karnza007/esp32_iot_gateway/docs/reports/2026-11-08-design.md

# Design report: the HDMI spectrum and spectrogram demo (week ending 2026-11-08)

> **What this is.** A complete explanation of the design as it runs on the Tang Nano 20K after
> this week's work (first written for commit `0211e95`, 2026-11-04; brought up to date for commit
> `eda5531`, 2026-11-07): how the microphone is sampled, how the FFT is fed and read, how every
> memory in the chip is used, how the three screens (bars, spectrogram, waveform) are drawn pixel
> by pixel, and how music from the laptop reaches the board's speaker. Each part has its own
> section, readable on its own.
> What changed this week and how it was tested step by step is in the weekly report,
> `docs/reports/2026-11-08.md`.

**The design in numbers**

| | |
|---|---|
| Board | Tang Nano 20K (Gowin GW2AR-18C) |
| Input | INMP441 MEMS microphone, I2S, pins 25 (SCK), 26 (WS), 29 (SD) |
| Output | HDMI, 1280 × 720 at 60 frames per second |
| Sample rate | **22,310.7 Hz** (0 – 11.2 kHz on screen) |
| FFT | Gowin FFT IP, 1,024 points, one every **512 samples** (50 % overlap): **43.6 per second** |
| Screens | **spectrogram** (the last 5.9 s, at power-up) → **bars** (the latest spectrum) → **waveform** (the last 45.9 ms): S1 steps, and they rotate by themselves every **6 s** (the pin-27 button freezes / resumes) |
| Music out | songs from the laptop (`host/play_song.py`) over the board's own USB cable (BL616 serial port, pins 70/69) → 24,170 Hz mono → the board's MAX98357A amplifier and speaker (§12A) |
| Resources | 3,153 logic (16 %), 1,415 registers (9 %), **43 / 46 block RAMs (93 %)**, 7.75 / 24 DSP |
| Timing | needs 74.25 MHz, achieves **77.2 MHz** (4 % spare) |

---

## Contents

0. [The whole design on one page](#0-the-whole-design-on-one-page)
1. [Clocks and reset](#1-clocks-and-reset)
2. [Sampling the microphone](#2-sampling-the-microphone)
3. [Gain and clamp](#3-gain-and-clamp)
4. [Storing samples: the ring buffer](#4-storing-samples-the-ring-buffer)
5. [Window and FFT](#5-window-and-fft)
6. [From FFT result to bar height](#6-from-fft-result-to-bar-height)
7. [Bars display](#7-bars-display)
8. [Spectrogram display](#8-spectrogram-display)
- 8A. [Waveform display](#8a-waveform-display-wave_displayv-2026-11-06)
9. [Peak readout](#9-peak-readout)
10. [Text, font and tick marks](#10-text-font-and-tick-marks)
11. [Putting the picture together and sending it over HDMI](#11-putting-the-picture-together-and-sending-it-over-hdmi)
12. [Buttons and LEDs](#12-buttons-and-leds)
- 12A. [Music from the laptop to the speaker](#12a-music-from-the-laptop-to-the-speaker-2026-11-06)
13. [RAM map: every memory in the chip](#13-ram-map-every-memory-in-the-chip)
14. [Resources and timing](#14-resources-and-timing)
15. [How it was verified](#15-how-it-was-verified)
- [Appendix A: glossary](#appendix-a-glossary)

---

## 0. The whole design on one page

```
                          ┌───────────────────────────── 74.25 MHz (pclk): everything below ─────────────────────────────┐
 INMP441                  │                                                                                               │
 mic ──SD──▶ i2s_master_rx ─▶ gain24 ─▶ clamp ─▶ ring buffer ─▶ × Hann ─▶ Gowin FFT ─▶ power → log → height ─┬─▶ bar_display ─────────┐
     ◀─SCK,WS─┘  (24 bits)    (S2)     ±32700   2048 samples    window    1024 points   (8-stage pipeline)   ├─▶ spectrogram_display ─┤ mode
                                                [block RAM]    [ROM]     [block RAM]                        ├─▶ peak_readout ──┐     │ picks
                                                                                                             │                  ▼     ▼
                                                                    video_timing ─ x, y ─▶ (all displays)    │          text_overlay ─▶ hdmi_out ─▶ HDMI
             (the gained samples) ─────────────────────────────────────────────────────────▶ wave_display ──────────────▶ (3rd picture)   (TMDS, 10:1
                                                                                                             │                           serializers)
 27 MHz crystal ─▶ PLL ×55÷4 = 371.25 MHz ─▶ ÷5 = 74.25 MHz        buttons S1 (mode), S2 (gain),            └──────────────────────────────────────┘
                                                                   pin 27 (rotate / freeze) ─▶ LEDs

 Music, separate from all of the above (§12A):
 laptop play_song.py ─USB─▶ BL616 ─pin 70─▶ uart_rx ─▶ audio_rx [2,048-sample buffer] ─▶ i2s_tx ─pins 54-56─▶ MAX98357A ─▶ speaker
                                  ◀─pin 69── uart_tx ◀── credits "C", status "S"              PA_EN (pin 51) ─┘
```

**Files** (all in `fpga_fft/src/`; `i2s_master_rx.v` is shared with the audio project in `fpga/src/`):

| Part | File | Section |
|---|---|---|
| Top level, buttons → mode/gain/rotation, LEDs | `top_hdmi.v`, `hdmi/buttons.v` | 1, 12 |
| The chain, wiring all parts | `hdmi/video_h3.v` | 0 |
| Microphone | `hdmi/mic_source.v`, `fpga/src/i2s_master_rx.v`, `hdmi/gain24.v` | 2, 3 |
| Ring buffer, window, FFT, heights | `hdmi/spectrum.v`, `hdmi/rom_hann.v`, `fft/fft_1024.vo` (Gowin IP) | 4, 5, 6 |
| Bars | `hdmi/bar_display.v` | 7 |
| Spectrogram | `hdmi/spectrogram_display.v`, `hdmi/rom_spec.v` | 8 |
| Waveform | `hdmi/wave_display.v`, `hdmi/rom_wave.v` | 8A |
| Music to the speaker | `hdmi/audio_rx.v`, `hdmi/i2s_tx.v`, `uart_rx.v`, `fpga/src/uart_tx.v`; laptop: `host/play_song.py`, `host/make_test_song.py` | 12A |
| Peak readout | `hdmi/peak_readout.v` | 9 |
| Text | `hdmi/text_overlay.v`, `hdmi/rom_text.v`, `hdmi/rom_font.v`, `hdmi/rom_ticks.v` | 10 |
| Video timing and HDMI | `hdmi/video_timing.v`, `hdmi/hdmi_out.v`, `hdmi/tmds_encoder.v` | 11 |
| Generated tables | `fpga_fft/gen_h4_text.py` (text, font, ticks, colours, waveform grid), `gen_tables.py` (Hann, sine) | 10, 5 |
| Not built any more | `fpga_fft/archive/sweep_player.v` (the demo sweep; git tag `demo-sweep`) | – |

**One clock for everything.** Except the HDMI serializers, the whole design runs on one clock,
74.25 MHz. The audio path is slow (a sample every 3,328 clocks), but running it on the picture
clock means no data ever crosses between clocks, which removes a whole class of bugs. Only a few
signals come from outside without a clock: the microphone's SD wire, the buttons and the serial
line from the laptop (pin 70); each goes through a two-flip-flop synchroniser first.

---

## 1. Clocks and reset

```
27 MHz crystal (pin 4) ──▶ rPLL ×55 ÷4 ──▶ 371.25 MHz (fclk) ──▶ HDMI serializers only
                                              └──▶ CLKDIV ÷5 ──▶ 74.25 MHz (pclk) ──▶ everything else
```

| Clock | Value | Why this value |
|---|---|---|
| pclk | **74.25 MHz** | the pixel rate the HDMI standard fixes for 1280 × 720 at 60 Hz: 1,650 × 750 slots × 60 |
| fclk | 371.25 MHz = 5 × pclk | each pixel is sent as 10 bits per colour; the serializer sends 2 bits per fclk cycle (both edges), 5 × 2 = 10 |

**Reset.** The PLL takes a moment to lock onto the crystal. Until it reports `locked`, and for 16
pixel clocks after that, the whole picture chain is held in reset (`top_hdmi.v`, `vrst`).

---

## 2. Sampling the microphone

### 2.1 How I2S works

The INMP441 is a digital microphone: it has its own converter inside and sends finished numbers
over three wires. The FPGA is the **master**: it makes both clocks; the microphone only answers
on SD.

```
 SCK  ─┐_┌─┐_┌─┐_┌─┐_┌─┐_┌─ ... (1.428 MHz: one bit per period)
 WS   ──┐______________________________ ... ________┌────────── ... (left half | right half)
 SD   ────< 23 >< 22 >< 21 >  ...  < 0 >── (24 bits, MSB first, then nothing)
        bit:  1     2     3          24         ... 32 (WS low: left)       33 ... 64 (right, unused)
```

| Wire | Driven by | What it does |
|---|---|---|
| **SCK** (bit clock) | FPGA | one data bit per period |
| **WS** (word select) | FPGA | low = left word, high = right word; one full low+high period = **one sample** |
| **SD** (serial data) | mic | the sample, 24 bits, most significant bit first. The mic's L/R pin is tied to ground, so it talks in the **left** half only |

### 2.2 The numbers: why 22,311 Hz

```
SCK = 74.25 MHz ÷ 52 = 1.4279 MHz           (MIC_BCLK_DIV = 52 in video_h3.v)
one sample = 64 SCK periods (32 left + 32 right)
fs  = 74.25 MHz ÷ (52 × 64) = 74,250,000 ÷ 3,328 = 22,310.7 samples per second
```

- A new sample arrives every **3,328 pixel clocks** (44.8 µs).
- The highest frequency that can be seen is half the sample rate: **11,155 Hz**.
- The INMP441 accepts SCK between 0.5 and 3.2 MHz; 1.43 MHz is comfortably inside.
- The rate is an exact integer division of the crystal, so it is as steady as the crystal.

### 2.3 How `i2s_master_rx.v` makes the clocks and reads the bits

| Step | How |
|---|---|
| SCK | a counter `div_cnt` counts 0 … 51 and repeats. SCK is high while the count is below 26, low after. SCK comes **out of a flip-flop**, never straight from the comparison: a comparison can flicker for a nanosecond while its inputs settle, and on a pin the mic would count that flicker as an extra bit (this was a real bug, found 2026-10-14). |
| Bit number | `bit_cnt` (6 bits) counts SCK periods 0 … 63 and wraps: one wrap = one sample |
| WS | high for bits 32 … 63. It changes on the **falling** edge of SCK, half a bit early, as the I2S standard requires, so it is steady when the mic reads it on the rising edge (also a real bug fix, 2026-10-14). |
| SD in | passes two flip-flops first (`sd_meta`, `sd_sync`): the mic's edges are not related to our clock, and the synchroniser stops an undecided level from spreading |
| Reading a bit | at count 13, the **middle of SCK's high half**, when the mic's output has long settled |
| Which bits | bits 1 … 24 of the frame (the mic starts its MSB one bit after WS falls). Each is shifted into `word24` |
| Output | after the 24th bit: `sample24` = the whole 24-bit word, and `sample_valid` is high for one clock. Bits 25 … 64 are clocked out normally (the mic needs complete frames) but ignored |

**Memory used:** none. A 24-bit shift register and a few counters.

---

## 3. Gain and clamp

### 3.1 Gain: choosing 16 of the 24 bits (`gain24.v`, button S2)

The mic gives 24 bits, the FFT takes 16. Instead of always keeping the top 16 bits and
multiplying, the gain **slides a 16-bit window down** the 24-bit word:

```
24-bit word:  [23 22 21 20 19 18 17 16 15 14 13 12 11 10  9  8  7  6  5  4  3  2  1  0]
gain 0 (×1)    └────────────────── bits 23 … 8 ──────────────────┘
gain 4 (×16)               └────────────────── bits 19 … 4 ──────────────────┘
gain 7 (×128)                       └────────────────── bits 16 … 1 ──────────────────┘
```

- Done as an arithmetic shift right by `8 − gain`. Each step is ×2 = **+6 dB**; 0 … +42 dB.
- Taking lower bits uses the microphone's real fine detail, not a multiplied coarse value.
- If the shifted value does not fit in 16 bits (a loud sound at high gain), it is **held at the
  limit** (+32,767 or −32,768) instead of wrapping around, and `clipped` pulses.

### 3.2 Clamp (`spectrum.v`)

Before the FFT, every sample is limited to **±32,700**. The Gowin FFT core gives wrong results
for inputs near −32,768 (found in the FFT benchmark, `docs/11-fft-benchmark.md`); 32,700 keeps
clear of that.

**Memory used:** none.

---

## 4. Storing samples: the ring buffer

### 4.1 What it is

The FFT needs **1,024 samples at once**, but they arrive one at a time, 44.8 µs apart. They are
kept in a **ring buffer**: a memory of 2,048 places, written in order, starting again at 0 after
2,047, so the newest samples always overwrite the oldest.

```
 buf_mem (2,048 × 16 bits, block RAM)                         wptr = where the next sample goes
 ┌──────────────────────────────────────────────────────────────────────┐
 │ ... older ... │◀────────── the latest 1,024 samples ──────────▶│ next │ ... free (will be overwritten) ...
 └──────────────────────────────────────────────────────────────────────┘
                 ready_base = wptr − 1023                        wptr
```

| Property | Value |
|---|---|
| Memory | `buf_mem`, **2,048 × 16 bits = 32,768 bits = 2 block RAMs**, semi-dual-port (one write port, one read port) |
| Stored | **raw** samples (after gain and clamp, before the window) |
| Written by | the sample path: one write per sample, every 3,328 clocks, at `wptr`, which then counts up (11 bits, so it wraps at 2,048 by itself) |
| Read by | the FFT feeder (§5): 1,024 reads in a row, starting at `rbase` |

### 4.2 When an FFT starts (50 % overlap)

A counter `hop_cnt` counts samples. Every **512** samples (`OVERLAP = 1`), once the first 1,024
have arrived, `block_ready` pulses and `ready_base = wptr − 1023` marks where the latest 1,024
samples begin.

```
samples:   0 ──────── 512 ──────── 1024 ──────── 1536 ──────── 2048 ──────── 2560 ...
FFT 0:     [═══════════════════════]                                   (samples 0 – 1023)
FFT 1:                [═══════════════════════]                        (512 – 1535)
FFT 2:                             [═══════════════════════]           (1024 – 2047)
FFT 3:                                          [═══════════════════════]   (1536 – 2559)
           each FFT shares half its samples with the one before
```

| | Without overlap (`OVERLAP = 0`) | **With overlap (the demo)** |
|---|---|---|
| New FFT every | 1,024 samples = 45.9 ms | **512 samples = 22.9 ms** |
| FFTs per second | 21.8 | **43.6** |

### 4.3 Why the ring holds raw samples

With overlap, every sample is used by **two** FFTs, and it sits at a different place in each
(first half in one, second half in the other), so it gets a **different window value** each time.
The window can therefore not be applied once when storing; it is applied when the FFT reads
(§5.1). (Until 2026-11-04 the window was applied when storing, which is only right without
overlap.)

### 4.4 Why nothing is ever overwritten too early

The FFT reads the latest 1,024 samples in 1,024 clocks, and is finished with them after
7,190 clocks. In that time only 2 – 3 new samples arrive, and they go into the *other* 1,024
places of the ring. The next FFT starts 1.7 million clocks later. If an FFT were ever still
busy when the next block was ready, the `overrun` flag would be set and LED 4 would light; it
never does.

---

## 5. Window and FFT

### 5.1 The Hann window

Each block is multiplied by the **Hann window**, a smooth bump that is 0 at both ends and 1 in
the middle:

```
window(i) = 0.5 − 0.5 cos(2π i / 1024),   i = 0 … 1023      stored as 0 … 32,767 (Q15)
```

**Why:** the FFT assumes the block repeats forever. If a block starts and ends at different
levels, the jump between the copies spreads energy over all frequencies ("leakage"), and a
pure tone shows as a wide smear. Fading the ends to zero removes the jump.

| Property | Value |
|---|---|
| Memory | `rom_hann`, **1,024 × 16 bits, 1 block RAM used as ROM** (the contents are part of the bitstream; generated by `gen_tables.py`) |
| Read | with the same address `i` as the sample, at the same clock |
| Arithmetic | `sample × window ÷ 32,768`, one DSP multiplier: the product's bits 30 … 15 |

### 5.2 Feeding the Gowin FFT core

The FFT core is Gowin's IP (`fft_1024`, configured in `fft/fft_1024.ipc`: 1,024 points, 16-bit
input, 16-bit twiddle factors, low-resource mode, results in natural order). It is a radix-2
FFT: 10 stages of 512 "butterflies" each (see the benchmark, `docs/11-fft-benchmark.md` §9.2a).

The core **asks** for its input: after a `start` pulse it raises `ipd` (input phase) and shows
which sample it wants on `idx`. Our block RAMs answer one clock after they are given an
address, so the feeder addresses one sample **ahead**:

```
clock:            t          t+1          t+2
core wants idx:   i          i+1          i+2
we address:       i+1        i+2          i+3        ← ridx = idx + 1 (0 while not ipd)
RAM answers:      sample i   sample i+1   ...        ← rd_q and hann arrive together
into the core:    rd_q × hann ÷ 32768  (sample i)   ← the multiply is between the RAM and the core
```

- Ring address = `rbase + ridx` (11 bits, wraps around the ring by itself).
- Window address = `ridx` (the position inside the block).
- `xn_im` (the imaginary input) is 0: the microphone signal is real.

### 5.3 What the core does and how long it takes

| | |
|---|---|
| Input | 1,024 real samples |
| Output | 1,024 complex numbers `xk_re + j·xk_im`, in order: bin k = frequency k × fs / 1024 = **k × 21.79 Hz** |
| Scaling | divided by 2 at each stage, so results stay within 16 bits |
| Time | **7,190 clocks = 96.8 µs** from `start` to the last result: **0.4 %** of the 22.9 ms between FFTs |
| Output handshake | `opd` (output phase) high while results come out, one per clock, `idx` = bin number; `eoud` = last one |

**The core's own memory** (its source is encrypted; the build report shows its totals):

| Memory | Count | Most likely use |
|---|---|---|
| **True dual-port block RAM** (DPB) | 4 | the working values: a butterfly reads two values and writes two back in place, so it needs two ports that can each read **or** write. (This is why the Tang Nano 4K cannot build this core: it has no true dual-port RAM.) |
| Block RAM as ROM (pROM) | 2 | the twiddle factors (cos and sin values for the butterflies) |
| Small logic RAMs (RAM16SDP4) | 3 | small internal buffers, 16 × 4 bits each |

### 5.4 Only half the bins are kept

For a real input, bins 513 … 1023 are mirror images of bins 1 … 511. Only bins **0 … 511**
(0 – 11.1 kHz) are kept. That is where the 512 bars and the 256 spectrogram rows come from.

---

## 6. From FFT result to bar height

### 6.1 The pipeline

As the core outputs one bin per clock, an **8-stage pipeline** turns each bin into a height in
pixels. Every stage is one clock; a new bin enters every clock, so 512 bins take 512 + 8 clocks.

| Stage | Register | Computes |
|---|---|---|
| 1 | `re1`, `im1`, `a1` | keep bins 0 … 511 |
| 2 | `sq_re`, `sq_im` | re², im² (two DSP multipliers) |
| 3 | `pw` | **power** P = re² + im² (32 bits) |
| 4a | `e4`, `m4` | position `e` of P's highest 1 bit, and the 5 bits just below it |
| 4b | `L` | **L = 32 · log₂ P** ≈ 32·e + table(5 bits) (a 32-entry table) |
| 5 | `hm` | 361 · L (one DSP multiplier) |
| 6 | `bar_h` | height = (361 L − 39,587) / 512, limited to 0 … 600 px |
| out | `bar_we`, `bar_addr`, `bar_h`, then `bar_done` | one height per clock; `bar_done` pulses after the 512th |

### 6.2 The decibel scale

```
dB      = 10 · log10(P) − 90.31          (0 dB = a bin of 32,767, the largest possible)
height  = 7.5 px per dB, 0 dB at 600 px, −80 dB at 0 px  →  height = 75 · log10(P) − 77.32
log10 P = L / 32 · 0.30103               →  height = (361 · L − 39,587) / 512
```

- The log uses only a top-bit search and a 32-entry table: no division, no big multiplier.
- Anything quieter than −80 dB gets height 0 ("the floor").
- Stage 4 used to be one stage; in one clock it took 13.24 of the 13.47 ns available, so it was
  split into 4a and 4b (weekly report §8).

**Memory used:** none (the 32-entry log table is logic).

**Where the heights go.** The same stream (`bar_we`, `bar_addr`, `bar_h`, `bar_done`) goes to
three places at once: the bars display (§7), the spectrogram (§8) and the peak readout (§9).

---

## 7. Bars display

### 7.1 Layout

```
 y =  60 ─ 0 dB   ┌──────────────────────────────────────────────┐   gridlines every 20 dB:
 y = 210 ─ -20 dB │                                              │   y = 60, 210, 360, 510, 660
 y = 360 ─ -40 dB │      ▌                                       │
 y = 510 ─ -60 dB │      ▌ ▌        ▌                            │   512 bars, 2 px wide each:
 y = 660 ─ -80 dB └▌▌▌▌▌▌▌▌▌▌▌▌▌▌▌▌▌▌▌▌▌▌▌▌▌▌▌▌▌▌▌▌▌▌▌▌▌▌▌▌▌▌▌▌┘   x = 128 … 1151
                  0 kHz                                      11 kHz    bar k: x = 128 + 2k, 129 + 2k
```

### 7.2 The memory: a double buffer

| Property | Value |
|---|---|
| Memory | `mem`, **1,024 × 10 bits = 1 block RAM**, semi-dual-port |
| Layout | two halves of 512 heights: address = {half, bin} |
| Written by | the height pipeline, into the **back** half: `mem[{~front, bar_addr}] = bar_h` |
| Read by | the screen, from the **front** half |

**Why two halves.** The screen draws a frame top to bottom over 16.7 ms; a new set of 512
heights arrives in 512 clocks (7 µs) at any moment. If the screen read the half being written,
part of a frame would show the old spectrum and part the new one. So new heights go into the
back half, and when a set is complete (`bar_done` → `pending`), the halves **swap** at the start
of the vertical blanking (`x = 0, y = 720`), when nothing visible is being drawn.

### 7.3 How a pixel is drawn (2 clocks)

| Clock | Does |
|---|---|
| 1 | bar number = (x − 128) / 2; read `h = mem[{front, bar}]` |
| 2 | **green** (00DC5A) if x is in 128 … 1151 and 660 − h ≤ y < 660; else **grey** (464646) on a gridline row; else black |

---

## 8. Spectrogram display

> Updated 2026-11-06: 32 levels of 1 dB with viridis colours (was 16 levels of 5 dB, inferno),
> and two frequency zones (was 2 bins per row everywhere). Weekly report §13–14.

### 8.1 What it shows

Every FFT becomes one **column** of a picture: time runs left to right (newest at the right
edge), frequency bottom to top, colour = level. The last 256 FFTs are shown: 256 × 22.9 ms =
**5.9 s**.

```
 kHz                                                   dB
 10 ┤ ░░░░░░░░░░░░░░░░░░░░░░░░░░░░░░░░░░░░░░░░░░░░░ ┃□┃ >-50    plot: x 128 … 1151, y 148 … 659
  6 ┤ ░░░░░░░░░░░░░░░░░░░░░░░░░░░░░░░░░░░░▄▀░░░░░░░ ┃▓┃ -50     4 … 11 kHz: rows 184 … 255 (28 %)
  4 ┤ ─ ─ ─ ─ ─ ─ ─ ─ ─ ─ ─ ─ ─ ─ ─ ─ ─ ─ ─ ─ ─ ─ ─ ┃▓┃         dashed line at the zone edge
  2 ┤ ░░░░░░░░░░░░░░░░░░░░░░░░░░░░░░▄▀▀░░░░░░░░░░░░ ┃▒┃ -70     0 … 4 kHz: rows 0 … 183 (72 %)
  0 ┤ ░░░░░░░░░░░░░░░░░░░░░░░░░░░░░░░░░░░░░░░░░░░░░ ┃░┃ -80     one point = 4 px wide × 2 px tall
    -5s        -4s       -3s       -2s       -1s    now          colour scale: x 1168 … 1183
```

### 8.2 Rows: two frequency zones

| Zone | Bins | Rows | One row | Height |
|---|---|---|---|---|
| 0 … 4.0 kHz | 0 … 183 | 0 … 183, row = bin | **one bin, 21.8 Hz** (the finest the 1024-point FFT gives) | 368 px (72 %) |
| 4.0 … 11.1 kHz | 184 … 511 | 184 … 255, row = 184 + (bin − 184) × 225 / 1024 (rounded down) | 4 or 5 bins, about 99 Hz | 144 px (28 %) |

Where a row holds several bins it keeps the **loudest**, so a thin tone is never lost. The cost:
the noise above 4 kHz looks a little louder than it is (on the board, 34 % of points black
there against 45 % just below 4 kHz).

### 8.3 Levels: one per dB

The height scale is 7.5 px per dB with −80 dB at height 0, so dB = height / 7.5 − 80.

| Level | dB | Colour |
|---|---|---|
| 0 | below −80 (height 0) | black: also hides the FFT's own rounding noise |
| 1 … 30 | −80 … −51, one per dB: level = height / 7.5 + 1 | matplotlib's "viridis": dark purple → blue → teal → green → yellow |
| 31 | −50 and louder (height ≥ 225) | white |

### 8.4 The memory: a 256 × 256 picture

| Property | Value |
|---|---|
| Memory | 65,536 × **5 bits** = 327,680 bits, kept as two memories: `mem_lo` 65,536 × 4 (**16 block RAMs**) + `mem_hi` 65,536 × 1 (**4 block RAMs**) = **20**, semi-dual-port |
| Why two | a single 5-bit memory could be built 8 bits wide (32 blocks), which would not fit |
| Layout | address = {column (8 bits), row (8 bits)}: 256 columns of 256 rows |
| Each entry | a **level** 0 … 31, not a colour: 5 bits instead of 24, which is what makes it fit |
| Written by | the height stream, one column per FFT |
| Read by | the screen, one point per pixel |

### 8.5 Writing a column (4 clocks)

The 512 heights arrive in bin order (`bar_we`, `bar_addr`, `bar_h`), then `bar_done`.

| Clock | How |
|---|---|
| A: row | bins 0 … 183: row = bin, and each is the last bin of its row. Bins 184 … 511: d = bin − 184, row = 184 + (d × 225) >> 10 (one DSP multiplier). The next bin starts a new row exactly when the low 10 bits of d × 225 are 799 or more (adding 225 then carries), so the same product also says "last bin of this row"; bin 511 is always last |
| B: loudest | keep the largest height of the current row (`acc`); at the row's last bin, pass it on |
| C: level | 0 if height is 0; 31 if height ≥ 225; else (height × 547) >> 12, + 1 (exactly height / 7.5, rounded down, for heights below 225; one DSP multiplier) |
| D: write | `mem_lo/mem_hi[{wcol, row}] = level`; after `bar_done`, `wcol` counts up by 1 (8 bits: after 255 comes 0) |

So after 256 FFTs the memory is full, and every new column **overwrites the oldest**.

### 8.6 Scrolling without moving anything

Moving 65,536 values every 22.9 ms would be slow and pointless. Instead, only **where the screen
starts reading** moves:

```
memory columns:   ... │ 41 │ 42 │ 43 │ 44 │ 45 │ ... (wcol = 44 is written next: it is the oldest)
screen columns:          ...  254   255 │  0    1  ...
                                 newest ┘  └ oldest       start = 44
screen column c shows memory column (start + c) mod 256
```

- `start` is copied from `wcol` once per frame, at the start of vertical blanking, so a frame
  never shows two scroll positions.
- The column being overwritten during a frame is always the oldest, at the left edge (screen
  column 0). It is drawn black, so its half-written state never shows.

### 8.7 How a pixel is drawn (2 clocks)

| Clock | Does |
|---|---|
| 1 | column = start + (x − 128) / 4, row = (659 − y) / 2; read `q = {mem_hi, mem_lo}[{column, row}]` |
| 2 | on y 291 inside the plot where x bit 2 is 0: **grey dash** (808080, the 4 kHz edge); inside the plot: **colour table[q]**; inside the scale (x 1168 … 1183): white for the top 32 px, then colour table[32 − (y − 148) / 16] (levels 30 … 1, 16 px each); on a tick mark: grey (808080); else black |

### 8.8 The colour table (`rom_spec.v`, logic)

32 entries: black, 30 viridis colours sampled evenly, white.

| Level | dB | Colour | Level | dB | Colour |
|---|---|---|---|---|---|
| 0 | below −80 | 000000 black | 16 | −65 | 1F948C |
| 1 | −80 | 440154 dark purple | 18 | −63 | 21A585 |
| 3 | −78 | 481A6C | 20 | −61 | 31B57B |
| 5 | −76 | 46307E | 22 | −59 | 50C46A green |
| 7 | −74 | 404588 | 24 | −57 | 77D153 |
| 9 | −72 | 38598C blue | 26 | −55 | A2DA37 |
| 11 | −70 | 2F6B8E | 28 | −53 | D2E21B |
| 13 | −68 | 297B8E | 30 | −51 | FDE725 yellow |
| 15 | −66 | 228C8D teal | 31 | −50 and louder | FFFFFF white |

(Every second level shown; the full list is `SPEC_RGB` in `gen_h4_text.py`.)

## 8A. Waveform display (`wave_display.v`, 2026-11-06)

The third screen: the raw samples, like an oscilloscope.

| Part | How |
|---|---|
| Samples | the same 16-bit samples the FFT gets (after the S2 gain, so S2 also zooms the wave) |
| Width | 1,024 samples = 45.9 ms (one FFT block), 1 px per sample, x 128 … 1151; ticks every 5 ms |
| Height | y 148 … 659, centre y 403. The edges are the peak of a tone reading **−40 dB** on the bars / spectrogram scale: 4 × 32,767 × 10^(−40/20) = **±1,311**. Offset = sample × 800 / 4096 (rounded down), limited to −256 … 255; y = 403 − offset. At an edge the trace is red |
| Grid | centre, the peaks of −50 dB (±414) and −60 dB (±131) tones, the edges (`rom_wave.v`) |
| Trigger | a capture starts where the wave crosses 0 going up (previous < 0, this ≥ 0), or after 1,024 samples without one, so a steady tone stands still |
| Memory | 2 × 1,024 offsets × 9 bits = **1 block RAM** (SDPX9B), double-buffered: a capture fills the back half, the halves swap in vertical blanking, then the next capture is armed (about 20 pictures per second) |
| Drawing (2 clocks) | read the column's offset; light the pixels from the previous column's height to this one's, so steep parts stay joined; else grid grey, tick grey, black |

---

## 9. Peak readout

Top right of every screen: the loudest frequency and its level, e.g. "1002 Hz / −23 dB", and
the gain.

| Step | How |
|---|---|
| ① Loudest bin of each FFT | while heights stream in, keep the tallest (skipping bins 0 – 1: the DC offset, which the window spreads into bin 1). At `bar_done`, store it as that FFT's peak |
| ② Show 4 times a second | every 2²⁴ clocks (0.23 s) the **latest** FFT's peak is taken, slow enough to read |
| ③ Frequency | Hz = bin × fs / 1024 = (bin × 1,427,884 + 32,768) >> 16, rounded to the nearest Hz |
| ④ Digits | 5 decimal digits, one per clock: n / 10 is done as (n × 52,429) >> 19 (a multiply instead of a divide); leading zeros become spaces |
| ⑤ Level | dB = height / 7.5 − 80: lvl = ((2h + 7) × 4,369) >> 16, two digits |
| ⑥ Output | 11 characters (77 bits, `dyn`): 5 for Hz, 4 for dB, 2 for the gain; "---" when nothing is above −80 dB |

**Memory used:** none (registers only). The 11 characters go to the text overlay (§10.4).

---

## 10. Text, font and tick marks

### 10.1 The text grid

The 1280 × 720 picture is divided into **80 × 45 cells of 16 × 16 pixels**. Each cell can hold
one character. A character is a 5 × 7 dot pattern inside an 8 × 8 box, drawn **2× larger**
(each dot is 2 × 2 pixels).

```
 cell (row, col) covers x = 16·col … 16·col+15, y = 16·row … 16·row+15
 inside a cell:  dot column = (x mod 16) / 2  (0 … 7),  dot row = (y mod 16) / 2  (0 … 7)
```

### 10.2 The three tables

| Table | File | Memory | Contents |
|---|---|---|---|
| **Text** | `rom_text.v` | **block RAM as ROM: 5 blocks** (7,200 × 9 bits used) | for every cell of both pages: which character, which colour. Address = page × 3,600 + row × 80 + column. Word = [8:7] colour, [6:0] ASCII code; codes 0 – 15 mean "live character k" (from the peak readout) |
| **Font** | `rom_font.v` | **block RAM as ROM: 1 block** (1,024 × 8 bits) | the dot pattern of every character: address = {ASCII code, dot row}, 8 bits = one row of 8 dots, leftmost dot = bit 7 |
| Tick lines (bars page) | `rom_ticks.v` | logic | is x one of the 12 kHz tick positions? |

All three are generated by `fpga_fft/gen_h4_text.py`, which also draws previews
(`docs/figures/h4_layout.png`, `h4_layout_spectrogram.png`). The kHz and time positions are
computed there from the sample rate, so they move by themselves if the rate changes.

**Two pages.** The text table holds a complete page per screen: page 0 = bars, page 1 =
spectrogram. S1 selects the page together with the picture.

### 10.3 How the display pulls out each character, clock by clock

This is the heart of the text drawing (`text_overlay.v`). For every pixel (x, y), four clocks:

```
 clock 1          clock 2               clock 3                    clock 4
 x, y ─▶ address ─▶ text ROM ─▶ code ──▶ (live? take from peak) ──▶ font ROM ─▶ 8 dots ─▶ pick dot ─▶ colour
         page·3600            colour       ASCII code + dot row        of this row   (x mod 16)/2
         + row·80 + col                                                                 
```

| Clock | What happens | Example: pixel (x 1174, y 90) on the bars page, PEAK showing " 1002 Hz" |
|---|---|---|
| 1 | cell row = y / 16, cell column = x / 16; address = page × 3,600 + row × 80 + column | row 5, column 73 → address 0 + 400 + 73 = 473 |
| 2 | the **text ROM** answers: colour and code | yellow, code 1 → "live character 1" |
| 3 | live? → take the character from the peak readout's `dyn` instead. Then the **font ROM** is addressed with {code, dot row = (y mod 16)/2} | live char 1 = the thousands digit = "1"; dot row = (90 mod 16) / 2 = 5 |
| 4 | the font answers 8 dots; pick dot (x mod 16)/2; if it is lit, the pixel gets the cell's colour | row 5 of "1" is `...#....`; dot (1174 mod 16) / 2 = 3 is lit → **yellow** FFD23C |

Because each step is a registered memory read, a new pixel enters every clock and the answer
comes out 4 clocks later. The sync signals (DE, HSYNC, VSYNC) are delayed by the same 4 clocks
(`video_h3.v`), so colour and position stay together.

**Colours:** 0 white (title), 1 light grey (axis labels), 2 yellow (peak readout), 3 cyan
(source, gain).

### 10.4 Live characters

Eleven cells show changing values (peak Hz, peak dB, gain). Their table entry is not a letter
but a number k = 0 … 10, meaning "show character k of `dyn`". The peak readout (§9) keeps `dyn`
up to date; the text ROM itself never changes.

### 10.5 Why the text table is in block RAM

Until 2026-11-04 the text table was built from logic (a big `case` statement): 400 logic cells,
11 cells deep, and the slowest path in the design (13.25 of 13.47 ns). A block RAM answers any
address in one clock with a short fixed delay, so the table now costs 5 block RAMs and no
logic, and the path is gone (weekly report §12).

---

## 11. Putting the picture together and sending it over HDMI

### 11.1 Video timing (`video_timing.v`)

Two counters run through **every slot of a frame**, visible or not:

```
 per line:   1280 visible + 110 front porch + 40 sync + 220 back porch = 1,650 slots
 per frame:   720 visible +   5 front porch +  5 sync +  20 back porch =   750 lines
 74.25 MHz / (1,650 × 750) = 60.00 frames per second
```

| Output | Meaning |
|---|---|
| x, y | current slot and line |
| DE | "data enable": inside the visible 1280 × 720 |
| HSYNC, VSYNC | the pulses that tell the monitor "new line" / "new frame" |

The blanking time (everything that is not visible) is where the bars swap halves and the
spectrogram takes its new scroll position.

### 11.2 Layers: who wins a pixel

Every clock, all displays work on the same (x, y). The final colour is chosen in this order:

| Priority | Layer | Source |
|---|---|---|
| 1 | outside the visible area → black | DE |
| 2 | **text** (a lit dot of a character) | text overlay §10 |
| 3 | kHz tick line (bars page, only where the picture is black) → dark grey 2A2A2A | `rom_ticks` |
| 4 | **picture**: bars (page 0), spectrogram (page 1) or waveform (page 2) | §7 / §8 / §8A, chosen by the mode |

All three pictures are computed all the time; the mode only chooses which one is passed on (and
which text page). That is why switching to the spectrogram shows its full history at once.

### 11.3 Sending the picture (`hdmi_out.v`, `tmds_encoder.v`)

```
 blue  + HSYNC, VSYNC ─▶ TMDS encoder ─ 10 bits ─▶ OSER10 ─▶ differential pair ─▶ HDMI data 0 (pins 35/36)
 green                ─▶ TMDS encoder ─ 10 bits ─▶ OSER10 ─▶ differential pair ─▶ HDMI data 1 (pins 37/38)
 red                  ─▶ TMDS encoder ─ 10 bits ─▶ OSER10 ─▶ differential pair ─▶ HDMI data 2 (pins 39/40)
 clock pattern 1111100000 ───────────────────────▶ OSER10 ─▶ differential pair ─▶ HDMI clock  (pins 33/34)
```

| Part | Does |
|---|---|
| **TMDS encoder** | turns each 8-bit colour into a 10-bit word chosen to have few transitions and an even balance of 1s and 0s (good for the cable). During blanking it sends one of four special words instead, which carry HSYNC and VSYNC (on the blue lane) |
| **OSER10** | Gowin's serializer inside the pin's I/O block: takes 10 bits per pixel clock and sends them one by one on both edges of fclk (371.25 MHz × 2 = 742.5 Mbit/s per lane) |
| **TLVDS_OBUF** | drives each bit as a differential pair (P and N) |

**Memory used:** none.

---

## 12. Buttons and LEDs

| Button | Pin | Does |
|---|---|---|
| **S1** | 88 | screen, in turn: spectrogram → bars → waveform → spectrogram (starts on the spectrogram; three screens since 2026-11-06) |
| **S2** | 87 | gain +6 dB, 0 → +42 dB, then back to 0 |
| external | 27 (to 3.3 V, pull-down) | auto-rotate on ↔ frozen: on (at power-up), the screen moves on every 6 s (10 s until 2026-11-07); S1 also restarts the count. (Earlier on 2026-11-06 it played the demo sweep, now archived; weekly report §15–17, §19) |

**Mode and rotation (`top_hdmi.v`).** `mode` is 2 bits: 0 = bars, 1 = spectrogram (power-up),
2 = waveform. "Next" steps 1 → 0 → 2 → 1 and happens when S1 is pressed, or, while rotation is on,
when a counter reaches 445,500,000 clocks (6.0 s; it was 742,500,000 = 10 s until 2026-11-07).
Every "next" and every press of the pin-27 button restarts the counter; the pin-27 button
toggles `rot_on` (1 at power-up).

**Debouncing (`buttons.v`).** A button's contact bounces for a few milliseconds. The input goes
through a synchroniser and is looked at only every 2¹⁸ clocks (3.5 ms); a press counts when it
reads "down" twice in a row after "up", and produces exactly one one-clock pulse.

| LED (lit = low) | Shows |
|---|---|
| 0 | on = spectrogram screen |
| 3 | on = waveform screen (LEDs 0 and 3 both off = bars) |
| 2 | the mic's SD wire is active (seen high and low in the last 56 ms) |
| 4 | trouble: an FFT overran, or the music had a bad packet, a gap or an underrun (last 56 ms) |
| 5 | the video PLL is locked |
| 1 | auto-rotate on |

---

## 12A. Music from the laptop to the speaker (2026-11-06)

Separate from the measuring chain: the music reaches the spectrogram only through the air
(speaker → microphone). Replaces the demo sweep (archived, weekly report §15–17).

```
 laptop                                   board
 play_song.py ──USB──▶ BL616 debugger ──pin 70──▶ uart_rx ─▶ packet check ─▶ buffer 2,048 ─▶ ×2 fill-in ─▶ i2s_tx ─▶ MAX98357A
   ffmpeg: any file → 24,170 Hz mono  (2nd serial channel)   2.97 Mbaud     (sum16)        (2 block RAMs)  48,340 Hz     pins 56/55/54
              ◀──────────── "C" per 256 samples played, "S" + 4 counters ◀── uart_tx ◀──pin 69                          PA_EN pin 51
```

### 12A.1 The link

| Part | How |
|---|---|
| Cable | the board's own USB-C cable: the BL616 debugger chip is both the programmer (1st channel, `/dev/cu.usbserial-…0`) and a USB serial port (2nd channel, `…1`) wired to FPGA pins 70 (in) and 69 (out) (pins from Sipeed's `TangNano-20K-example/uart`) |
| Speed | the laptop opens 3 Mbaud; the FPGA reads 74.25 MHz / 25 = 2.97 Mbaud (1 % apart) |
| Measured limits (weekly report §19) | laptop → FPGA: nothing lost in any test, up to **170 KB/s** in writes of 512 bytes or more; FPGA → laptop: clean only up to about 30 KB/s, so used for a few bytes only |
| Load | 24,170 Hz × 2 bytes + packet overhead = 52 KB/s (31 % of 170 KB/s) |

### 12A.2 Packets

```
 B5 6A | seq | s0 lo, s0 hi, s1 lo, … s31 hi | sum16 lo, sum16 hi        69 bytes = 32 samples
```

| Field | Meaning |
|---|---|
| `B5 6A` | sync: where a packet starts. After a broken byte the receiver looks for it again |
| seq | 0 … 254, then 0 again; a jump counts as a gap. **seq 255 = RESET**: empty the buffer and stop; answered "R" |
| samples | 32 × 16-bit signed, low byte first, 24,170 Hz mono |
| sum16 | the 64 sample bytes added up, mod 65,536. A packet with a wrong sum is dropped whole |

The samples are written into the buffer as they arrive, but the write pointer only moves past
them ("commit") when the sum is right, so a bad packet leaves no trace.

### 12A.3 Flow control by credits

The FPGA's clock decides the pace; the laptop only sends what fits.

| Step | |
|---|---|
| After RESET | the laptop may send 1,536 samples (the buffer holds 2,048; 512 stay spare) |
| Every 256 samples played | the FPGA sends "C" on pin 69: the laptop may send 256 more |
| Every 16th "C" | followed by "S" and four counters: bad sums, seq gaps, packets dropped for lack of room, underruns (each stops at 255) |

So the buffer cannot overflow, and the two crystals (laptop, board) never need to agree.

### 12A.4 Playing (`audio_rx.v`, `i2s_tx.v`)

| Part | How |
|---|---|
| Start | when the buffer holds 1,024 samples (42 ms at 24,170 Hz) |
| Fill-in | `i2s_tx` asks for a sample every output frame (48,339.8 Hz = 74.25 MHz / 1536); each received sample x serves two: x[n], then (x[n] + x[n+1]) / 2. The music keeps its 24,170 Hz content (up to about 11 kHz) without steps |
| Underrun | if the buffer is empty when a sample is needed, the last one is held and counted; after 4,096 empty frames (85 ms) playing stops (the song ended) and the output goes to 0 |
| I2S out | `i2s_tx.v` (from the archived sweep player, unchanged): BCLK 1.547 MHz, 32 bit clocks per frame, same sample on left and right, Philips format, WS and DIN changing when BCLK falls |
| PA_EN | on while there is data or music, and 100 ms after: the amplifier is off (silent) between songs |
| Trouble | a bad packet, a gap or an underrun lights LED 4 for one 56 ms window |

### 12A.5 The laptop side

| Script | Does |
|---|---|
| `host/play_song.py song [--volume dB]` | ffmpeg decodes any file to 24,170 Hz mono 16-bit (+0.2 s of silence), sends RESET and waits for "R", then sends packets 8 or more at a time as credits arrive; prints progress and the FPGA's counters; Ctrl-C sends RESET |
| `host/make_test_song.py` | a 14 s piano-like "Happy Birthday" (harmonics with fading envelopes) for testing |

Played on the board: "Happy Birthday" (14.2 s in 14.8 s) and Mozart's Rondo alla Turca
(193.6 s in 194.2 s), each with 0 bad sums, 0 gaps, 0 dropped, 0 underruns.

**Memory used:** the 2,048 × 16 buffer, 2 block RAMs (§13).

---

## 13. RAM map: every memory in the chip

### 13.1 The types of memory on the GW2AR-18C

| Type | On this chip | What it is | We use it for |
|---|---|---|---|
| **Block RAM (BSRAM)** | 46 blocks × 18 Kbit ≈ 100 KB | on-chip SRAM: no refresh, one access per clock per port, any address. Each block can be set up as one of the modes below | all buffers, pictures and tables (32 blocks) |
| ↳ **SDPB** (semi-dual-port) | | one port only writes, the other only reads, each with its own address, at the same time | **writer and reader are different parts of the design**: the sample path writes / the FFT reads; the FFT writes / the screen reads |
| ↳ **DPB** (true dual-port) | | two ports, each can read **or** write | the FFT core's working memory (a butterfly reads two values and writes two back) |
| ↳ **pROM** | | read-only; the contents are part of the bitstream | fixed tables: window, twiddles, font, text |
| **Shadow SRAM** (SSRAM, RAM16) | made from logic cells, 16 × 4 bits each | tiny RAMs | 3, inside the FFT core |
| Registers (flip-flops) | 15,750 | single values | pipelines, counters, the peak readout's 11 characters |
| **SDRAM** | 64 Mbit = 8 MB, inside the GW2AR package | dynamic RAM: needs refresh and a controller, several clocks per access, but very large | **not used**: everything fits on-chip, which is faster and simpler. It would only be needed for a much bigger picture |
| PSRAM | not on the Tang Nano 20K | (on the Tang Nano 4K and 9K) | – |
| SPI flash | 64 Mbit, on the board | keeps data with the power off; slow | holds the bitstream only |

### 13.2 Every memory, one table

| # | Memory | Module | Type | Shape | Bits | Blocks | Holds | Written | Read |
|---|---|---|---|---|---|---|---|---|---|
| 1 | Ring buffer `buf_mem` | spectrum | **SDPB** | 2,048 × 16 | 32,768 | **2** | raw samples (§4) | 1 sample per 3,328 clocks | 1,024 reads in a row per FFT, every 512 samples |
| 2 | Hann window | rom_hann | **pROM** | 1,024 × 16 | 16,384 | **1** | window values (§5.1) | never (bitstream) | with each ring read |
| 3 | FFT working memory | fft_1024 (Gowin) | **DPB** | (encrypted) | | **4** | values between butterfly stages | by the core | by the core |
| 4 | FFT twiddle factors | fft_1024 (Gowin) | **pROM** | (encrypted) | | **2** | cos/sin values | never | by the core |
| 5 | FFT small buffers | fft_1024 (Gowin) | SSRAM | 3 × (16 × 4) | 192 | 0 | internal | by the core | by the core |
| 6 | Bar heights `mem` | bar_display | **SDPB** | 1,024 × 10 (2 halves) | 10,240 | **1** | 512 heights × 2 (§7) | 512 per FFT, into the back half | 1 per 2 pixels, from the front half |
| 7 | Spectrogram picture `mem_lo` + `mem_hi` | spectrogram_display | **SDPB** | 65,536 × (4 + 1) | 327,680 | **20** (16 + 4) | 256 × 256 levels (§8) | 256 per FFT (one column) | 1 per 4 pixels |
| 8 | Text | rom_text | **pROM** | 10,800 × 9 (of 16,384) | 97,200 | **9** | 3 pages of 80 × 45 cells (§10; 2 pages and 5 blocks until 2026-11-06) | never (bitstream) | 1 per pixel |
| 9 | Font | rom_font | **pROM** | 1,024 × 8 | 8,192 | **1** | 128 characters × 8 rows of dots | never (bitstream) | 1 per pixel |
| 10 | Music buffer `mem` | audio_rx | **SDPB** | 2,048 × 16 | 32,768 | **2** | 85 ms of music from the Mac (weekly report §19) | 32 samples per good packet | 1 per 2 output frames (24,170 Hz) |
| 11 | Waveform `mem` | wave_display | **SDPX9B** | 2,048 × 9 (2 halves) | 18,432 | **1** | 1,024 offsets × 2 (§8A) | 1 per sample during a capture | 1 per pixel |
| | **Total** | | 25 SDPB + 1 SDPX9B + 4 DPB + 13 pROM | | | **43 / 46** | | | |

(The demo sweep's sine table, 1 pROM, was here until the sweep was archived on 2026-11-06.)

Small tables kept in **logic** (too small to be worth a block): the 32-entry log table (§6),
the 32-colour table and the tick positions (§8, §10), the kHz tick lines (§10).

**Why the text table takes 9 blocks, not 6.** 10,800 × 9 bits would fit 6 blocks in their
2,048 × 9 shape; the tool used 9 (with 2 pages: 5 for 4). The likely reason is that it splits
the 9 bits into 8 + 1 over the whole 16 K address range: 8 blocks of 2,048 × 8 and one of
16,384 × 1; this was not investigated. Packing it tighter could free about 3 blocks.

### 13.3 Where the memory goes

```
 spectrogram picture  ████████████████████  20
 text                 █████████          9
 FFT core             ██████             6   (4 working + 2 twiddle)
 ring buffer          ██                 2
 window, font, bars   ███                3
 music, waveform      ███                3
 free                 ███                3
                      └────── 46 block RAMs ──────┘
```

The spectrogram picture is half of all the memory used. A bigger picture (more history or
more colours) would need more blocks than are left, or the SDRAM.

---

## 14. Resources and timing

### 14.1 Per module (synthesis report, build of 2026-11-07)

| Module | Registers | Adders (ALU) | LUTs | DSP | Block RAM |
|---|---|---|---|---|---|
| spectrum (ring, window, **FFT core**, heights) | 318 | 215 | 948 | 5 | 8 (+1 Hann) |
| spectrogram_display | 109 | 36 | 255 | 2 | 20 |
| wave_display (+ grid, ticks) | 60 | 9 | 197 | 1 | 1 |
| peak_readout | 161 | 57 | 98 | 5 | – |
| text_overlay (+ text, font, ticks) | 86 | 25 | 125 | – | 10 |
| bar_display | 29 | 12 | 38 | – | 1 |
| audio_rx (+ UART in and out) | 320 | 88 | 357 | – | 2 |
| i2s_tx | 42 | 20 | 27 | – | – |
| i2s_master_rx + gain24 | 79 | 5 | 121 | – | – |
| TMDS encoders (3) | 45 | 39 | 213 | – | – |
| video_timing | 51 | 11 | 44 | – | – |
| buttons, rotation, top, wiring | 115 | 71 | 72 | – | – |

| Total (after place and route) | |
|---|---|
| Logic | 3,153 / 20,736 (16 %) |
| Registers | 1,415 / 15,750 (9 %) |
| Block RAM | 43 / 46 (93 %) |
| DSP | 7.75 / 24 (32 %) |

The FFT core is the largest single part of the logic; the spectrogram is the largest user of
memory. (The synthesis report counts multipliers, 11 in all; place and route packs them into
7 DSP blocks.)

### 14.2 Timing

| | |
|---|---|
| Needed | 74.25 MHz (13.47 ns per clock) |
| Achieved | **77.2 MHz** (12.95 ns): 4 % spare (2026-11-07; 76.0 MHz in the first music build, 77.5 MHz with the sweep, 83.9 MHz after the spectrogram changes, 81.9 MHz before) |
| Slowest path | in the waveform display: its memory's output → the height comparisons (is this pixel between the previous and this column's heights?) → the colour registers (slack +0.52 ns). Until the waveform screen was added, inside the Gowin FFT core |

What timing is and how it is calculated: `docs/reports/2026-11-01.md`, Appendix A.

---

## 15. How it was verified

Every part was simulated before it was put on the board (Icarus Verilog; the Gowin FFT as
Gowin's gate-level model with `prim_sim.v`). The board result was then checked on the monitor.

| Test | Checks | Result |
|---|---|---|
| `tb_h3_mic` + `check_h3.py` | I2S timing, bit clock, sample rate, all 8 gains, saturation | PASS (2026-10-29) |
| `tb_h4_peak` (fixed 3 kHz, and a sweep), real FFT model | the peak readout through the whole chain | PASS |
| `tb_h4_frame` + `check_h4.py` | a whole bars-page frame: bars, gridlines, every label, the peak text | PASS |
| `tb_h5_spec` + `check_h5.py` | a whole spectrogram-page frame after 300 FFTs (memory wrapped): all 65,280 points (each row's expected level worked out from its own bins; all 32 levels appear), the 4 kHz dashes, colour scale, ticks, every label | PASS (2026-11-06) |
| `tb_h5_chain` + `check_h5_chain.py`, real FFT model | a sweeping tone draws a straight line (3.00 rows per column, one bin per row below 4 kHz), the quiet 1 kHz tone shows at about −58 dB | PASS (2026-11-06) |
| `tb_h6_wave` + `check_h6.py` | a whole waveform-page frame from a known wave: the shown capture starts at a rising zero crossing, every plot pixel (trace, red at the edges, grid), ticks, labels | PASS (2026-11-06) |
| `tb_audio` + `check_audio.py`: `audio_rx` + `i2s_tx` with a model of the laptop (RESET, credits, random delays, its bit time 1 % short) | the I2S wires decoded: every sample played exactly as sent with no gap; a corrupted packet dropped and counted; nothing dropped for lack of room | PASS (2026-11-06) |
| USB-serial speed tests on the board (`top_uart_echo.v`, `top_uart_count.v`, `host/uart_speed_test.py`) | how fast and how reliably the BL616 carries data each way | laptop → FPGA lossless up to 170 KB/s |
| `archive/tb_sweep` + `check_sweep.py` (the archived demo sweep) | I2S wires decoded, every sample against a model | PASS (until archived) |
| Old vs new comparisons (scratch tests, weekly report §8, §11, §12) | each change gave bit-identical results where it should | all identical |

*Figures:* `docs/figures/h4_layout.png`, `h4_layout_spectrogram.png` (text layouts),
`h5_spectrogram_sim.png` (simulated spectrogram page), `h5_chain_sweep_overlap_sim.png`
(a sweep through the real FFT model), `h6_wave_sim.png` (simulated waveform page),
`h6_colours_board.png`, `h6_zones_board.png` (spectrogram on the board).

---

## Appendix A: glossary

| Term | Meaning |
|---|---|
| **Bin** | one output of the FFT: the strength of one narrow band of frequencies, 21.79 Hz wide here |
| **BL616** | the chip on the Tang Nano 20K that programs the FPGA over USB; it is also a USB serial port to FPGA pins 69/70 |
| **Blanking** | the invisible part of each line and frame, used for sync pulses; a safe moment to change what is shown |
| **Block RAM (BSRAM)** | a block of on-chip memory, 18 Kbit, fast and fixed in place; 46 on this chip |
| **Checksum (sum16)** | the packet's bytes added up and sent along; the receiver adds them again and drops the packet if the result differs |
| **Clamp / saturate** | hold a value at the limit instead of letting it wrap around to the opposite sign |
| **Credit** | permission to send: here one "C" from the FPGA lets the laptop send 256 more samples (flow control) |
| **Double buffer** | two copies of the data: one is shown while the other is filled, then they swap |
| **DSP** | a hardware multiplier block |
| **FFT** | Fast Fourier Transform: turns 1,024 samples in time into 1,024 frequency bins |
| **Hann window** | a smooth fade-in/fade-out applied to each block before the FFT, to stop leakage |
| **I2S** | the three-wire serial format for audio (bit clock, word select, data): the microphone sends it to the FPGA, the FPGA sends it to the amplifier |
| **Overlap** | starting a new FFT before the previous block's samples are all new; here every 512 samples |
| **Pipeline** | splitting a calculation into steps, one per clock, so a new input can start every clock |
| **pROM** | a block RAM used as read-only memory, filled from the bitstream |
| **Ring buffer** | a memory written in a circle, the newest data overwriting the oldest |
| **SDPB / DPB** | semi-dual-port (one write port + one read port) / true dual-port (two read-or-write ports) block RAM |
| **Spectrogram** | many spectra over time, drawn side by side, with colour for level |
| **Synchroniser** | two flip-flops in a row that make a signal from outside safe to use inside the clocked design |
| **TMDS** | the coding HDMI uses: 8 bits of colour → 10 bits on the wire |
| **Twiddle factor** | a cos/sin value the FFT multiplies by inside each butterfly |
