karnza007/esp32_iot_gateway/docs/reports/2026-11-08.md

# Weekly report — week ending 2026-11-08

> **Status: spectrogram done, with a speaker demo.** The advisor asked for a spectrogram of the
> microphone signal. All 4 planned steps are done and checked on the board (§9–11), followed by
> finer colours (1 dB, §13), a larger 0–4 kHz range (§14), and a demo sweep played through the
> board's speaker amplifier so the spectrogram can be shown with a known sound (§15–17), and a
> third screen showing the raw waveform (§18). The sweep then made way for music played from the
> Mac through the board's own USB cable, and the screens rotate by themselves (§19). The design is
> in the board's flash and starts on the spectrogram. Open items: §7.

**Summary**

| Topic | Result |
|---|---|
| Plan for the spectrogram | 4 steps: (1) remove the test tone, (2) S1 becomes the mode switch, (3) spectrogram 256 × 256, no overlap, (4) 50 % overlap (§1). **All done** |
| Step 1: test tone removed | 2,207 logic (11 %), 771 registers, 11 / 46 block RAMs, 6.5 / 24 DSP (§4) |
| Steps 2–4 | S1 switches bars ↔ spectrogram (§9); spectrogram 256 × 256, one column per FFT, scrolling by a moving start column (§10); 50 % overlap: an FFT every 512 samples, 256 columns = 5.9 s (§11) |
| Spectrogram colours | 1 dB per step, −80 … −51 dB in matplotlib's "viridis", white from −50 dB, black below −80 dB; 5-bit picture memory (§13) |
| Spectrogram rows | 0 … 4 kHz at one FFT bin (21.8 Hz) per row, 72 % of the height; 4 … 11 kHz squeezed, the loudest of 4–5 bins kept; dashed line at 4 kHz (§14) |
| Demo sweep | `sweep_player.v` (separate from the measuring chain) → the board's MAX98357A → speaker → mic. An external button on pin 27 toggles it: 200 Hz ↔ 4 kHz, 4 s each way, plus tones at 1.5 × and 2 × at −12 dB (§15–17) |
| Waveform screen | S1 now cycles spectrogram → bars → waveform: the last 45.9 ms of samples, edges at the peak of a −40 dB tone (±1,311), grid at −50 / −60 dB, oscilloscope-style trigger (§18) |
| Music from the Mac | `host/play_song.py` → the Tang's own USB cable (BL616 serial port, measured lossless one way at 170 KB/s) → `audio_rx.v` → speaker; 24,170 Hz mono, credit flow control; "Happy Birthday" played with 0 errors (§19) |
| Auto-rotate | the pin-27 button now freezes / resumes a 6 s rotation of the 3 screens (§19; 10 s at first); the sweep is archived (tag `demo-sweep`) |
| Timing at 74.25 MHz | met throughout: two fixes (dB conversion over two clocks, §8; text table in block RAM, §12); now **76.0 MHz** (2 % spare) |
| Resources now | **3,141 logic (16 %), 1,415 registers, 43 / 46 block RAMs, 7.75 / 24 DSP** |
| Verification | every change simulated first: whole-frame pixel checks, the real FFT model, and the sweep's I2S wires decoded and compared sample by sample (§10–17); then checked on the monitor |
| On the board | in flash: starts on the spectrogram, rotating every 6 s; S1 = next screen, S2 = gain, pin-27 button = rotate / freeze; music from `play_song.py` |

**Topic:** HDMI demo (advisor request): microphone → Tang Nano 20K → Gowin FFT → monitor.
**Details:** `docs/12-hdmi-demo.md` §6.5  ·  **Full design explanation (every module and memory):** `docs/reports/2026-11-08-design.md`

---

## 1. Idea

The advisor wants to see a **spectrogram**: many FFTs stacked over time, with colour showing
the level, so the screen shows how the sound changes rather than only how it is now.

Before building it, three questions were answered (discussion 2026-11-04):

| Question | Answer |
|---|---|
| What RAM does the design use? | Only on-chip: 12 of 46 block RAMs (18 Kbit each) and 3 small logic-built RAMs. No external memory. |
| What RAM does the 20K have? | Block SRAM (46 × 18 Kbit ≈ 100 KB), logic-built SRAM (≈ 40 Kbit), and 64 Mbit (8 MB) of SDRAM inside the GW2AR package, unused. **No PSRAM** (that is on the Tang Nano 4K and 9K). |
| Would SDRAM make the design faster or smaller? | No. On-chip RAM already gives one access per clock; SDRAM needs several clocks per access, refresh pauses and a controller (more logic). It only helps with **capacity**: a picture bigger than the free block RAM. |

**Does a spectrogram fit on-chip?** The picture must be stored, because the screen is redrawn
60 times a second:

| Picture (time × frequency × colours) | Bits | Block RAMs | Fits? |
|---|---|---|---|
| **256 × 256 × 16** (first version) | 262,144 | 16 | ✅ (34–35 free) |
| 512 × 256 × 16 | 524,288 | 32 | just |
| 1,024 × 512 × 256 | 4.2 M | — | no: needs the SDRAM |

The plan, agreed with the advisor's overlap suggestion in mind:

1. Remove the test tone from the HDMI build (this report).
2. S1 switches the display between bars and spectrogram.
3. Spectrogram 256 × 256 × 16 colours, **no overlap**: one strip per FFT, 21.8 strips/s, 45.9 ms each.
4. **50 % overlap**: each FFT uses 512 old + 512 new samples, 43.6 strips/s, 22.9 ms each. With
   no overlap, the Hann window fades each block's ends to nearly zero, so a short sound at a block
   edge is almost lost; with 50 % overlap every moment falls near the middle of some block.

## 2. Hypothesis

> **H1.** *If the test tone and the source selector are removed, logic falls by about 190,
> block RAMs by 1 and DSP by 1, because the synthesis report lists `u_tone` at 155 registers,
> 93 adders, 98 LUTs and 1 multiplier, plus 1 block RAM for its sine table.*

It would be wrong if the drop were much smaller, or if anything else on the screen changed.

## 3. Test structure

```
  mic ─▶ mic_source ─▶ spectrum (FFT) ─▶ bars + text ─▶ HDMI ─▶ capture card ─▶ frame on the Mac
          ▲
          └── removed: tone_gen and the mic ↔ tone selector (S1)
```

| Setting | Before (2026-10-29) | After |
|---|---|---|
| Sources | mic, test tone (S1) | mic only |
| S1 | mic ↔ tone | unused until step 2 |
| LED 0 | on = mic selected | off |
| Header text | "MIC DIRECT" or "TEST TONE", 22311 Hz | always "MIC DIRECT 22311 Hz" |
| Everything else | — | unchanged |

`tone_gen.v` stays in the repo: H2, the mic-UART build and the simulations (`tb_h4_peak` uses it
as a known input) still need it. It will also be the natural test for the spectrogram in
simulation: a sweep should draw a clean diagonal line.

## 4. Results

| Resource | 2026-10-29 | **2026-11-04** | Change |
|---|---|---|---|
| Logic | 2,529 (13 %) | **2,207 (11 %)** | −322 |
| Registers | 933 | **771** | −162 |
| Block RAM | 12 / 46 | **11 / 46** | −1 (sine table) |
| DSP | 7 / 24 | **6.5 / 24** | −0.5 |
| Timing (needs 74.25 MHz) | 85.0 MHz | **74.27 MHz** | see §5 |

**Predicted vs observed:**

| Quantity | Predicted | Observed | Note |
|---|---|---|---|
| Logic saved | ≈ 190 | 322 | the selector, the second header and tick-line set, and the source register also went |
| Block RAM saved | 1 | 1 | |
| DSP saved | 1 multiplier | 0.5 DSP block | Gowin counts DSP in half blocks; the tone's one multiplier used half a block |

**Checks:**

| Check | Result |
|---|---|
| `tb_h4_frame` + `check_h4.py` (whole simulated frame) | PASS: readout, gain, title, gridlines, dB labels; header reads "MIC DIRECT 22311 Hz" |
| Board, frame from the capture card | header "MIC DIRECT 22311 Hz", GAIN +0 dB, PEAK and bars as before |
| `tb_h4_peak`, `tb_h3_mic` | not re-run: their modules (`tone_gen`, `spectrum`, `peak_readout`, `mic_source`) are unchanged |

## 5. Interpretation

The saving is larger than predicted because removing a source also removes everything that
chose between sources. The design now has 35 free block RAMs, enough for the 16 the first
spectrogram needs.

**Timing.** The build passes, but with 0.02 % spare instead of 14 %. The slowest path is the
dB conversion in `spectrum.v` (find the leading one, normalise, look up the log, all in one
clock), which did not change: the placer simply put it differently this time. A pass this thin
is luck, so the next build may fail. The fix is the same as on 2026-10-29: split that step over
two clocks. It should be done together with the spectrogram, which adds logic and will move the
placement again.

## 6. Problems and what they taught us

- **Timing margin can vanish without a logic change.** Removing logic changed the placement, and
  an untouched path went from comfortable to just passing. The margin belongs to a build, not to
  the design. `build.sh`'s check (achieved vs needed per clock, added 2026-10-29) reported it
  correctly.

## 7. Next week

- [x] Step 2: S1 switches the display between bars and spectrogram (§9)
- [x] Split the dB conversion in `spectrum.v` over two clocks (timing margin, §8)
- [x] Step 3: spectrogram 256 × 256 × 16 colours, no overlap, layout A (§10)
- [x] Step 4: 50 % overlap (§11)
- [x] Timing margin: text ROM moved into block RAM, 75.5 → 81.9 MHz (§12)
- [x] Spectrogram colours in 1 dB steps, viridis, white above −50 dB (§13)
- [x] 0 … 4 kHz enlarged: one FFT bin per row (§14)
- [x] Start on the spectrogram; demo sweep through the board's speaker, external button on pin 27 (§15)
- [x] Demo sweep toggles on / off and runs up and down (§16), with tones at 1.5 × and 2 × (§17)
- [x] Design report for the whole demo, every module and memory (`2026-11-08-design.md`)
- [x] Third screen: the raw audio waveform; S1 cycles spectrogram → bars → waveform (§18)
- [x] Music from the Mac through the board's own USB cable; screens auto-rotate, the pin-27 button freezes them (§19)
- [ ] Optional: pack the text table tighter (9 block RAMs → about 6) if memory is needed
- [ ] Timing margin is down to 2 % (76.0 MHz): find the slowest path and add a register stage
- [ ] Optional: a register stage before the spectrogram's row calculation, for more timing margin

## 8. Timing fix: the dB conversion over two clocks (2026-11-04)

**The problem (§5).** For each bin, `spectrum.v` turns the power P (32 bits) into
L = 32·log2(P) in one clock: ① find the top 1 bit (e), ② shift P so that bit lands at bit 31,
③ look up the next 5 bits in a 32-entry log table, ④ add 32·e. In the build after the tone
removal that was **19 cells in a row: 8.23 ns of logic + 5.01 ns of wires = 13.24 ns**, with
**+0.003 ns** slack. The logic was unchanged; removing the tone changed the netlist, the placer
laid the design out again, and these cells ended up further apart (in the 85.0 MHz build of
2026-10-29 the same path was at most about 11.5 ns, so the change was about 1.7 ns of wire).

**The fix.** A register between ② and ③: stage 4a keeps e and the 5 bits below the top bit
(10 bits), stage 4b does the table and the add. The valid, address and zero flags, and
`bar_done`, get one more stage, so the bars arrive one clock (13.5 ns) later.

| Check | Result |
|---|---|
| Bar heights, old vs new `spectrum.v` (sweeping tone + 1 kHz, 4 FFT blocks, Gowin FFT model) | **all 2,048 writes identical**, every one exactly 1 clock later |
| `tb_h4_peak`, fixed 3 kHz / sweep | PASS 6/6 / PASS 6/6 |
| Build | **2,278 logic (11 %), 775 registers, 11 / 46 block RAMs, 6.5 / 24 DSP; 89.0 MHz** (20 % spare) |
| Slowest path now | inside the Gowin FFT core (butterfly multiplier → its RAM), slack +2.23 ns |

Logic went up by 71 cells for about 15 new registers; the rest is the tool packing logic
differently, as usual between builds. The best timing of the demo so far.

## 9. Step 2: S1 switches bars ↔ spectrogram (2026-11-04)

S1 now toggles a `mode` register (start-up: bars; LED 0 on = spectrogram). The spectrogram
screen exists before the spectrogram does, so the switch can be tested on its own:

| | Mode 0: bars | Mode 1: spectrogram (step 2) |
|---|---|---|
| Title | LIVE FFT SPECTRUM - … | **LIVE SPECTROGRAM** - … |
| Source, rate, gain, PEAK | shown | shown, same places |
| Plot area | bars, gridlines, tick lines, dB and kHz labels | black (step 3 draws here) |

**Text pages.** Until now only rows 1 and 42 had variants (one per sound source, stored below
the visible rows). The spectrogram needs different labels all around the plot, so the text ROM
now holds **a whole page per mode**: address = {page, row, column}. `gen_h4_text.py` writes both
pages and a preview of each (`docs/figures/h4_layout.png`, `h4_layout_spectrogram.png`). In
`text_overlay.v`, page 1 draws text only: the bar picture and tick lines are not shown.

| Check | Result |
|---|---|
| Frame simulation, page 0 | PASS, and **pixel-identical** to the frame before step 2 |
| Frame simulation, page 1 | PASS: title "LIVE SPECTROGRAM", gain and PEAK shown; plot area, dB-label column and kHz row all black |
| Build | 2,289 logic (12 %), 779 registers, 11 / 46 block RAMs, 6.5 / 24 DSP; **81.6 MHz** |
| Board | uploaded; checked on the monitor by hand (no capture card) |

**Layout for step 3 (decided):** A, scrolling left: time left → right (newest at the right
edge), frequency bottom → top (0–11.2 kHz), each spectrogram point 4 × 2 px, 1,024 × 512 px,
11.7 s of history; 16 colours, one per 5 dB from −80 to 0 dB, black → blue → purple → red →
orange → yellow → white.

## 10. Step 3: the spectrogram (2026-11-04)

**Idea.** Every FFT already produces 512 bar heights for the bars screen. The spectrogram keeps
them: each FFT becomes one column of a picture, colour = level, and the screen shows the latest
256 columns.

```
spectrum.v ── 512 heights per FFT ──┬─▶ bar_display         (bars, unchanged)
                                    ├─▶ peak_readout        (unchanged)
                                    └─▶ spectrogram_display (new)
                                          ① bin pair 2r, 2r+1 → row r: the louder of the two
                                          ② height → colour number: height / 37.5 (5 dB, 0..15)
                                          ③ one column of the 256 × 256 × 4-bit memory
                                          ④ screen: start column + (x − 128) / 4, row (659 − y) / 2
```

| Design choice | Value | Why |
|---|---|---|
| Picture | 256 columns × 256 rows × 4 bits = 262,144 bits | fits in **16 block RAMs** on-chip (no SDRAM) |
| On screen | x 128–1151, y 148–659; each point 4 × 2 px | 1,024 × 512 px; same bottom edge as the bars screen |
| History | 256 FFTs × 45.9 ms = **11.7 s**, newest at the right | layout A, chosen 2026-11-04 |
| Joining bins | the louder of each pair (43.6 Hz per row) | a narrow tone keeps its full brightness |
| Colours | 16, 5 dB each; 0 = black (−80 to −75 dB), then matplotlib's "inferno" | black hides the FFT rounding grass at about −80 dB |
| Scrolling | only the start column moves, in vertical blanking | the picture never tears; screen column 0 (being overwritten) is drawn black |
| Labels | kHz every 1 kHz (left), −10 s … now every 2 s (bottom), colour scale 0/−40/−80 dB (right) | text page 1 + `rom_spec.v`, both from `gen_h4_text.py`; 4 lowercase glyphs (n, o, s, w) added to the font |

**Hypothesis.** *If the spectrogram is added as above, block RAMs go from 11 to 27 and timing
still passes, because the picture needs exactly 16 blocks and its logic is a few adders and two
16-entry tables. A sweeping tone through the real FFT must draw a straight line rising 3 rows
per column (it moves 6 bins = 3 rows per FFT).*

**Results.**

| Check | Result |
|---|---|
| `tb_h5_spec` + `check_h5.py`: 300 fake FFTs (a diagonal line, a fixed −23 dB tone), so the memory has wrapped | **PASS**: all 65,280 points the right colour in the right place, each filling its 4 × 2 px; column 0 black; colour scale; all tick marks; every label read back from the pixels |
| `tb_h5_chain` + `check_h5_chain.py`: sweeping tone → Gowin FFT gate-level model → spectrogram, 40 FFTs | **PASS**: brightest row in the expected range in 40 / 40 columns, straight-line fit **3.00 rows per column**; the quiet 1 kHz tone shows at colour 4 (−60 to −55 dB; it is −58.7 dB); away from both tones 100 % dark; no overrun |
| `tb_h4_frame` (bars page) | PASS, pixel-identical to before |
| Build | **2,614 logic (13 %), 876 registers, 27 / 46 block RAMs, 7 / 24 DSP; 82.7 MHz** (11 % spare) |
| Board | uploaded; checked on the monitor by hand (no capture card) |

| Quantity | Predicted | Observed |
|---|---|---|
| Block RAMs | 11 + 16 = 27 | 27 |
| Line slope | 3 rows per column | 3.00 |
| 1 kHz tone level | −58.7 dB → colour 4 | colour 4 |

*The simulated spectrogram page (fake data) and the swept tone through the real FFT model:
`docs/figures/h5_spectrogram_sim.png`, `docs/figures/h5_chain_sweep_sim.png`.*

**Problem found on the way.** The first label preview showed "-10" and "now" garbled: the font
had no lowercase s, n, o, w. Caught from the generated preview before any build; the glyphs were
added (the bars page is unchanged, pixel for pixel).

## 11. Step 4: 50 % overlap (2026-11-04)

**Idea.** Each FFT multiplies its 1,024 samples by the Hann window, which fades the block's
start and end to nearly zero. Without overlap, a short sound (a clap, a click) that lands near
a block edge is almost lost. With 50 % overlap a new FFT starts every 512 samples on the latest
1,024, so every moment is near the middle of some block, and there are twice as many columns.

**The design change (`spectrum.v`).** Until now the window was applied as samples were stored,
into two halves of 1,024. With overlap each sample is used twice, at two different window
positions, so that no longer works:

| | Before | Now |
|---|---|---|
| Buffer | 2 halves of 1,024 **windowed** samples | ring of 2,048 **raw** samples (same memory) |
| Window | multiplied when storing | multiplied as the FFT reads (same multiplier, moved) |
| FFT start | every 1,024 samples | every 512 (`OVERLAP = 1`), or every 1,024 (`OVERLAP = 0`) |
| Columns | 21.8 / s, 45.9 ms each | **43.6 / s, 22.9 ms each** |
| Screen history | 256 columns = 11.7 s | 256 columns = **5.9 s** (option A, chosen 2026-11-04); time labels −5 s … now, every 1 s |

`OVERLAP = 0` keeps the old behaviour for the H2 design and for comparisons; the HDMI demo uses 1.

**Hypothesis.** *If the window moves to the read side, `OVERLAP = 0` gives bar heights identical
to the old design, and `OVERLAP = 1` gives an FFT every 512 samples whose every second block is
identical to the old one, because those blocks hold exactly the same 1,024 samples and the same
arithmetic (sample × window / 32768) is done, only at a different time.*

**Results.**

| Check | Result |
|---|---|
| `OVERLAP = 0` vs the committed design (sweeping tone + 1 kHz, Gowin FFT model, 4 FFTs) | all bar heights **identical, on the same clock** |
| `OVERLAP = 1` vs the committed design (7 FFTs) | FFTs 0, 2, 4, 6 **identical** to the old 0, 1, 2, 3; FFTs 1, 3, 5 new (each differs from both neighbours); FFTs **8,192 clocks apart** instead of 16,384 |
| `tb_h4_peak`, fixed 3 kHz / sweep (now with overlap; the sweep's block range starts two `block_ready`s back) | PASS 6/6 / PASS 6/6, no overrun |
| `tb_h5_chain` (sweep through the real chain) | PASS: line at **1.50 rows per column** (half of before: twice the columns); 1 kHz tone colour 4; 100 % dark elsewhere |
| `tb_h5_spec` (spectrogram page) | PASS; time axis reads "-5s -4s -3s -2s -1s now" |
| `tb_h4_frame` (bars page) | PASS, pixel-identical |
| Build | **2,645 logic (13 %), 922 registers, 27 / 46 block RAMs, 7 / 24 DSP; 75.5 MHz** |
| Board | uploaded; checked on the monitor by hand (no capture card) |

**Timing note.** 75.5 MHz passes with only 1.6 % spare. The slowest path is not the new read
path but the old text-ROM lookup (`rom_text`, built from logic, one clock), which grew when it
got a second page in step 2: x → 11 cells → the ROM output register. The same path was the
slowest on 2026-10-22. Fix when needed: give the lookup a second clock, or move the table into
a block RAM (19 are free).

*The swept tone through the real chain with overlap: `docs/figures/h5_chain_sweep_overlap_sim.png`.*

## 12. Timing fix: the text table in block RAM (2026-11-04)

**The problem (§11).** The screen-text table (`rom_text`: which character, in which colour, in
each 16 × 16 cell) was built from logic: 278 entries, a 14-bit address, **400 logic cells, 11
deep**, 13.25 ns of a 13.47 ns clock. The first plan, "give it a second clock", would not have
helped: the table already had a clock to itself, and a lookup has no natural middle to put a
register in (unlike the dB maths in §8, which was a chain of separate steps). Splitting it
would have meant rebuilding it as a two-level table.

**The fix.** Store it in block RAM, like the font already was. A block RAM answers any address
in one clock with a short, fixed delay, so the delay through the screen pipeline is unchanged.
To keep it small the table was made compact:

| | Before | After |
|---|---|---|
| Address | {page, row, column}: 2 × 64 × 128 slots | page × 3,600 + row × 80 + column: 7,200 slots (row × 80 computed in the address clock) |
| Word | 10 bits: colour, live flag, ASCII | 9 bits: colour, ASCII; codes 0–15 = live character (unused control codes) |
| Built from | 400 logic cells | block RAM (`syn_romstyle = "block_rom"`) |

| Check | Result |
|---|---|
| Bars page frame | **pixel-identical** to before the change |
| Spectrogram page frame | **pixel-identical** to before the change |
| Build | **2,297 logic (12 %, −348), 921 registers, 32 / 46 block RAMs (+5), 7 / 24 DSP; 81.9 MHz** (10 % spare) |
| Slowest paths | all inside the Gowin FFT core (slack +1.25 ns); the text path is gone |
| Board | uploaded; checked on the monitor by hand |

The tool used 5 block RAMs, one more than the 4 estimated (7,200 × 9 bits fits 4 blocks of
2,048 × 9; how the tool split it was not investigated).

## 13. Spectrogram colours: 1 dB steps, viridis (2026-11-06)

**Why.** With 16 colours of 5 dB over −80 … 0 dB, the room's real sounds (−80 … −50 dB) used
only the 6 darkest colours, so speech and quiet tones looked dim and blocky. Sounds louder
than −50 dB are rare in the demo.

**What changed.** Each point is now a level 0 … 31, one per dB, and the colours are
matplotlib's "viridis" map (dark purple → blue → teal → green → yellow), chosen over a pure
rainbow because its brightness rises evenly, so equal dB steps look equal.

| Level | dB | Colour |
|---|---|---|
| 0 | below −80 | black (also hides the FFT's rounding noise) |
| 1 … 30 | −80 … −51, one per dB | viridis, `440154` … `FDE725` |
| 31 | −50 and louder | white |

| | Before | After |
|---|---|---|
| Level | height / 37.5 → 0 … 15 | height 0 → 0; height ≥ 225 → 31; else height × 547 >> 12, + 1 (= height / 7.5 + 1, exact) |
| Memory | 65,536 × 4 bits, 16 blocks | 65,536 × 5 bits, kept as 4 bits (16 blocks) + 1 bit (4 blocks), so the tool cannot round the width up to 8 bits (32 blocks, which would not fit) |
| Colour scale | 16 × 32 px, labels 0 / −40 / −80 | white 32 px, then 30 × 16 px; labels >−50 / −50 / −60 / −70 / −80 |

A preview from a made-up sound, processed like the FPGA, was made first
(`figures/h6_colours_preview.png`, before vs. after).

| Check | Result |
|---|---|
| `tb_h5_spec` + `check_h5.py` (new pattern: every height 0 … 240 as the louder of a pair, sometimes the odd bin, so all 32 levels and every edge between them appear) | **PASS**: 65,280 / 65,280 points right, 32 / 32 levels used; scale, labels, ticks right (`figures/h6_colours_sim.png`) |
| `tb_h5_chain` + `check_h5_chain.py` (same −65 dB limits as before, now in levels: ≥ 16 / ≤ 15) | **PASS**: line 1.50 rows per column; 1 kHz tone at levels 22 … 24 (about −58 dB); 100 % dark away from the tones. The line's start row reads 4.2 (was about 6.5): the loud sweep is now white over several rows and the check takes the lowest |
| Build | **2,365 logic (12 %), 932 registers, 36 / 46 block RAMs (+4), 7 / 24 DSP; 83.9 MHz** |
| Board | checked on the monitor; capture card frame `figures/h6_colours_board.png` (quiet room, gain +0): 0 … 0.5 kHz about −67 dB, 0.5 … 2 kHz about −74 dB, above 2 kHz half black (mic noise at −80 dB); nothing white. The capture card shifts colours slightly (median 20 / 255), so levels read from it are ±1 … 2 dB |

Next: §14.

## 14. Spectrogram rows: 0 … 4 kHz enlarged (2026-11-06)

**Why.** Speech and most sounds in the demo are below 4 kHz, which had only the bottom 36 % of
the plot at 43.6 Hz per row (two bins joined).

**What changed.** Two zones, still 256 rows, so the memory and the screen layout are unchanged:

| Zone | Rows | One row | Height |
|---|---|---|---|
| 0 … 4.0 kHz (bins 0 … 183) | 0 … 183, row = bin | **one bin, 21.8 Hz** (2× finer) | 72 % (was 36 %) |
| 4.0 … 11.1 kHz (bins 184 … 511) | 184 … 255, row = 184 + (bin − 184) × 225 / 1024 | 4 … 5 bins, about 99 Hz; the **loudest** kept (option A) | 28 % |

The write side went from 3 to 4 clocks: (A) the bin's row, and whether it is the row's last bin,
from one multiply (the next bin starts a new row when the low 10 bits of (bin − 184) × 225 are
799 or more); (B) the loudest height of the row so far; (C) height → level; (D) write. A dashed
grey line (y 291, 4 px on / 4 off) marks 4 kHz; kHz labels 0 1 2 3 4 6 8 10, ticks every 1 kHz.
Options considered and not taken: a log (mel) scale (blocky at low frequencies, hard to label),
a lower sample rate (loses everything above 5.5 kHz); for the upper rows, the average or every
4th bin (both can dim or lose a thin tone).

| Check | Result |
|---|---|
| `tb_h5_spec` + `check_h5.py` | **PASS**: 65,280 / 65,280 points right, each row's level worked out from its own bins; 32 / 32 levels; dashes on y 291; labels and ticks right (`figures/h6_zones_sim.png`) |
| `tb_h5_chain` + `check_h5_chain.py` | **PASS**: line 3.00 rows per column (2× before: one bin per row); 1 kHz tone on row 46 at about −58 dB; 100 % dark elsewhere. The sweep stays below 3 kHz, so the upper zone is covered by `tb_h5_spec` and the board |
| Build | **2,396 logic (12 %), 954 registers, 36 / 46 block RAMs, 7.25 / 24 DSP; 83.9 MHz** |
| Board | checked on the monitor; capture `figures/h6_zones_board.png` (quiet room, gain +0): room sounds as short marks up to 2.5 kHz, fine lines near 250 Hz, one sound reaching 8 kHz. Black points: 45 % at 2 … 4 kHz, 34 % at 4 … 11 kHz (the loudest-of-5 lifts the noise a little, as expected) |
| Flash | written to the SPI flash (survives power-off) |

The design report (`2026-11-08-design.md` §8, §13, §14) describes the design after both changes.

## 15. Demo sweep through the speaker; start on the spectrogram (2026-11-06)

**Why.** To demonstrate the spectrogram with a known sound: a tone that rises steadily must draw
a straight line.

**What was added.** `sweep_player.v`, a module of its own: nothing connects it to the mic → FFT →
screen chain, so the sweep reaches the spectrogram only through the air (speaker → mic).

| Part | How |
|---|---|
| Amplifier | the board's MAX98357A (I2S in, class-D out); pins from Sipeed's `TangNano-20K-example/audio`: BCLK 56, WS 55 (low = left), DIN 54, PA_EN 51 (on when high) |
| Sound | 200 Hz → 4 kHz, linear, 4.0 s (193,359 samples), −20 dB of full scale (3277), faded in and out over 512 samples; 20 ms quiet before and after; PA_EN high only meanwhile |
| Tone | phase accumulator: phase += step, step += 1,746 per sample from the 200 Hz step; top 10 phase bits index `rom_sine` (1 block RAM) |
| I2S | 74.25 MHz / 1536 = 48,339.8 Hz; BCLK 1.547 MHz, 32 bit clocks per sample (16 left, 16 right, the same sample), Philips format; WS and DIN change when BCLK falls |
| Button | external, pin 27 to 3.3 V with the internal pull-down (reads 1 when pressed, like S1/S2), through the same debounce; one press = one sweep; LED 1 on while playing |
| Build option | pins 54–56 are the SSPI configuration port unless freed: `set_option -use_sspi_as_gpio 1` in `build.tcl` (as Sipeed's example; configuration here is over JTAG) |

Also: the display now **starts on the spectrogram** (S1 still switches).

| Check | Result |
|---|---|
| `tb_sweep` + `check_sweep.py` (whole sweep; the I2S words decoded from the wires alone) | **PASS**: all 193,359 samples equal the model; left = right; peak 3277; 200.0 → 3,999.7 Hz in 4.00 s; quiet 968 / 966 samples (967 ± 1) (`figures/h7_sweep_sim.png`) |
| Same, real speed (`HALF = 24`, `+short`) | BCLK 1.547 MHz, 48,339.8 Hz; WS / DIN change only with BCLK falling (also over all 6.25 M bit clocks of the full run) |
| Three presses with the real debounce (scratch test) | three identical sweeps |
| Build | 2,728 logic (14 %), 1,127 registers, **37 / 46 block RAMs** (+1: the sine table), 8.25 / 24 DSP; **86.5 MHz** |
| Board | checked on the monitor and by ear; written to flash |

**Problem on the way.** The first version had a pull-up on pin 27 and expected the button to go
to GND; the button was wired to 3.3 V, so presses were not seen (one sweep played, probably from
noise on the pin). The simulation showed the logic replaying correctly every time, which
pointed at the wiring; pin 27 was changed to a pull-down with the button reading 1 when pressed.
The intermediate build's timing landed at 77.4 MHz (the slowest path in the spectrogram's row
logic, not in the new module); this build's placement gives 86.5 MHz.

## 16. Demo sweep: toggle on / off, up and down (2026-11-06)

**Why.** For a demonstration the sound should run until stopped, and a sweep that also comes
back down shows the spectrogram following in both directions.

**What changed** (`sweep_player.v`; the button input is now `toggle`):

| Press | Does |
|---|---|
| off → on | 20 ms quiet (amplifier waking), fade in over 512 samples, sweep up from 200 Hz |
| while on | up 4 s (200 → 3,999.7 Hz), down 4 s, repeating; at each turn the step holds for one sample and the direction flips, the phase carries on: no click |
| on → off | fade out over up to 512 samples from wherever it is, 20 ms quiet, amplifier off |
| during the 20 ms start | cancels the start |
| during the fade out | turns back on (the fade reverses) |

On the spectrogram (5.9 s wide) the sound draws a zig-zag between 200 Hz and the dashed 4 kHz
line, 174 columns per leg.

| Check | Result |
|---|---|
| `tb_sweep` short schedule (legs of 3,000 samples; 8 presses covering every case above) + `check_sweep.py`, which models the whole player including the presses | **PASS**: all 15,362 samples equal the model; left = right; PA_EN follows the model; 3 turns |
| `tb_sweep +long` (real length: on → a whole up-and-down → off) | **PASS**: all 410,781 samples equal the model; 200.0 → 3,999.7 → 200.0 Hz; peak 3277; 0 timing faults in 13.1 M bit clocks (`figures/h7_sweep_updown_sim.png`) |
| Real speed (`HALF = 24`, `+short`) | BCLK 1.547 MHz, 48,339.8 Hz; WS / DIN change only with BCLK falling |
| Build | 2,691 logic (13 %), 1,145 registers, 37 / 46 block RAMs, 8.25 / 24 DSP; **79.4 MHz** |
| Board | checked on the monitor; written to flash |

## 17. Demo sweep: three tones (2026-11-06)

**What changed.** Two more tones follow the main one (`sweep_player.v`), turning and fading with
it, so the spectrogram shows three zig-zags at once:

| Tone | Frequency | Amplitude | How |
|---|---|---|---|
| main | 200 Hz ↔ 4 kHz | 3277 (−20 dBFS) | phase += step |
| 2nd | 1.5 × main: 300 Hz ↔ 6 kHz | AMP / 4 = **−12.04 dB** (`AMP2_SHIFT = 2`) | phase += step + step / 2 |
| 3rd | 2 × main: 400 Hz ↔ 8 kHz | AMP / 4 = **−12.04 dB** (`AMP3_SHIFT = 2`) | phase += 2 × step |

The one sine table is read three times per sample (main, 2nd, 3rd; the sample is ready at clock
15 of 1,536); sample = (sine₁ + sine₂ / 4 + sine₃ / 4) × AMP × fade / 2²⁴. Peak of the sum 4915
(−16.5 dBFS). (A first version that afternoon had the 2nd tone at −6 dB and no 3rd.) The 2nd
and 3rd lines cross 4 kHz and bend into the squeezed rows. The 3rd tone lies where the
speaker's own 2nd-harmonic distortion would show, so the two cannot be told apart there.

| Check | Result |
|---|---|
| `tb_sweep` short schedule (8 presses) | **PASS**: all 15,362 samples equal the model |
| `tb_sweep +long` (on → 8 s up and down → off) | **PASS**: all 410,781 samples equal the model; main 200.0 ↔ 3,999.7 Hz, 2nd 300.0 ↔ 5,999.6 Hz, 3rd 400.0 ↔ 7,999.4 Hz (`figures/h7_sweep_3tones_sim.png`) |
| Measured from the decoded sound, apart from the model (8,192-sample Blackman windows, 6 moments) | frequency ratios **1.500 / 2.000**; levels by each tone's total energy **−12.04 / −12.04 dB** |
| Build | 2,872 logic (14 %), 1,243 registers, 37 / 46 block RAMs, 8.25 / 24 DSP; **79.2 MHz** |
| Board | checked on the monitor; written to flash |

**A lesson from the measurement.** Measured by each tone's *peak* instead, the 2nd and 3rd
tones read −13.8 and −15.0 dB. They sweep 1.5 × and 2 × as fast as the main one, so within one
window their energy spreads over more bins and the peak drops, though the amplitude is exact.
The same happens in the board's FFT: on the spectrogram the faster lines look a little dimmer
and wider than "−12 dB" suggests.

## 18. Third screen: the raw waveform (2026-11-06)

**Why.** To show the sound itself, next to its spectrum and spectrogram, in a way that is easy
to explain.

**What was added.** `wave_display.v` (design report §8A) and a third text page; S1 now cycles
**spectrogram → bars → waveform** (LED 0 = spectrogram, LED 3 = waveform).

| Part | How |
|---|---|
| Samples | the FFT's own input (after the S2 gain, so S2 zooms the wave too): 1,024 = 45.9 ms, 1 px each |
| Height | edges at the peak of a tone that reads **−40 dB** on the bars / spectrogram scale. There a full-scale sine (32,767) reads −12.04 dB, so a tone reading D dB peaks at 4 × 32,767 × 10^(D/20): **−40 dB → ±1,311**, −50 dB → ±414, −60 dB → ±131 (and −60 dBFS would be ±33). Louder than −40 dB is rare in the room; it is drawn red at the edge |
| Grid and labels | lines at the −50 / −60 dB peaks and the centre, labelled in the same dB as the other screens; ticks every 5 ms; a note "EDGES: PEAK OF A −40 dB TONE 1311 / 32767 RED: AT THE EDGE" |
| Trigger | each capture starts where the wave crosses 0 going up (or after 1,024 samples without one), so a steady tone stands still; about 20 pictures per second, swapped in blanking |
| Memory | 1 block RAM for the waveform (2 × 1,024 × 9 bits); the text table grew from 5 to 9 block RAMs for the third page |

Range chosen: ±1,311 (−40 dB). Considered: ±131 (−60 dB) would already clip the room's own
low-frequency hum (about −55 dB, ±233); ±256 / ±512 were the other candidates.

| Check | Result |
|---|---|
| `tb_h6_wave` + `check_h6.py` (new): a known wave, 1,600 sin(2πn / 37.3) + 300 sin(2πn / 7.1), into the real display chain; one whole frame | **PASS**: the shown capture is 1,024 consecutive input samples starting at a rising zero crossing; every plot pixel right (trace, red at the edges in 371 columns, grid); ticks; all labels (`figures/h6_wave_sim.png`) |
| `tb_h4_frame` (bars page), `tb_h5_spec` (spectrogram page), rerun after the text table and overlay changes | **PASS** both |
| Build | 3,059 logic (15 %), 1,306 registers, **42 / 46 block RAMs**, 8.75 / 24 DSP; **77.5 MHz** |
| Board | checked on the monitor; written to flash |

The centre line's "0" label was dropped: it ran into the lower "−60 dB" label on the next text
row.

## 19. Music from the Mac through the board's own USB cable; auto-rotate (2026-11-06)

**Why.** To demonstrate the spectrogram with real music picked on the laptop. The first plan
went through an ESP32-S3; the Tang's own USB cable turned out to be enough: its debugger chip
(BL616) is also a USB serial port, wired to FPGA pins 70 (in) and 69 (out) (pins from Sipeed's
`TangNano-20K-example/uart`). No extra board or wire.

**Speed test first** (`top_uart_echo.v`, `top_uart_count.v`, `host/uart_speed_test.py`; loaded
into SRAM only):

| Test | Result |
|---|---|
| Echo (pin 70 wired to 69), both directions at once | intact up to 30 KB/s; 12 % lost at 40 KB/s, 37 % at 60 KB/s, the same at 1 and 2 Mbaud: the bridge chip is the limit |
| One way, Mac → FPGA, counted by the FPGA (bytes 0, 1, 2 …) | **nothing lost in any test** (the BL616 makes the Mac wait); 33.8 KB/s with 32-byte writes, 66.9 with 64, **170 KB/s with writes of 512 bytes or more**, at 3 Mbaud |

So: Mac → FPGA is reliable and fast enough; FPGA → Mac only for a few bytes.

**Design.**

| Part | How |
|---|---|
| Format | mono, 16-bit, **24,170 Hz** (half the output rate; enough to prove the path, the Python side can shape the music to fit). The FPGA plays each sample for two output frames, the second the average with the next one, so the output stays 48,340 Hz with no steps |
| Packets | `B5 6A` \| seq \| 32 samples \| sum16 = 69 bytes; 755 packets/s = 52 KB/s (31 % of the measured 170 KB/s); seq 255 = RESET (empty the buffer, answered "R") |
| Link | 3 Mbaud from the Mac; the FPGA reads 74.25 MHz / 25 = 2.97 Mbaud |
| Flow control | credits over the same cable: 1,536 samples after RESET, then 256 more for every "C" the FPGA sends when it has played 256. The FPGA's clock sets the pace of the whole chain; the buffer cannot overflow. Every 16th "C" is followed by a status: bad sums, seq gaps, dropped, underruns |
| FPGA (`audio_rx.v`, `i2s_tx.v`) | packet check (a bad packet is dropped whole), a 2,048-sample buffer (85 ms, 2 block RAMs) that starts playing at 1,024, the fill-in, the I2S output taken unchanged from the sweep player; PA_EN on while there is music, plus 100 ms |
| Mac (`host/play_song.py`, `host/make_test_song.py`) | ffmpeg decodes any file to 24,170 Hz mono; packets are sent 8 or more per write, only as credits allow. The test song is a piano-like "Happy Birthday" (C major, harmonics with fading envelopes, 14 s) |
| Sweep | archived in `fpga_fft/archive/` (git tag `demo-sweep` = `a80d8a3`): frees its sine table (1 block RAM) |

**Auto-rotate.** The pin-27 button now freezes or resumes a rotation of the three screens,
10 s each at first, **6 s since 2026-11-07** (on at power-up); S1 still steps by hand and restarts the count. LED 1 = rotating;
LED 4 also lights for music trouble.

| Check | Result |
|---|---|
| `tb_audio` + `check_audio.py`: `audio_rx` + `i2s_tx` with a model of the Mac (RESET, credits, random delays, its bit time 1 % short as on the board) | **PASS**, normal / no delay / one corrupted packet: every sample played exactly as sent, with no gap; the bad packet dropped and counted (1 bad sum, 1 seq gap); 0 dropped; buffer peak about 1,450 of 2,048 |
| Build | 3,141 logic (16 %), 1,415 registers, **43 / 46 block RAMs**, 7.75 / 24 DSP; **76.0 MHz** (2 % spare) |
| Board | "Happy Birthday" (14.2 s) played in 14.8 s, paced by the credits; FPGA status 0 bad sums, 0 seq gaps, 0 dropped, 0 underruns; checked on the monitor; written to flash |

**Problem on the way.** The testbench's Mac model first had 6,000 samples, not a multiple of 32,
so its last packet read past its table and put undefined values on the serial line; in one run
(long Mac delays) this left the receiver model stuck and the testbench, which had no time limit,
waited 10 minutes. Fixed (6,016 samples) and given a watchdog.
