karnza007/esp32_iot_gateway/docs/reports/2026-11-01.md

# Weekly report — week ending 2026-11-01

> **Status: HDMI demo slimmed down.** The ESP32 relay (2026-10-22) and the ESP32 UART FFT
> benchmark (2026-10-29) are out of the HDMI build. What is left is only what the demo needs:
> mic or test tone → FFT → bars, text and peak readout → HDMI. This report covers the work since
> the last report, from 2026-10-26. Open items: §7.

**Summary**

| Topic | Result |
|---|---|
| Resource use of the HDMI demo, alone | **2,531 logic (12 %), 920 registers (6 %), 12 / 46 block RAMs, 7.5 / 24 DSP** (§4) |
| Removing the ESP32 benchmark from the HDMI build | logic −37 %, registers −40 %, block RAMs 20 → 12, pins 27/28 freed (§4) |
| Timing at 74.25 MHz | 74.8 → **83.3 MHz** achieved (12 % spare). The slowest path is now inside the Gowin FFT core, no longer our text table (§5) |
| The benchmark itself | unchanged: still its own build (`fpga_fft/build.sh`, `top.v`) |

**Topic:** HDMI demo (advisor request): microphone → Tang Nano 20K → Gowin FFT → monitor.
**Details:** `docs/12-hdmi-demo.md` §6.5 · **Plan:** `docs/plans/hdmi-demo.md`

---

## 1. Idea

The HDMI demo build still carried two things from earlier work that the demo no longer uses:

| Part | From | What it did | Used by the demo? |
|---|---|---|---|
| ESP32 relay (`relay_rx.v`) | H3 | mic on the ESP32, samples sent to the FPGA over UART | no: the mic is wired to the FPGA directly. **Removed 2026-10-22** (last report §8) |
| ESP32 UART FFT benchmark (`fft_link.v`) | the FFT benchmark (`docs/11-fft-benchmark.md`) | the Mac sends a 1024-point signal through the ESP32; the FPGA runs **its own FFT** on it and sends the result back for checking and timing | **no**. It was kept in the HDMI build only so both could run from one upload |

The question this week: **how much of the chip does the demo itself need,** once the benchmark is
out, and does removing it help the thin timing margin (0.8 %) left after the relay removal?

## 2. Hypothesis

> **H1.** *If the benchmark is removed from the HDMI build, logic falls by about 1,300 and block
> RAMs by 8, because the synthesis report lists `u_link` (the benchmark, with its own 1024-point
> FFT) at 1,319 LUTs, 622 registers and 8 block RAMs, and nothing else depends on it.*

It would be wrong if the drop were much smaller (the tool shares or keeps logic), or if the
picture, buttons or LEDs stopped working (something did depend on it).

> **H2.** *Timing gets no worse,* since the 27 MHz benchmark and the 74.25 MHz demo share no logic.
> A smaller design usually places more easily, but this is not guaranteed.

## 3. Test structure

```
  HDMI build ══ THE VARIABLE: benchmark in / out ══▶ Gowin synthesis + place & route ──▶ report
  (same source otherwise: commit fd93f48)                                                 + monitor
```

| Setting | Baseline (`fd93f48`) | This test |
|---|---|---|
| Demo source (mic, tone, FFT, picture, text) | as built | unchanged |
| ESP32 benchmark `u_link` + pins 27/28 | in | **out** |
| Mic rate | 44,621 Hz | unchanged |

Prediction, before the build: logic **≈ 2,700**, registers **≈ 920**, block RAMs **12**.

## 4. Results

**Totals** (place & route report):

| Resource | With benchmark | Demo only | Change | Predicted |
|---|---|---|---|---|
| Logic (LUT + ALU) | 4,027 (3,295 LUT + 714 ALU) | **2,531** (2,037 + 476) | −1,496 (−37 %) | ≈ 2,700 |
| Registers | 1,542 | **920** | −622 (−40 %) | ≈ 920 ✅ |
| Block RAM (18 kbit) | 20 | **12** | −8 | 12 ✅ |
| DSP (multipliers) | 9.5 | **7.5** | −2 | – |
| I/O pins | 22 | **20** | −2 (27, 28) | 20 ✅ |
| Timing, 74.25 MHz clock | 74.8 MHz | **83.3 MHz** | +8.5 MHz | "no worse" ✅ |

**Where the demo's resources go** (synthesis report, per block):

| Block | What it does | LUT | ALU | Registers | Block RAM | DSP |
|---|---|---|---|---|---|---|
| **Spectrum** (`spectrum.v` + Gowin FFT + Hann window) | window, 1024-point FFT, magnitude, dB | **939** | 193 | 265 | **9** | yes (5 prims) |
| **Text** (`text_overlay`, `rom_text`, tick and font ROMs) | letters, labels, kHz ticks | **436** | – | 67 | 1 (font) | – |
| HDMI encoders (×3 colours) | colours → HDMI signals | 252 | 39 | 45 | – | – |
| Mic receiver + gain (`mic_source`) | INMP441 → 16-bit samples | 118 | 5 | 78 | – | – |
| Peak readout | loudest bin → "1002 Hz", "-23 dB" | 104 | 42 | 151 | – | yes (6 prims) |
| Test tone + sweep (`tone_gen`) | sine table, 1 kHz + sweeping tone | 102 | 94 | 156 | 1 (sine) | yes (1 prim) |
| Bars + 720p timing | draws the bars, sync | 71 | 22 | 80 | 1 (bar heights) | – |
| Buttons, LEDs, top level | S1/S2 debounce, LED health | 27 | 42 | 78 | – | – |
| **Total** | | **2,049** | **437** | **920** | **12** | **7.5 blocks** |

(Synthesis totals differ slightly from place & route: 2,049 vs 2,037 LUT, 437 vs 476 ALU. Place
& route merges and splits a little logic.)

**Monitor check (2026-10-29):** ✅ works on the monitor (uploaded after re-plugging the board, §6).

## 5. Interpretation

- **H1 holds.** Registers, block RAMs and pins fell by exactly the benchmark's share. Logic fell
  **more** than predicted (−1,496 vs ≈ −1,300): the estimate counted only the benchmark's LUTs
  (1,319) and forgot its 221 adders (ALU). 1,319 + 221 = 1,540, within 3 % of what was saved.
- **The demo alone uses about one eighth of the chip.** The **FFT is the biggest part** (about
  45 % of the demo's logic and 9 of its 12 block RAMs). Text is second (about 20 %), and most of
  that is the text table, built from logic. Everything else is small.
- **H2 holds, better than expected.** The demo's clock reaches 83.3 MHz, 12 % above the 74.25
  needed. The slowest path moved: it was our text-table lookup (`rom_text`); it is now inside the
  Gowin FFT core (a multiplier output into its memory). Timing varies a little from build to build
  with placement, so 83.3 is one build, not a guarantee. The point is that the margin went from
  0.8 % to 12 %.
- **Room for the next steps:** 88 % of the logic and 34 of 46 block RAMs are free. A lower sample
  rate, a noise floor and a debug UART (§7) will all fit easily.

## 6. Problems and what they taught us

| Problem | What it taught us |
|---|---|
| The board's USB debugger stopped answering twice: "Cable failed to open via the channel", then on 2026-10-29 the programmer hung at 100 % CPU and had to be stopped. The cable shows up in a scan, but the FPGA behind it does not | Re-plugging the board's USB-C cable fixed the first one, earlier on 2026-10-29. It is a USB/debugger state problem, not the design. Worth trying a direct port instead of three hubs |
| The benchmark stayed in the HDMI build after it was finished, costing 37 % of the logic and 8 block RAMs for nothing, and pushing timing to its limit | Remove finished experiments from a build once they have their own build; record where they went |

## 7. Next week

- [x] Monitor check of this build ✅ 2026-10-29
- [x] Sample rate ÷2: mic divider 26 → 52 = **22,311 Hz** (§8) ✅ 2026-10-29
- [x] Gain and dB scale explained; display floor at −80 dB (§9) — monitor check
- [ ] UART debugging over the board's own USB cable (the debugger's serial port)
- [ ] DE0-Nano Intel FFT comparison (needs Windows/Linux for Quartus)

---

## 8. Sample rate ÷2: 44,621 → 22,311 Hz (2026-10-29)

**Why:** the sounds we test with (voice, 220/440 Hz, instruments) sit well under 11 kHz. Half the
sample rate puts all 512 bars on 0–11.2 kHz, so each bar covers half as many Hz.

| | ÷26 (before) | **÷52 (now)** |
|---|---|---|
| Mic bit clock (INMP441 allows 0.5–3.2 MHz) | 2.856 MHz | **1.428 MHz** |
| Sample rate | 44,621 Hz | **22,311 Hz** |
| Screen span | 0–22.3 kHz | **0–11.2 kHz** |
| Hz per bar (readout step) | 43.6 | **21.8** |
| kHz labels | every 2 kHz | **every 1 kHz** (same tick positions) |
| FFTs (bar updates) per second | 43.6 | **21.8** |
| Test-tone sweep 0 → fs/2 | ~10.8 s | ~10.0 s (sweep step doubled) |

One number, `MIC_BCLK_DIV` in `video_h3.v`, sets it all: the mic clock, the test tone's rate,
the readout's Hz formula, and (through `gen_h4_text.py`) the kHz axis.

**Predicted vs observed:**

| Quantity | Predicted | Observed |
|---|---|---|
| SCK period, sample spacing | 52 and 3,328 clocks | `tb_h3_mic`: 0 errors; all 8 gains bit-exact |
| Fixed 3 kHz test tone | bin 137.7 → bin 138 → "3007 Hz" | `tb_h4_peak`: "3007 Hz" in every readout |
| Sweeping tone | readout inside the latest FFT's tone bins | `tb_h4_peak`: 6 / 6 |
| Fake 1 kHz peak (bin 46) | "1002 Hz", "-23 dB" | `tb_h4_frame` + `check_h4.py`: read back from the pixels |
| Build | fits; timing met | 2,550 logic (13 %), 12 BSRAM; **80.5 MHz** (8 % spare; placement varies, Appendix A.4) |
| On the monitor | "MIC DIRECT 22311 Hz", 0–11 kHz axis, sweep and readout follow | ✅ works on the monitor (2026-10-29) |

---

## 9. Display floor at −80 dB (2026-10-29)

**Why:** the bottom of the screen showed a "grass" of weak bars. A simulation with the clean test
tone (no mic) showed that the FFT itself makes most of it: with a signal present, its rounding
leaves empty bins at **−90 to −67 dB, typically −80 dB**; with silence, every bin is empty. So the
grass is not the room or the mic, at least at gain 0.

**Change:** the screen now spans **0 to −80 dB** instead of 0 to −100 dB. Anything quieter than
−80 dB is drawn as nothing. One parameter, `FLOOR_DB = 80` in `video_h3.v`, sets:

| | Before | **Now** |
|---|---|---|
| Scale | 6 px per dB, bottom −100 dB | **7.5 px per dB, bottom −80 dB** (bars 25 % taller) |
| Gridlines | every 120 px (6 lines) | every **150 px** (5 lines: 0, −20, −40, −60, −80) |
| dB labels | 0 … −100 dB | **0 … −80 dB** (`gen_h4_text.py` reads `FLOOR_DB`) |
| PEAK level | height / 6 − 100 | height / 7.5 − 80 |
| PEAK "---" | peak under −80 dB | peak at the floor (nothing above −80 dB): the same rule |

H2's design shares `spectrum.v` and `bar_display.v`; their default stays at −100 dB.

**Predicted vs observed (simulation):**

| Quantity | Predicted | Observed |
|---|---|---|
| H2 default (−100 dB) | unchanged | bar heights **bit-identical** to before |
| Heights at −80 dB vs old heights rescaled | equal within rounding | worst difference **1 px**, every bin |
| 3 kHz half-scale tone | −18.7 dB | 459 px = **−18.8 dB** |
| Bars above the floor in the test (grass) | about half go (median −80.5 dB) | **509 → 244** of 512 |
| Frame: labels, gridlines, readout | "0 dB … −80 dB", lines at y 60/210/360/510, " -23 dB" | ✅ read back from the pixels (`check_h4.py`, new checks) |
| Peak readout, fixed and sweep | unchanged | ✅ 6/6 each |
| Build | fits, timing met | 2,529 logic (13 %), 12 BSRAM, 7 DSP; **85.0 MHz** |

**Problem on the way: a timing failure the build script didn't report.** The first build reached
only **66.8 MHz**, below the 74.25 needed, yet `build.sh` printed "timing violations: none". It
was uploaded once before the failure was noticed, then replaced.

| Part | What happened | Fix |
|---|---|---|
| `peak_readout`: level digits | multiply (÷7.5), subtract, then the tens digit (another multiply) and the character choice, all in one clock: 14.9 ns for a 13.5 ns tick | two clocks (the level changes 4 times a second, so the extra 27 ns is invisible) |
| `spectrum`: height | first written with 32-bit signed numbers: slack only +0.05 ns; at 20 bits, +0.38 ns | 20-bit unsigned maths, and the multiply got its own clock: bars arrive 1 clock later, same values |
| `build.sh` | it read Gowin's "negative slack" summary, which **does not list the 74.25 MHz clock** (made by CLKDIV, warning TA1132) | it now also flags any clock whose "achieves" is below its "needs" |

Lesson: a pass/fail line is only as good as what it reads. The "achieves 66.756 MHz" line was
on screen; the summary under it was wrong.

---

## Appendix A. What "timing" is, and how it is calculated

*Written to explain the "achieves 83.3 MHz" line of the build. All numbers come from the timing
report of the build without the benchmark (commit `1d5eef6`), in
`fpga_fft/impl/pnr/fpga_fft_tr_content.html`. Each build overwrites that file: the ÷52 build of §8
gives 80.5 MHz, the same method with slightly different wires.*

### A.1 The idea

Everything in the design moves in steps, one per clock tick. A value leaves a **register** (a
1-bit memory, a flip-flop) at one tick, passes through **logic** (LUTs) and **wires**, and must
reach the next register **before the next tick**, or that register stores a wrong value.

```
 tick n                                                                  tick n+1
   │  register A ──▶ LUT ──wire──▶ LUT ──wire──▶ ... ──▶ register B         │
   │  (launches)                                         (captures)          │
   └──────────────────────── one clock period ───────────────────────────────┘
```

| Word | Meaning | This design |
|---|---|---|
| **Clock period** | time between ticks = 1 / frequency | 74.25 MHz → **13.468 ns** |
| **Path** | one route from a register to the next | 5,947 paths checked |
| **Path delay** | how long the signal takes along it | slowest: 11.97 ns |
| **Slack** | time to spare = deadline − arrival; must be ≥ 0 | slowest: **+1.466 ns** |
| **Fmax** | the fastest clock the slowest path allows = 1 / (period − slack) | 1 / (13.468 − 1.466) ns = **83.3 MHz** |

74.25 MHz is not a choice: 720p at 60 frames/s needs 1650 × 750 × 60 = 74.25 million pixel slots
per second. So the design must pass at exactly that clock; Fmax only tells how much room is left.

### A.2 How the tool gets the numbers (static timing analysis)

The numbers are **calculated, not measured**. After place & route, Gowin's timing analyser
(STA, *static timing analysis*) knows where every LUT and wire is. It looks up the delay of each
piece in Gowin's model of the chip and adds them up for every path. Nothing is simulated and
nothing is measured on the board.

1. **Which clocks exist.** We tell it one thing, in `fpga_fft/src/top.sdc`: the crystal on pin
   4 is 27 MHz (`create_clock -period 37.037`). The tool works out the rest from the design:
   PLL ×55 ÷ 4 → 371.25 MHz, then CLKDIV ÷5 → **74.25 MHz**. That is where "needs 74.250 MHz" comes
   from.
2. **Worst case.** For the "is it fast enough" check (*setup*), it uses the **slow corner**: the
   chip at its lowest voltage (0.95 V) and hottest (85 °C), the slowest a GW2AR-18 C8/I7 part
   may be. A path that passes there passes on every board, at any temperature in range.
3. **Every path** from each register to the next: 5,947 paths into 3,146 endpoints.
4. **Arrival vs deadline** for each: the steps below.

**Worked example: the text-table lookup** (`addr1` → `rom_text` output, slack +1.784 ns):

| Step | Delay (ns) | Total (ns) | What it is |
|---|---|---|---|
| Clock edge at the clock source | 0 | 0.000 | tick n |
| Clock travels to register A | 0.329 + 2.271 | 2.601 | the clock net reaches 956 registers, so it takes time |
| Register A puts out its value | 0.232 | 2.833 | *clock-to-Q* |
| 10 LUTs (0.37–0.56 each) | 4.345 | | logic |
| 10 wires between them (0–1.40 each) | 7.072 | | routing: **61 % of the path** |
| **Data arrives at register B** | | **14.249** | |
| Next clock edge | 13.468 | 13.468 | tick n+1 |
| Clock travels to register B | 0.329 + 2.271 | 16.069 | same clock tree, so the same delay (*skew* 0) |
| Register B needs the data this early (*setup time*) | −0.035 | **16.034** | the deadline |
| **Slack = deadline − arrival** | | **16.034 − 14.249 = +1.784** | ✅ in time |

The clock delay (2.6 ns) appears on both sides and cancels. What counts is the data path:
**11.65 ns**, against the 13.43 ns available.

**The other check, hold:** data must also not arrive **too early**, or it would overwrite what
register B is capturing at the same tick. That is checked with the **fast corner** (1.05 V,
0 °C). It almost never fails within one clock, and the build has no hold violations either.

### A.3 What it says about the real board

- **The board is never measured.** The tool trusts Gowin's delay model, which Gowin built by
  measuring many chips, with safety margin.
- **A real chip on a desk is usually faster** than the slow corner (≈ 25 °C, ≈ 1.0 V). That is
  why a design that fails timing by a little often *seems* to work on the bench. Then it fails on
  a hot day, on another board, or once in a million frames. **Pass in STA, don't trust the bench.**
- **Measuring it on the board** is possible only roughly. Raise the clock until results go wrong
  (overclocking). Our HDMI clock must stay at exactly 74.25 MHz, so this is not useful here, and
  a scope cannot see delays inside the chip.

### A.4 Why it improved this week (74.8 → 83.3 MHz)

| | With the benchmark | Without |
|---|---|---|
| Text-table path | 13.33 ns, slack 0.105 ns (slowest in the chip) | **11.65 ns**, slack 1.784 ns |
| Its logic | 10 LUTs | the same 10 LUTs |
| Slowest path in the chip | text table → **74.8 MHz** | inside the Gowin FFT (11.97 ns) → **83.3 MHz** |

The logic is identical, so the 1.7 ns saved is **wire**. Two reasons:
1. **More room.** The placer no longer had to fit the benchmark's ~1,500 logic cells and 8
   block RAMs around the demo, so the text table's LUTs sit closer together.
2. **No shared register.** With the benchmark in, the tool merged the text table's address
   register with the bar drawer's copy of x (to save a register). That one register fed two
   blocks in different places, so it was close to neither. Now the text table has its own.

Placement also varies from build to build: the same text path gave 79.6 MHz in one earlier build
and 74.8 MHz in the next. So 83.3 MHz is this build's result, not a promise. What changed for
good is the margin: 0.8 % → 12 %.

### A.5 Reading it yourself

| What | Where |
|---|---|
| Summary (needs / achieves, violations) | the last lines of `DESIGN=hdmi fpga_fft/build.sh` |
| Full report, the 25 slowest paths, each step as in A.2 | `fpga_fft/impl/pnr/fpga_fft_tr_content.html` (open in a browser) |
| The clock we declare | `fpga_fft/src/top.sdc` |
