karnza007/esp32_iot_gateway/docs/reports/2026-10-25.md

# Weekly report — week ending 2026-10-25

> **Status: HDMI demo complete (H1–H4).** The live microphone spectrum shows on the monitor
> with labels and a peak readout, sampled at 44,621 Hz. This report covers the work since the
> last report (2026-10-12 → 10-22). Open items: §7.

**Summary**

| Topic | Result |
|---|---|
| HDMI demo H3: live mic on the monitor | ✅ INMP441 wired straight to the Tang Nano 20K (pins 25/26/29), first at 15,067 samples/s, then 29,748 and **44,621** (closest to 44.1 kHz); 220 Hz and 440 Hz shown correctly |
| HDMI demo H4: labels | ✅ title, source and rate, gain, dB and kHz labels, tick lines, and a peak readout ("1002 Hz", "-23 dB") updated 4× a second (§8) |
| Why it took a week | The mic data reaching the 20K was scrambled. A swap test on the Tang Nano 4K cleared the mic and the receiver logic, which left the 20K's pins and clock as the cause (§4, §5) |
| New tools | A mic check build (mic → 20K → UART → ESP32 → viewer, with a built-in test tone) and a raw-bits mode that shows every bit on the mic's data wire (§3) |
| Receiver fixes | SCK/WS from flip-flops (no glitches); WS changes on the falling SCK edge (no race with the mic). Not the cause, kept as real fixes (§6) |
| Lesson | A scope probe on SCK alone broke a working mic (§6) |

**Topic:** HDMI demo (advisor request): microphone → Tang Nano 20K → Gowin FFT → monitor.
**Details:** `docs/12-hdmi-demo.md` §5 · **Plan:** `docs/plans/hdmi-demo.md`

---

## 1. Idea

H1 (test pattern) and H2 (spectrum of a test tone) worked on 2026-10-09. H3 needs real sound:
the INMP441 microphone wired to the 20K. On 10-09 the mic gave no data, and its connection was
unstable even on the ESP32. The question this week: **where does the mic signal go wrong
between the microphone and the FFT, and how do we get a clean signal into the 20K?**

## 2. Hypothesis

> **H1.** *If the INMP441 is clocked by the 20K and its samples are sent to the PC through the
> existing UART link, the viewer shows the same clean audio as the ESP32 does, because the
> receiver logic passes simulation against a mic model.*
> **Falsified by:** scrambled samples while the test tone through the same link stays clean.

> **H2.** *If the same mic and the same receiver logic work on a different board (the Tang
> Nano 4K), the fault is specific to the 20K setup (pins, wiring, clock).*
> **Falsified by:** the 4K showing the same scrambled data.

## 3. Test structure

The HDMI chain hides the samples, so a separate **mic check** build was made first:

```
  INMP441 ══ THE VARIABLE: board, pins, bit clock ══▶ FPGA (i2s_master_rx) ──▶ framer ──▶ UART 1 Mbaud
                                                       ▲ S1: 1 kHz test tone          │
                                                                                      ▼
                         inmp441_viewer.py / sd_raw.py ◀── USB ◀── ESP32-S3 fpga_uart_bridge
```

| Part | What it does |
|---|---|
| `fpga_fft/src/top_mic_uart.v` | 20K, 27 MHz crystal, no PLL. Samples go out in the audio project's v3 frames, so the existing viewer reads them |
| Test tone (S1) | A 1 kHz tone made inside the FPGA. If it arrives clean, the link is proven and any fault is before the FPGA |
| Raw-bits mode (S2) | Sends all 64 bits of every WS frame from the SD wire, exactly where the receiver samples them. `host/sd_raw.py` shows where in the frame the mic is talking |
| Swap test | The same mic and the same `i2s_master_rx.v` on the Tang Nano 4K (`fpga/src/top.v`) |

**Prediction for a working mic in a quiet room:** values near zero, neighbouring samples
strongly alike (correlation well above 0.5), no repeated odd values. A word shifted by one
bit shows up as values like −64, −128 or 32767 and a correlation near 0.

## 4. Results

| # | Setup | Result |
|---|---|---|
| 1 | Mic check, test tone | ✅ 1 kHz exact, 0 frames lost: the link works |
| 2 | Mic on the ESP32 with the scope probe on SCK | ❌ scrambled (probing SD or WS alone was fine) |
| 3 | Mic on the ESP32, no probe, 3.07 MHz | ✅ correlation 0.99, 220 Hz shown: **the mic works** |
| 4 | 20K pins 73/74/75, 643 kHz, 8 mA | ❌ garbage, correlation 0.05 |
| 5 | SCK moved to pin 76; 4 mA; 8 mA; 2.25 MHz | ❌ shifted words (−64, −32, −128); 2.25 MHz worse |
| 6 | + receiver fixes (§6) | ❌ correct in simulation; on the board, words still one bit off (32739, 32736, 32704) |
| 7 | Raw bits, pin 76 | ❌ SD busy in **both** halves of the frame (30–40 % ones at every bit), no fixed start bit |
| 8 | **Tang Nano 4K**, pins 39/40/41, 964 kHz | ✅ values −465…517, correlation 0.77 (quiet room); 220 / 440 Hz confirmed |
| 9 | **20K pins 25/26/29, 964 kHz** (27 MHz ÷ 28), 8 mA | ✅ values −54…47, correlation 0.954 (quiet room), 0 frames lost; 220 / 440 Hz confirmed |
| 10 | **H3 on the monitor**: same pins, 74.25 MHz ÷ 77 = 964 kHz | ✅ live spectrum, tones in the right place |

**Predicted vs observed (quiet room):**

| Quantity | Predicted | 20K pin 76 (run 6) | 4K (run 8) | 20K pins 25/26/29 (run 9) |
|---|---|---|---|---|
| Most common values | near 0 | −64, −128, 32739 | −1, −4, 1 | −1, 1, −3, 0 |
| Neighbour correlation | > 0.5 | 0.06 | 0.77 | 0.954 |
| Frames lost | 0 | 0 | 0 | 0 |

## 5. Interpretation

- **H1 was falsified** on pins 73–76: the test tone was clean but the mic data was not, so the
  fault was between the mic and the FPGA's receiver.
- **H2 held**: the 4K, with the same mic and the same receiver file, was clean in its first
  run. That cleared the microphone and the logic in one step.
- On the 20K, the run that worked changed **two things at once**: the pins (76/74/75 →
  25/26/29) and the bit clock (643 kHz → 964 kHz, the 4K's value). Which one mattered is
  **not known**. 643 kHz is close to the mic's 0.5 MHz minimum, but 2.25 MHz also failed on
  pin 76, so the bit clock alone doesn't explain it. The demo keeps both settings.
- Raw bits (run 7) showed the mic talking in the half of the frame where a left-channel mic
  must be silent. So the mic was not following the WS signal the FPGA sent, which fits a
  disturbed clock or WS at the mic rather than a logic fault.

## 6. Problems and what they taught us

| Problem | What it taught us |
|---|---|
| **A scope probe on SCK alone broke a working mic** (run 2). The first conclusion was that the mic was faulty; the same result on a second mic, and moving the probe to one wire at a time, pointed to the probe | A probe adds capacitance and a long ground lead. On a fast clock edge this can create extra edges the mic counts. Probe SD and WS, not SCK, and check a "broken part" conclusion against a second part |
| **Glitch theory:** SCK/WS were decoded from a counter by logic, which can flick briefly when several counter bits change together. Fixed by driving them straight from flip-flops | A real fault, but it changed nothing on the board. Kept as good practice; said so instead of claiming it as the fix |
| **WS race:** WS changed on the same SCK edge the mic reads it on, so the mic could see the old or the new value. Fixed: WS now changes on the falling edge; capture start `CAP_START` 2 → 1 | Also real, also not the cause. The simulation mic models were rewritten to read WS on the rising edge and change SD on the falling edge like the real chip, so this kind of race now shows up in simulation |
| A week of single changes on the 20K (pin, drive, clock, logic) without isolating the cause | **Swap in a known-good reference early.** The 4K test took one run |
| Arduino's `ctags` stopped working after macOS 27 ("bad CPU type") | It's an Intel binary; installing Rosetta fixed it |
| Raw-bits mode needs 4 words per sample: it fits the 1 Mbaud link only at `BCLK_DIV` ≥ 42 | Documented in `top_mic_uart.v`; at today's 28 it would need 120 kB/s of a 100 kB/s link |

**Simulation status:** `tb_mic_uart` (mic + tone, `BCLK_DIV` 28), `tb_h3_mic` (8 gains; run
at 77, 39 and 26 clocks per SCK), `tb_h4_frame`, `tb_h4_peak` (fixed and sweeping tone) and
`fpga/sim/run_sims.sh` (audio project, shared receiver) all pass.

## 7. Next week

- [x] H4: gridlines, kHz / dB labels, peak readout on the monitor (2026-10-22, §8)
- [ ] Optional: find which change fixed the 20K (pins or bit clock) by putting one back
- [ ] Optional: finer peak frequency (interpolate between bins; now ±22 Hz)
- [ ] DE0-Nano: Intel FFT IP comparison (needs Windows/Linux for Quartus)

## 8. H3 → H4: higher sample rate, labels and a peak readout (2026-10-22)

**Higher sample rate.** With the mic working at 15,067 Hz, the rate was raised in two steps,
each checked on the monitor. The bit clock is 74.25 MHz ÷ a whole number, so the nearest values
were used:

| Divider | Bit clock | Sample rate | Result |
|---|---|---|---|
| 77 | 964 kHz | 15,067 Hz | clean (H3) |
| 39 | 1.904 MHz | 29,748 Hz (2× would need ÷38.5) | clean |
| **26** | **2.856 MHz** | **44,621 Hz** (44.1 kHz +1.2 %; ÷27 = 42,969 Hz is −2.6 %) | **clean, kept** |

So on pins 25/26/29 the mic also works at 2.86 MHz, close to its 3.2 MHz limit, where pin 76 had
failed at 2.25 MHz.

**H4 on the screen** (`docs/12-hdmi-demo.md` §6, with a simulated frame):

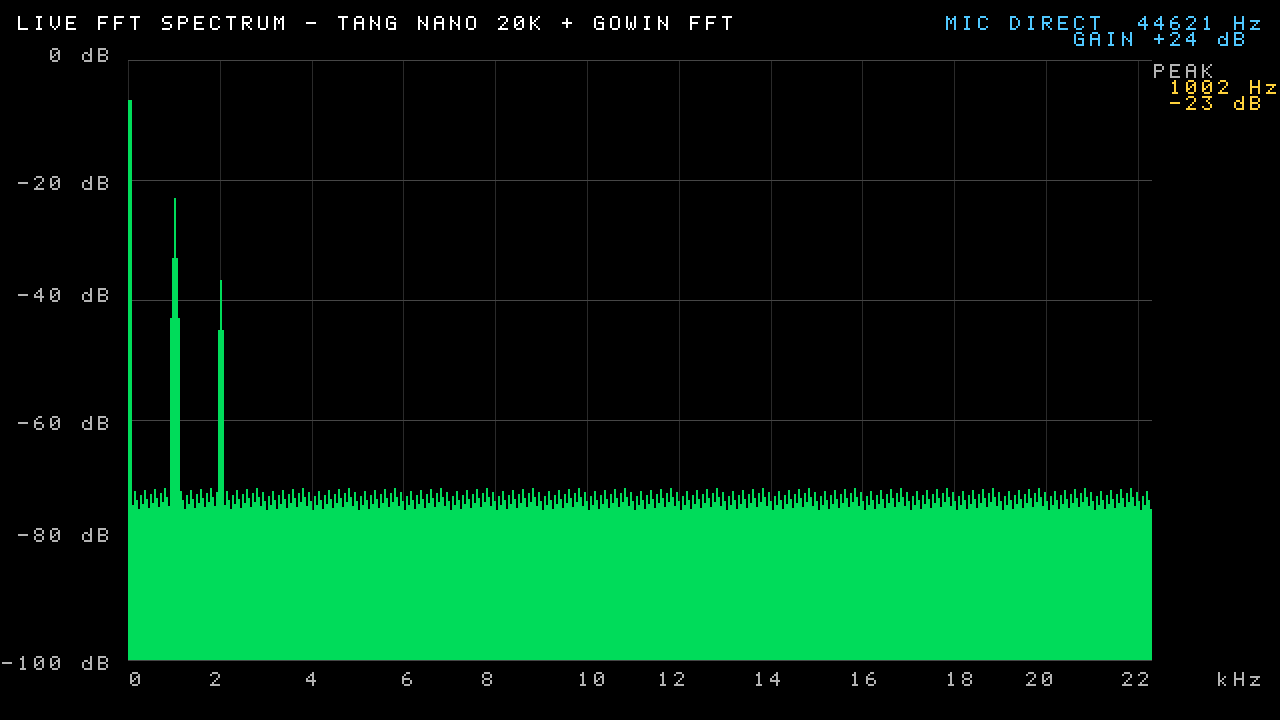
[picture p1: docs/figures/h4_frame_sim.png]
H4 frame rendered in simulation


| Part | How |
|---|---|
| Text | 80 × 45 grid of 16×16 cells; a 5×7 font written for the project, drawn at 2×; tables generated by `fpga_fft/gen_h4_text.py` from the layout and the mic rate |
| kHz axis | labels and tick lines every 2 kHz, switched with the source (S1) |
| Peak readout | tallest bin of the latest FFT, shown about 4× a second: Hz = bin × fs / 1024 (±22 Hz), dB = height / 6 − 100 |

**Predicted vs observed (simulation, then monitor):**

| Quantity | Predicted | Observed |
|---|---|---|
| Fixed 3 kHz test tone | bin 69 → "3007 Hz" | "3007 Hz" in every readout (`tb_h4_peak`, real FFT model) |
| Fake 1 kHz peak at −23 dB | "1002 Hz", "-23 dB" | read back from the rendered pixels (`check_h4.py`) |
| 220 / 440 Hz on the mic | about 218 / 436 Hz (one bin = 43.6 Hz) | H4 works on the monitor; readout values not written down yet |
| Sweeping test tone, readout follows it | readout = tone's bin in the latest FFT | in simulation ✅; on the monitor ✅ (2026-10-22) |

**Problems and what they taught us**

| Problem | What it taught us |
|---|---|
| First H4 build met 74.25 MHz by only 0.4 %: the text-ROM address (row number swapped per source) was computed and looked up in one clock | Give the address its own clock. Cost: one more clock of picture delay (sync delayed by 4), margin now 7 % |
| The peak readout didn't follow the sweeping test tone: it kept the tallest bar of each 0.23 s, and with equal heights the first bar of the window won, so it trailed the tone by up to ~550 Hz | Show the latest FFT's peak instead. A test with the tone sweeping one bin per FFT now checks this |
| The test tone ran at its own 48,340 Hz while the mic ran at 44,621 Hz: two axes, two formulas | The tone now runs at the mic's rate (`tone_gen` SAMPLE_DIV = 64 × `MIC_BCLK_DIV`) |

**Simplified (2026-10-22):** the ESP32 relay source is out of the HDMI build. The direct mic
works, so S1 now switches between just the direct mic and the test tone. Both run at
44,621 Hz, so the screen has one kHz axis and one frequency formula. Simulations pass again;
timing still met (74.8 MHz achieved; it varies from build to build, see `12-hdmi-demo.md` §6.5). Checked on the monitor: S1 toggles MIC DIRECT ↔ TEST TONE.
