karnza007/esp32_iot_gateway/docs/reports/2026-10-11.md

# Weekly report — week ending 2026-10-11

> **Status: complete for this week.** Part A (ESP32-S3) and Part B (Gowin FFT on a Tang Nano
> 20K) both have results. The Tang Nano 4K could not build the FFT core, so the advisor lent a
> Tang Nano 20K. The advisor's HDMI demo (§13) shows a spectrum on a monitor from a test signal;
> the live microphone step is in progress. Open items: §7.

**Summary of the week**

| Topic | Result |
|---|---|
| Is the Gowin FFT core correct? | Yes for normal signals (7 of 8 tests; 2.18 LSB rms); **wrong at full scale** (values near −32768 wrap) — undocumented by Gowin (§4B, §5B) |
| Accuracy vs the ESP32 | ESP32 plain C 0.46 LSB (near ideal), ESP32 SIMD 1.82, Gowin 2.18 (§11) |
| Speed (1024-point FFT) | Gowin 7,190 cycles: 266 µs @ 27 MHz, 133 µs @ 54, **88.8 µs @ 81** (PLL); ESP32 SIMD 184 µs, plain C 1,149 µs (§8, §12) |
| Free simulation | The encrypted core can be simulated with Icarus via its gate-level model; bit-for-bit identical to the board (§10) |
| Ease of use | Generator instant; manual hard to find and vague; 4K chip silently unsupported; full-scale limit undocumented (§5B) |
| HDMI demo | 720p picture (H1) and a live spectrum of a test signal (H2) on the monitor; microphone (H3) blocked by an unstable mic connection (§13) |

**Topic:** FFT benchmark: is the vendor FFT IP core correct, and how easy is it to use?
**Details:** `docs/11-fft-benchmark.md` · **Plan:** `docs/plans/fft-benchmark.md`
**Audio work** (M3) is paused for this benchmark.

---

## 1. Idea

The advisor asked two questions about vendor FFT IP cores:

1. **Is the Gowin FFT core correct?**
2. **How easy is it to use** compared with Intel's FFT core (DE0-Nano, Cyclone IV, to be tested later)?

The method is the same for every device: the Mac generates a known test signal, the device
computes its FFT, and the Mac checks the answer against an exact reference.

The **ESP32-S3** was added as a third device. Espressif's ESP-DSP library has a 16-bit integer
FFT, so it answers two extra questions: *what does a software FFT on a microcontroller achieve?*
and *is an FPGA worth it for this job?*

Everything is done in **16-bit integer arithmetic**. Every device halves its data at each FFT
stage, so the output is `FFT(x) ÷ N` in int16. Python's floating-point FFT is used only as the
measuring ruler, not as a competitor.

---

# Part A — ESP32-S3 ✅

## 2A. Hypotheses

| | Hypothesis | Would be falsified by |
|---|---|---|
| **H3** | The ESP32's ESP-DSP 16-bit FFT is correct, and about as accurate as any other 16-bit FFT (same bit widths, same ÷2-per-stage scaling) | Any peak in the wrong bin, or RMS error above the correctness gate on any signal |
| **H4** *(ESP32 half)* | One 1024-point FFT takes a measurable, repeatable time on the ESP32, to be compared later with the FPGA | Timing that varies a lot from run to run |

## 3A. Test structure

```
  Mac (host/fft_bench.py)
   ├─ makes 8 test signals (int16)                       ┐
   ├─ sends them ──CH9102 USB-UART, 2 Mbaud──▶ ESP32-S3   │ checksum on request
   │                                 dsps_fft2r_sc16      │ and reply, so a transport
   │                                 + bit-reverse        │ error can't pass as an
   │                                 + CPU cycle counter  │ FFT error
   ◀────────────── spectrum + cycle counts ───────────────┘
   └─ scores it against: numpy.fft ÷ N (the ruler, float)
                         an ideal 16-bit integer FFT (the accuracy ceiling)
```

| Setting | Value |
|---|---|
| FFT sizes | 256, 512, 1024, 2048, 4096 |
| Arithmetic | int16 data, Q15 twiddles, ÷2 per stage |
| CPU clock | 240 MHz |
| Timing | Each FFT run 20× on fresh copies of the input; fastest run reported |
| Versions tested | **SIMD** (`dsps_fft2r_sc16_aes3`, assembly using the S3's vector instructions; what you get by default) and **plain C** (`dsps_fft2r_sc16_ansi`) |

**What "SIMD" and "plain C" mean.** Both are Espressif's own FFT from the same library
(ESP-DSP), computing the same 16-bit FFT. They differ only in *how* the CPU does the arithmetic:

| | Plain C (`_ansi`) | SIMD (`_aes3`) |
|---|---|---|
| Written in | Ordinary C, works on any ESP32 | Hand-written assembly for the ESP32-**S3** only |
| How it computes | One multiply or add per instruction | **S**ingle **I**nstruction, **M**ultiple **D**ata: the S3's vector unit works on 128-bit registers, i.e. **8 int16 numbers in one instruction** |
| Analogy | A cashier scanning items one at a time | A cashier scanning a whole tray of 8 items at once |
| Chosen by | Calling `dsps_fft2r_sc16_ansi()` explicitly | **Default:** `dsps_fft2r_sc16()` picks it automatically on an S3 |
| Speed, N = 1024 | 1,030 µs | 65 µs (**16× faster**) |
| Accuracy (noise) | 0.455 LSB (near the best possible 0.427) | 1.82 LSB (about 4× worse; see §5A) |

The SIMD version takes arithmetic shortcuts to fit 8 numbers through at once, and those
shortcuts round less carefully. Testing both shows the price of that speed.

**Test signals and what each one checks:**

| Signal | Checks |
|---|---|
| Impulse | Every bin, and the ÷N scaling (32767 in → 32 in every bin at N = 1024) |
| DC | All energy in bin 0 |
| Tone on a bin | One clean spike in the right bin |
| Tone between bins | Spectral leakage matches the reference |
| Two tones | Both found, correct relative size (12 dB apart) |
| Random noise (full scale) | Every butterfly exercised: the average error |
| Full-scale square wave | Largest real input: no overflow |
| Complex tone | The imaginary input path works |
| Overload *(not scored)* | Input too big for 16 bits: shows *how* the device fails |

**How "correct" is decided.** Two separate questions:

| Question | Rule |
|---|---|
| 1. Is it a correct FFT? | Every peak in the right bin, and RMS error ≤ **4 LSB** (see §6, problem 3) |
| 2. How accurate? | RMS error on random noise, compared with the best possible 16-bit FFT (0.43 LSB at N = 1024) |

*LSB = one step of the 16-bit integer, the smallest possible rounding error.*

**Prediction before the run:** a correct 16-bit FFT is off by about 0.4–1.3 LSB rms, depending
on how it rounds; a broken one is off by hundreds of LSB (measured on modelled designs, §6
problem 2).

## 4A. Results

**Correctness:** every peak in the right bin, at every size, for both versions.

| Version | Signals correct (4 LSB gate) |
|---|---|
| SIMD | **40 / 40** (8 signals × 5 sizes) |
| Plain C | **24 / 24** (8 signals × 3 sizes) |

**Accuracy (RMS error on random noise):**

| N | Best possible 16-bit | ESP32 plain C | ESP32 SIMD |
|---|---|---|---|
| 256 | 0.398 LSB | 0.488 | 1.763 |
| 1024 | 0.427 LSB | **0.455 (+0.5 dB)** | **1.821 (+12.6 dB)** |
| 4096 | 0.419 LSB | 0.426 | 1.837 |

Neither version gets less accurate as N grows.

**Speed (one FFT, 240 MHz; fastest of 20 runs; how it's measured: §8):**

| N | Copy input | SIMD FFT | Bit-reverse (to natural order) | **SIMD total** | Plain C FFT | **Plain C total** |
|---|---|---|---|---|---|---|
| 256 | 2.8 µs | 14.2 µs | 26.8 µs | 43.9 µs | 209.8 µs | 239.5 µs |
| 512 | 5.5 µs | 30.4 µs | 53.9 µs | 89.8 µs | — | — |
| **1024** | **10.8 µs** | **65.1 µs** | **108.2 µs** | **184.2 µs** | **1,029.9 µs** | **1,148.9 µs** |
| 2048 | 21.5 µs | 139.3 µs | 216.8 µs | 377.6 µs | — | — |
| 4096 | 42.8 µs | 297.2 µs | 434.3 µs | 774.4 µs | 4,867.8 µs | 5,345.0 µs |

Fastest and average of 20 runs differ by under 1 %. Repeat runs on three firmware builds gave
the same FFT and bit-reverse times. *(Earlier drafts gave "173 µs" for the SIMD total: that
was FFT + bit-reverse without the copy step. The copy is now included because the FPGA's time
includes loading its input too.)*

**Predicted vs observed:**

| Quantity | Predicted | Observed |
|---|---|---|
| Error of a correct 16-bit FFT | 0.4–1.3 LSB | Plain C 0.43–0.49 ✅ · SIMD 1.76–2.00 ❌ (above the range) |
| Peaks in the right bin | all | all ✅ |
| Error grows with N | not expected | does not grow ✅ |

## 5A. Interpretation

**H3: partly confirmed.** Both versions are correct FFTs. The plain C version is about as
accurate as a 16-bit FFT can be. **The fast SIMD version is about 4× less accurate**, which is
more than predicted.

**Why the SIMD version is less accurate.** Three systematic effects, each exactly reproducible:

| Effect | Evidence | Which version |
|---|---|---|
| Output 1 LSB low | Impulse: every bin reads 31 instead of 32 | Both (rounding constant 0x7FFF instead of 0x8000 rounds exact halves down) |
| Gain loss of 2 LSB per stage | DC bin short by exactly 8, 12, 16, 20, 24 at N = 16, 64, 256, 1024, 4096 (= 2 × log₂N) | SIMD only |
| Extra rounding noise, mostly in the real part | 1.43 LSB left after removing bias and gain; real part 1.87, imaginary 1.10 | SIMD only |

Plain C doesn't have the last two, so they come from how the SIMD assembly does its arithmetic,
not from the FFT method. **ESP-DSP's fast version trades about 4× accuracy for 16× speed.** For
audio, the difference is inaudible: a 0.01 dB gain error and about 2 LSB of noise.

**Two surprises:**
- **Putting the output back in natural order takes longer than the FFT itself** (108 µs vs
  65 µs at N = 1024). The FPGA core outputs natural order directly, so the fair ESP32 number for
  comparison is the **total: 184 µs** (copy + FFT + reorder; see §8).
- **The two versions fail differently when overloaded.** Plain C wraps around, matching the
  Python model to 0.1 LSB (1,448 vs 1,448 LSB rms). SIMD does about 7× less damage (212 LSB rms),
  which is consistent with saturating (clipping) instead of wrapping.

**H4 (ESP32 half): confirmed.** The timing is repeatable to under 1 %. The comparison with the
FPGA waits for Part B.

---

# Part B — FPGA (Gowin FFT IP on the Tang Nano 20K)

## 2B. Hypotheses

| | Hypothesis | Result |
|---|---|---|
| **H1** | The Gowin FFT core is a correct 16-bit FFT (same 4 LSB gate) | ⚠️ **Partly.** Correct on 7 of 8 signals; **wrong at full scale** (§4B) |
| **H2** | A 1024-point core fits on the Tang Nano 4K; memory runs out before logic | ❌ **Rejected** (§3B) |
| **H4** | The FPGA computes one FFT faster than the ESP32 and needs no CPU | ⚠️ **Partly at 27 MHz:** slower than ESP32 SIMD, faster than plain C; 6× fewer clock cycles; no CPU. ✅ **At 54 and 81 MHz (§12): faster than both** (81 MHz: 88.8 µs) |

## 3B. What happened, step by step

### F1: the Tang Nano 4K cannot build a 1024-point Gowin FFT

The core's working memory needs **true dual-port** block RAM (both ports can read and write),
because each FFT butterfly reads two values and writes two values back in the same memory. The
Tang Nano 4K's chip (GW1NSR-4C) only offers single-port and semi-dual-port block RAM. Confirmed
three ways:

1. **Gowin datasheet DS861, Table 2-5, note 1:** *"GW1NS-4C/4 do not support dual port mode."*
2. **Gowin IDE device lists:** the dual-port RAM generator supports the 9K and 20K chips but not the 4K's.
3. **Build test:** a minimal true dual-port RAM fails on the 4K and builds on the 9K and 20K (control).

Building the memory out of flip-flops instead limits the core to **16 points** (64 % of logic).
The same 1024-point core builds on the 9K and 20K chips, so the advisor lent a **Tang Nano 20K**
(GW2AR-LV18QN88C8/I7). It runs on the board's own **27 MHz** crystal, no PLL.

### F2: the data path to the 20K works (echo test, no FFT)

```
 Mac ──2 Mbaud──▶ ESP32-S3 ──GPIO17 → pin 27, 1 Mbaud──▶ Tang Nano 20K: receive → RAM → send
 Mac ◀─────────── ESP32-S3 ◀──GPIO18 ← pin 28 ─────────────────────────────────┘
```

| Test | Result |
|---|---|
| 13 payloads (9 test signals + 4 raw byte patterns) × 50 frames | **650 / 650 frames back byte for byte, 0 byte errors** |
| Round trip ESP32 → FPGA → ESP32 | 82.4 ms (pure wire time 82.1 ms: no gaps) |

So any error found in F3 belongs to the FFT core, not to the wires.

### F3: the Gowin FFT core on the FPGA

```
 Mac (fft_bench.py fpga) ─▶ ESP32 ─UART 1 Mbaud─▶ Tang Nano 20K
                                                  receive 1024 samples ─▶ buffer (BSRAM)
                                                        buffer ─▶ Gowin fft_1024 ─▶ same buffer
                                                  cycle counter: 'start' → last result
 Mac ◀─ scores it with the SAME rules as the ESP32 ◀─ send buffer + cycle count
```

| Setting | Value |
|---|---|
| Core | Gowin FFT IP, 1024 points, forward, RS111 (÷2 per stage), 16-bit in / twiddle / out, rounding, natural output order, BSRAM, DSP multipliers |
| Clock | 27 MHz |
| Signals, gate | Exactly as in Part A (8 scored signals + overload, 4 LSB gate) |
| How the core is driven | As in Gowin's manual IPUG503, Figure 6-1: pulse `start`; supply sample `idx` while `ipd` is high; store result `idx` while `opd` is high; `eoud` marks the last result |

### The FFT core's ports: what each pin of the block does

This is the block the IP Core Generator shows for `fft_1024`. Inputs are on the left, outputs on
the right. The names follow a convention: **x n** = time-domain sample number *n* (what goes in),
**X k** = frequency bin number *k* (what comes out); `re` / `im` = real / imaginary part;
`[15:0]` = 16 wires, i.e. a 16-bit number; `[9:0]` = 10 bits, i.e. 0 … 1023.

```
                 ┌──────────────────────────────┐
     clk ───────▶│                              │──▶ sod          ┐
     rst ───────▶│                              │──▶ ipd          │ input phase
   start ───────▶│                              │──▶ eod          ┘
                 │          fft_1024            │──▶ busy           compute phase
                 │   (Gowin FFT IP, 1024 pt)    │──▶ soud         ┐
xn_re[15:0] ════▶│                              │──▶ opd          │ output phase
xn_im[15:0] ════▶│                              │──▶ eoud         ┘
                 │                              │══▶ idx[9:0]       which sample / which bin
                 │                              │══▶ xk_re[15:0]  ┐ the result
                 │                              │══▶ xk_im[15:0]  ┘
                 └──────────────────────────────┘
        ─▶ one wire (a yes/no signal)      ═▶ a bus (a number)
```

**Inputs**

| Port | Width | What it does | How our design (`top.v`) drives it |
|---|---|---|---|
| `clk` | 1 | The clock. Everything inside happens on its rising edge | The board's 27 MHz crystal |
| `rst` | 1 | Reset, active high: puts the core back in its idle state | High for the first 128 clocks after power-up (power-on reset), then low |
| `start` | 1 | "Begin one FFT now." Only noticed while the core is idle | A one-clock pulse after the 1,024 samples have arrived over the UART |
| `xn_re[15:0]` | 16 | Real part of the input sample, signed (−32768 … 32767) | Read from our buffer: the sample the core asks for with `idx` |
| `xn_im[15:0]` | 16 | Imaginary part of the input sample, signed | Same buffer word (our test signals are complex; real audio would put 0 here) |

**Outputs: status signals (the core telling us what it is doing)**

| Port | Phase | High when… | How our design uses it |
|---|---|---|---|
| `sod` | input | **S**tart **o**f **d**ata: one clock, the core takes sample x(0) at the next edge | Time-split stamp: first sample |
| `ipd` | input | **I**n**p**ut **d**ata: for all 1,024 clocks in which the core takes a sample (one per clock) | While high, our buffer supplies sample `idx` (addressed one clock ahead, since the RAM answers one clock later) |
| `eod` | input | **E**nd **o**f **d**ata: one clock, with the last sample x(1023) | Time-split stamp: last sample |
| `busy` | compute | The core is calculating (the butterflies) | Time-split cross-check (5,140 cycles) |
| `soud` | output | **S**tart **o**f **u**nloa**d**: one clock, the first result is on `xk` | Time-split stamp: first result |
| `opd` | output | **O**ut**p**ut **d**ata valid: for all 1,024 clocks in which a result is on `xk` (one per clock) | While high, we write `xk` into the buffer at address `idx` |
| `eoud` | output | **E**nd **o**f **u**nloa**d**: one clock, with the last result | Stops the cycle counter; the frame engine then sends the buffer back |

**Outputs: data**

| Port | Width | What it carries |
|---|---|---|
| `idx[9:0]` | 10 | A number 0 … 1023. **While loading:** which sample the core is taking now. **While unloading:** which frequency bin is on `xk` now (in natural order 0, 1, 2, …, because "natural order" was chosen in the generator) |
| `xk_re[15:0]` | 16 | Real part of the result for bin `idx`, signed. Scaled to FFT(x) ÷ 1024 by the RS111 setting |
| `xk_im[15:0]` | 16 | Imaginary part of the result for bin `idx`, signed |

**One FFT, in order:** we pulse `start` → `sod`, then `ipd` for 1,024 clocks while we feed
`xn` (sample `idx` each clock) → `eod` → `busy` while it computes → `soud`, then `opd` for 1,024
clocks while we collect `xk` (bin `idx` each clock) → `eoud`. The timing diagram with real
clock counts is in §8.1. Source: Gowin IPUG503, Table 4-1 and Figure 6-1.

## 4B. Results

**Correctness and accuracy (N = 1024):**

| Signal | Gowin FPGA | rms err | ESP32 SIMD | ESP32 plain C |
|---|---|---|---|---|
| Impulse | ✅ | 0.001 | 0.706 | ✅ |
| DC | ✅ | 0.000 | 0.442 | ✅ |
| Tone on a bin | ✅ | 2.330 | 0.981 | ✅ |
| Tone between bins | ✅ | 2.055 | 2.003 | ✅ |
| Two tones | ✅ | 1.799 | 1.003 | ✅ |
| **Random noise** | ✅ | **2.184 (+14.2 dB)** | 1.821 (+12.6 dB) | 0.455 (+0.5 dB) |
| **Full-scale square wave** | ❌ **WRONG** | **1023.8** | 0.507 ✅ | ✅ |
| Complex tone | ✅ | 1.866 | 1.038 | ✅ |
| Overload *(not scored)* | wraps | 1442.8 | 212 (clips) | 1448 (wraps) |

*(rms err in LSB. "+dB" = how much worse than the best possible 16-bit FFT, 0.427 LSB.)*

**Gate verdicts, both recorded (see §6, problem 3):** 4 LSB gate (fixed before this test):
**7 / 8**. Original 2 LSB gate: **4 / 8** (tone on a bin, tone between bins and noise are
2.06–2.33 LSB).

**The full-scale failure.** The FPGA returned "everything in bin 0", the spectrum of a constant,
for a square wave swinging between +32767 and −32767. F2 had already sent this exact signal
through the wires without a single wrong byte, so the error is inside the core. Probed further
by hand:

| Input | Result |
|---|---|
| Square wave, amplitude ≤ 32,762 | ✅ correct |
| Square wave, amplitude ≥ 32,763 | ❌ wrong |
| Constant +32,767 | ✅ correct |
| Constant −32,749 or lower | ❌ wrong; −32,767 comes back as **+32,767** |
| One single sample at ±32,767 | ✅ correct |
| The same on the imaginary input | ❌ wrong too |

**Speed (one 1024-point FFT; split into steps in §8):**

| | Clock | Clock cycles | Time | CPU busy? |
|---|---|---|---|---|
| **Gowin FPGA** (load + compute + unload) | 27 MHz | **7,190** | **266.3 µs** | No CPU at all |
| ESP32 SIMD (copy + FFT + reorder) | 240 MHz | 44,199 | 184.2 µs | 100 % |
| ESP32 plain C (copy + FFT + reorder) | 240 MHz | 275,734 | 1,148.9 µs | 100 % |

The same 7,190 cycles at the design's maximum clock (80.6–94.1 MHz, depending on the build)
would be about 76–89 µs: a calculation, not tested (it needs a PLL).

**FPGA resources.** This is the place & route report of the **current** design (UART + buffer
+ FFT core + time-split counters), copied from `fpga_fft/impl/pnr/fpga_fft.rpt.txt` (in the IDE:
*Place & Route Report → Resource Usage Summary*):

```
3. Resource Usage Summary
  Resources                   | Usage                               | Utilization
  Logic                       | 1612/20736                          |  8%
    --LUT,ALU,ROM16           | 1612(1349 LUT, 263 ALU, 0 ROM16)    | -
  Register                    | 649/15750                           |  5%
    --Logic Register as FF    | 647/15552                           |  5%
    --I/O Register as FF      | 2/198                               |  2%
  CLS                         | 1014/10368                          |  10%
  I/O Port                    | 9/66                                |  14%
  BSRAM                       | 8/46                                | 18%
    --SDPB                    | 2          ← our shared buffer (1024 × 32 bit)
    --DPB                     | 4          ← the core's working memory (true dual-port)
    --pROM                    | 2          ← the core's cos/sin tables
  DSP                         | 2/24                                | 9%
    --MULTADDALU18X18         | 2          ← the core's complex multiply
Max Frequency Summary:  clk  constraint 27.000 MHz  actual Fmax 94.064 MHz   (no setup/hold violations)
```

**How the usage grew as features were added** (each row is a full place & route of the 20K design):

| Build | What it contains | Logic | Registers | BSRAM | DSP | Fmax |
|---|---|---|---|---|---|---|
| F2 echo | UART in/out + buffer, no FFT | 318 (2 %) | 229 | 2 | 0 | 147.6 MHz |
| F3 FFT | + Gowin FFT core + its control + total cycle counter | 1,426 (7 %) | 480 | 8 | 2 | 80.6 MHz |
| **F3 + time split (current)** | + 5 phase-stamp counters and a longer reply header | **1,612 (8 %)** | **649** | **8** | **2** | **94.1 MHz** |

- The **FFT core itself** accounts for about 913 logic cells, 211 registers, 6 BSRAM and 2 DSP
  (the generator's own synthesis report). Everything else is our UART, buffer and measuring.
- The **time split** costs +186 logic and +169 registers: five 32-bit counters plus the header
  multiplexer. No extra memory or multipliers.
- Fmax changes between builds (80.6 → 94.1 MHz) because the placer arranges each build
  differently. Both are far above the 27 MHz used, so timing is never a concern here.

**Why the IDE may show 1,600 instead of 1,612.** Gowin IDE has two resource reports, and they
come from two different steps of the same build:

| Report (in the IDE's Process panel) | Step | Logic | Registers | Max clock |
|---|---|---|---|---|
| *Synthesize → Synthesis Report* | ① turns the Verilog into a list of building blocks: an **estimate** | 1,600 (1,355 LUT + 245 ALU) | 649 | 106.9 MHz (guessed wire delays) |
| *Place & Route → Place & Route Report* | ② puts every block on a real spot of the chip and wires it: the **final** count | **1,612** (1,349 LUT + 263 ALU) | 649 (2 moved into the I/O pins) | **94.1 MHz** (real wire delays) |

Like a shopping list (synthesis) versus what was actually used to build the house (place &
route): a few small logic cells get folded together (−6 LUT, partly the 12 inverters synthesis
counts as LUTs), and a few ALU cells are added when adder chains are fitted onto the chip (+18).
**This report always uses the place & route numbers.** The same lesson as on the 4K: synthesis
said "6 BSRAM, fine", and only place & route found that the chip lacks that memory type.

**Three-way comparison:**

| | Gowin FPGA (20K, 27 MHz) | ESP32-S3 SIMD | ESP32-S3 plain C |
|---|---|---|---|
| Correct (4 LSB gate), N = 1024 | **7 / 8** (fails full scale) | 8 / 8 | 8 / 8 |
| RMS error on noise | **2.18 LSB** | 1.82 LSB | 0.455 LSB |
| Time per 1024-point FFT | **266.3 µs** | 184.2 µs | 1,148.9 µs |
| …of which computing | **190.4 µs** | 65.1 µs | 1,029.9 µs |
| Clock cycles per FFT | **7,190** | 44,199 | 275,734 |
| Needs a CPU while running? | No | Yes | Yes |
| Resources | 1,612 logic (8 %), 649 registers, 8 BSRAM, 2 DSP (incl. measuring) | RAM + CPU time | RAM + CPU time |

## 5B. Interpretation

**H1: partly confirmed.** For ordinary signals the Gowin core is a correct FFT, with peaks in the
right bins and errors of about 2 LSB: a little worse than the ESP32's SIMD version and about 5×
worse than plain C. Impulse and DC came out almost perfect (0.001 and 0.000 LSB).

**But the core breaks at full scale.** Inside the core, values are halved and rounded at each
of the 10 stages. The rounding leans slightly towards negative numbers. When a value stays near
−32768, the lowest number 16 bits can hold, through many stages, the rounding pushes it past the
edge and it **wraps around** to a large positive number, like a car odometer rolling over from
99999 to 00000. The core does not **saturate** (stop at the limit), so one wrapped value spoils
the whole spectrum. Both ESP32 versions handled the same signal correctly. *(The cause is
inferred from the measurements above; the core is encrypted, so its arithmetic can't be read.)*
**Practical rule: keep the Gowin core's input below about ±32,700, or leave one bit of headroom
(±16,384).** Gowin's manual doesn't mention this limit. What it means for the real microphone:
§9.

**H4: partly confirmed.** Counted in clock cycles, the FPGA is 6× more efficient than the fast
ESP32 version and 38× more than plain C. But the FPGA clock (27 MHz) is 9× slower than the
ESP32's (240 MHz), so **in time** the ESP32 SIMD version still finishes first (184 vs 266 µs).
The FPGA's real advantage here is that it uses **no CPU**: the ESP32 can do other work while the
FPGA computes.

**Ease of use (for the comparison with Intel):**

| Observation | Why it matters |
|---|---|
| The IP generator offered block RAM for the 4K's chip, with no warning | The failure only showed up at the last build step (place & route) |
| The generator's own resource check said "6 BSRAM", which looked fine | It counts blocks but doesn't check that the chip has that block **type** |
| "Low Resource" and "High Performance" produced identical netlists | The option appears to do nothing for this configuration |
| The core is encrypted | Its source can't be read. But the generator also writes an **unencrypted gate-level model** (`fft_1024.vo`) that lists every building block, including the 4 dual-port memories, and it can be **simulated with free tools** (§10). Gowin's documentation doesn't point this out |
| Generating the core is instant; retargeting to a new chip = change the project's device, regenerate | Settings carried over unchanged (checked) |
| Synthesis of the vendor's own core gives 5 warnings, all inside Gowin's `fft.v` | Harmless here, but a user can't tell that without trying it |
| The IDE ships only a one-page help; the real manual (IPUG503) is on Gowin's website, and the first link tried was broken (403) | Found via the FFT product page |
| The manual's text is vague ("after several cycles…"); only the timing diagram (Figure 6-1) is exact | The core worked first time when driven exactly as the diagram shows |
| **The full-scale limit is not documented** | Found only because the test includes a full-scale signal |

---

## 6. Problems and what they taught us

**1. The test tones flattered some designs.** The first version put tones on bins that scaled
with N. Tones on even-numbered bins scored 92 dB, while bin 37 scored 59 dB **in the same
correct model**. An even-bin tone divides so neatly through the butterflies that almost nothing
needs rounding, so the score reflected luck in the internal layout, not accuracy. **Fix:** all
tones on odd bins.

**2. The original pass rule would have failed correct designs.** The plan said "within 3 dB of
the ideal 16-bit FFT". To test the rule itself, other correct designs and deliberate bugs were
modelled:

| Design | RMS error |
|---|---|
| Best possible (rounds once per butterfly) | 0.43 LSB |
| Rounds twice per butterfly (common, correct) | 0.73 LSB, **failed the 3 dB rule** |
| Truncates instead of rounding (correct) | 1.32 LSB |
| Output in the wrong order (bug) | 575 LSB |
| Forgot to halve one stage (bug) | 417 LSB |
| Inverse instead of forward (bug) | 604 LSB |
| One bin missing (bug) | 7.1 LSB |

**Lesson:** "correct" and "how accurate" are two different questions. Correctness became a
pass/fail gate; accuracy became a number compared between devices. The self-test now re-proves,
on every run, that the gate passes every correct design and fails every bug.

**3. The gate had to move after the first real device.** The gate was first set at 2 LSB, based
on the modelled designs. The ESP32 SIMD version, which is correct, landed at 1.8–2.0 LSB and
crossed 2.0 once, by 0.003. The gate was raised to **4 LSB**: twice the worst real correct
result, still below the smallest bug (7.1 LSB). Because this was decided **after** seeing data,
both verdicts are kept in the record (2 LSB: 39/40; 4 LSB: 40/40). The Gowin core will be judged
by 4 LSB, which was fixed **before** it is tested.

**4. A web search claimed the Tang Nano 4K supports dual-port RAM.** The search summary repeated
the datasheet's family-wide headline ("Supports Dual Port mode") and missed the footnote that
excludes this exact chip. **Lesson:** check the primary source, and check the footnotes.

## 7. Next week

- [x] Receive the Tang Nano 20K; regenerate the FFT core for the GW2AR-18C (instant; settings carried over)
- [x] F2: wire ESP32 ↔ FPGA (GPIO17 → pin 27, GPIO18 ← pin 28, GND), echo test: 650/650 frames, 0 byte errors
- [x] F3: all test signals through the Gowin FFT: 7/8 correct (fails at full scale), 7,190 cycles = 266 µs at 27 MHz
- [x] Fill in Part B of this report and the three-way comparison table
- [ ] *(proposed)* Make the full-scale headroom probe a permanent test, so the Intel core gets the same test
- [x] Time split on both devices (§8): FPGA load / compute / unload = 1,024 / 5,141 / 1,024 cycles; ESP32 copy / FFT / bit-reverse
- [x] Microphone input levels vs the FFT's limit (§9): full scale = 120 dB SPL; normal sounds ≤ 10 %
- [ ] *(decide)* Clamp the FPGA's FFT input to ±32,700 as insurance against an overloaded microphone
- [x] Free simulation of the Gowin core (§10): Icarus + gate-level model reproduces the board exactly
- [x] Bit-for-bit check `sim --board`: simulation = board on all 9 signals × 1,024 bins
- [ ] *(optional)* Use the simulation to watch the full-scale wrap inside the core
- [x] HDMI demo H1 (720p colour pattern) and H2 (test-tone spectrum) on the monitor (§13)
- [ ] HDMI demo H3: fix the microphone connection (it scrambles even on the ESP32), then test
      the direct and the ESP32-relayed microphone on the monitor
- [ ] HDMI demo H4: gridline labels (kHz, dB), peak readout, gain/source shown on screen
- [ ] DE0-Nano: the Intel FFT IP with identical settings and the same tests

---

## 8. How the time was measured (the time split)

**Why split the time?** "266 µs" or "184 µs" alone doesn't say *where* the time goes. Each
device's FFT is really a few steps in a row, so each step is timed separately. That shows which
step dominates, and lets the devices be compared step for step.

**The tool for both devices is a cycle counter**: a counter that adds 1 on every clock tick.
Read it before and after a step; the difference is how many clock cycles the step took.
Dividing by the clock frequency gives the time: cycles ÷ MHz = µs.

### 8.1 FPGA: four phases, marked by the core's own signals

The Gowin core announces each phase on its output wires (Gowin manual IPUG503, Figure 6-1).
The FPGA design (`fpga_fft/src/top.v`) runs one counter from the moment it pulses `start`, and
**writes down the counter's value** the first time each signal goes high:

```
counter   0  1                1024 1025              6165 6166               7189
start     ▔▔____________________________________________________________________
sod       ___▔▔_________________________________________________________________  first sample
ipd       ___▔▔▔▔▔▔▔▔▔▔▔▔▔▔▔▔▔▔▔▔▔______________________________________________  taking samples (1 per clock)
eod       ______________________▔▔______________________________________________  last sample
busy      _________________________▔▔▔▔▔▔▔▔▔▔▔▔▔▔▔▔▔▔▔▔▔▔_______________________  computing
soud      ________________________________________________▔▔____________________  first result
opd       ________________________________________________▔▔▔▔▔▔▔▔▔▔▔▔▔▔▔▔▔▔▔▔▔_  results out (1 per clock)
eoud      ___________________________________________________________________▔▔_  last result
phase        ◀─────load 1,024────▶ ◀───compute 5,141────▶ ◀────unload 1,024───▶
```

| Phase | What happens | From → to | Formula | Cycles | Time (27 MHz) | Share |
|---|---|---|---|---|---|---|
| 1 Setup | Core reacts to `start` (counter 0, before the first sample) | `start` → before `sod` | sod | 1 | 0.04 µs | 0 % |
| 2 Load | Core takes the 1,024 samples, **one per clock** | `sod` → `eod` | eod − sod + 1 | **1,024** | 37.9 µs | 14.2 % |
| 3 Compute | 10 stages of butterflies | after `eod` → before `soud` | soud − eod − 1 | **5,141** | 190.4 µs | 71.5 % |
| 4 Unload | Core hands out the 1,024 results in natural order, **one per clock** | `soud` → `eoud` | total − soud | **1,024** | 37.9 µs | 14.2 % |
| **Total** | | `start` → last result | | **7,190** | **266.3 µs** | |

The four phases add up to the total exactly, by construction. As a cross-check, the core's
`busy` signal is high for 5,140 cycles (from 1,025 to 6,165), which matches the compute phase.
All 9 test signals gave exactly the same numbers: the core's timing doesn't depend on the data.

**What the numbers mean:**
- A 1024-point FFT has 10 stages × 512 butterflies = **5,120 butterflies**. The compute phase
  takes 5,141 cycles, so the core does **one butterfly per clock**, plus about 21 cycles to fill
  its pipeline. Its 2 DSP multipliers do one complex multiply per clock.
- Loading and unloading are fixed at one sample per clock: 2,048 of the 7,190 cycles (28 %) are
  just moving data in and out.
- The time is set by the clock: at 27 MHz each cycle is 37 ns. The same design would be ~3×
  faster with a faster clock (it passes timing up to 80–94 MHz), but that needs a PLL; not tested.
- For audio: at the INMP441's top rate (46.875 kHz), 1,024 new samples arrive every 21.8 ms.
  One FFT takes 0.27 ms, so the core would be busy about **1.2 %** of the time.

**Cost of measuring:** the stamp counters add 186 logic cells and 169 registers to the design
(1,426 → 1,612 logic, 480 → 649 registers). They only watch the core; the FFT results are
identical to the build without them.

### 8.2 ESP32-S3: three steps, timed with the CPU cycle counter

The CPU has a built-in cycle counter (`esp_cpu_get_cycle_count()`, 240 per µs). The firmware
(`firmware/fft_bench`) reads it between the steps of one run:

```
 c0 ──[ 1 copy input ]── c1 ──[ 2 FFT butterflies ]── c2 ──[ 3 bit-reverse ]── c3
       memcpy 4,096 bytes      10 stages, in place          reorder to natural order
```

| Step | What happens | Why it's needed |
|---|---|---|
| 1 Copy input | Copy the 1,024 samples into the work buffer | The FFT overwrites its input ("in place"), so every run needs a fresh copy. This matches the FPGA's *load* phase |
| 2 FFT | The 10 stages of butterflies (SIMD or plain C) | The actual computation. Matches the FPGA's *compute* phase |
| 3 Bit-reverse | Swap results into natural order (bin 0, 1, 2, …) | ESP-DSP leaves results in "bit-reversed" order (bin 0, 512, 256, 768, …). The FPGA hands out natural order directly, so the ESP32 needs this step to produce the same answer. Matches the FPGA's *unload* phase |

**How it's made reliable:** each run is repeated **20 times**, and the **fastest** time of each
step is reported. A slower run means an interrupt (e.g. USB or Wi-Fi housekeeping) paused the
CPU in the middle; the fastest run is the one nothing interrupted. As a cross-check, the whole
run (c0 → c3) is also timed in one piece: it equals the sum of the three steps within 0.1 %.

**Results, N = 1024 (240 MHz):**

| Step | SIMD cycles | SIMD time | Share | Plain C cycles | Plain C time | Share |
|---|---|---|---|---|---|---|
| 1 Copy input | 2,596 | 10.8 µs | 5.9 % | 2,596 | 10.8 µs | 0.9 % |
| 2 FFT | 15,631 | 65.1 µs | 35.4 % | 247,166 | 1,029.9 µs | 89.6 % |
| 3 Bit-reverse | 25,972 | **108.2 µs** | **58.8 %** | 25,972 | 108.2 µs | 9.4 % |
| **Total** | **44,199** | **184.2 µs** | | **275,734** | **1,148.9 µs** | |

**What the numbers mean:**
- **SIMD:** 15,631 cycles ÷ 5,120 butterflies = about **3 cycles per butterfly**, thanks to 8
  numbers per instruction. The FFT is so fast that **reordering the output takes longer than
  computing it**. The reorder used here is ESP-DSP's plain-C version: its fast one isn't
  available for this data type on the S3.
- **Plain C:** about **48 cycles per butterfly**; the FFT is 90 % of the time.
- Copy and bit-reverse are identical in both versions (same code); only step 2 differs.

### 8.3 Step-by-step comparison (N = 1024)

| Matching step | Gowin FPGA (27 MHz) | ESP32 SIMD (240 MHz) | ESP32 plain C (240 MHz) |
|---|---|---|---|
| Get the input in | load: 1,024 cyc = 37.9 µs | copy: 2,596 cyc = 10.8 µs | copy: 2,596 cyc = 10.8 µs |
| **Compute the FFT** | **5,141 cyc = 190.4 µs** | **15,631 cyc = 65.1 µs** | **247,166 cyc = 1,029.9 µs** |
| Results in natural order | unload: 1,024 cyc = 37.9 µs | bit-reverse: 25,972 cyc = 108.2 µs | bit-reverse: 25,972 cyc = 108.2 µs |
| **Total** | **7,190 cyc = 266.3 µs** | **44,199 cyc = 184.2 µs** | **275,734 cyc = 1,148.9 µs** |
| Cycles per butterfly | **~1** | ~3 | ~48 |

**In one sentence:** the FPGA does the most work per clock tick (one butterfly per cycle, and
the reorder comes for free), but its clock is 9× slower, so the ESP32's SIMD version still
finishes first, while the FPGA leaves the CPU completely free.

**To reproduce:**

```bash
fpga_fft/build.sh program                     # FPGA design with phase stamps
python host/fft_bench.py fpga                 # FPGA: correctness + time split
python host/fft_bench.py esp32                # ESP32 SIMD: correctness + time split
python host/fft_bench.py esp32 --impl ansi    # ESP32 plain C
```

---

## 9. Microphone input levels: can the real microphone hit the FFT's limit?

The Gowin core fails only when its input is within a hair of full scale (§4B). The audio project
feeds it from an INMP441 microphone, so the question is: **how big are the numbers the
microphone actually produces?**

### 9.1 Two different "rulers" for loudness

| Ruler | Measures | Where 0 is |
|---|---|---|
| **dB SPL** (sound pressure level) | How loud a sound is **in the air** | 0 = the quietest sound a human can hear |
| **dBFS** (decibels relative to full scale) | How big the **number** coming out of the microphone is | 0 = the **biggest number possible**; everything else is negative ("below full") |

Think of the microphone's output as a **glass of water**. Full scale is the glass filled to the
top: in our 16-bit samples, the number **32,767**. 0 dBFS = full, −6 dBFS ≈ half full,
−20 dBFS = one tenth full.

### 9.2 The datasheet links the two rulers

The INMP441 datasheet gives one calibration point:

> **Sensitivity: a 94 dB SPL tone at 1 kHz gives −26 dBFS** (min −29, typ −26, max −23).
> "0 dBFS" means a sine whose **peak** just touches full scale.

The datasheet's own example: 94 dB SPL gives a 24-bit peak of 420,426. Our FPGA keeps the top 16
of the 24 bits (divide by 256), so **94 dB SPL → peak 1,642** in our samples (5 % of full scale).

| Other datasheet values | |
|---|---|
| Maximum acoustic input | 120 dB SPL |
| Noise floor | −87 dBFS (≈ 1.5 in our 16-bit samples) |
| Dynamic range | 87 dB |
| Output | 24-bit, two's complement |

### 9.3 One rule to move up or down

- **+6 dB ≈ ×2** (twice as big a number), **+20 dB = ×10**.
- Starting from 94 dB → 1,642, every other level follows. Formula: peak = 32,767 × 10^((SPL − 120) / 20).

```
 sound level      sample peak      how full the "glass" is
   120 dB   ──▶   32,767   ████████████████████  100 %  ← full: the microphone's maximum
   114 dB   ──▶   16,400   ██████████             50 %
   100 dB   ──▶    3,300   ██                     10 %  shouting right at the microphone
    94 dB   ──▶    1,642   █                       5 %  ← the datasheet's calibration point
    80 dB   ──▶      330                           1 %  loud voice, close
    60 dB   ──▶       33                         0.1 %  normal conversation
    40 dB   ──▶        3                        0.01 %  quiet room
```

*(Sound examples are typical values, for orientation.)* The key fact: 120 − 94 = 26 dB, which
exactly cancels the −26 dBFS sensitivity, so **the microphone reaches full scale at 120 dB SPL**,
its own maximum and about the loudest sound a human ear can stand. Microphones vary by ±3 dB: a
"hot" unit (−23 dBFS) is full at 117 dB SPL.

### 9.4 What it means for the FPGA

| | Sample value | Sound level |
|---|---|---|
| Gowin core starts failing | above ±32,748 | ≈ 120 dB SPL (the glass completely full) |
| Loudest normal sound (shouting right at the microphone) | ~3,300 | ~100 dB SPL |
| Normal conversation | ~33 | ~60 dB SPL |

- **In normal use the FFT never gets near its limit.** Normal sounds use 10 % or less of the
  range, about 20 dB (10×) below the failure zone.
- **Only an overloaded microphone can reach it**: tapping or knocking on it, blowing into it, or a
  very loud bang right next to it. Then the Gowin FFT would output garbage instead of a clipped
  but sensible spectrum.
- **Cheap insurance (open decision):** clamp the FFT's input to ±32,700 in the FPGA. It changes
  nothing below about 119.98 dB SPL (where the microphone already distorts), costs only a few
  logic cells, and makes the failure impossible.

---

## 10. Simulating the Gowin core with free tools

### 10.1 What simulation is, and why it matters here

**Simulation** runs the hardware design **on the computer instead of on the FPGA**. A
*testbench* (a small Verilog program) feeds the design inputs, here our test signals, and every
internal wire can be watched on every clock tick. On the board we only see what comes out; in
simulation we can see *inside*, for example where the full-scale signal goes wrong.

### 10.2 Why Gowin's own tools can't do it

| Reason | Detail |
|---|---|
| **Gowin's IDE has no simulator** | Its tools are synthesis, place & route, the programmer, the floorplanner and an on-chip logic analyser (GAO, which needs the board). There is no program for running a design on the computer. Gowin ships *simulation libraries* (`IDE/simlib/`) meant for other companies' simulators |
| **Those simulators are commercial** | Professional simulators (e.g. ModelSim/Questa) are paid products, and not made for macOS |
| **The core's main file is encrypted** | `fft_1024.v` is protected with the standard Verilog encryption (15 `protect` blocks). Only a tool holding Gowin's key can read it: Gowin's own synthesizer, or a commercial simulator Gowin has given the key to. **Free simulators cannot read it** |

### 10.3 What was used before, and what is used now

| | Before: the audio design (M1–M3) | Now: the Gowin FFT core |
|---|---|---|
| Simulator | **Icarus Verilog** (free, open source) + `vvp` | **Icarus Verilog** (the same) |
| What was simulated | Our **own** Verilog: `sample_gen`, `framer`, the whole I2S → UART chain, with a microphone model | Gowin's FFT core, using its **gate-level model** `fft_1024.vo` |
| Testbenches | `fpga/sim/tb_gen.v`, `tb_framer.v`, `tb_chain.v` (run with `fpga/sim/run_sims.sh`) | `fpga_fft/sim/tb_fft.v` (run with `python host/fft_bench.py sim`) |
| Why it was possible | All the code was ours and readable | The `.vo` file is **not encrypted**, and Gowin's primitive library is readable too |

### 10.4 How it works

The IP generator writes two versions of the core:

| File | What it is | Encrypted? | Used for |
|---|---|---|---|
| `fft_1024.v` | The core for Gowin's synthesizer | **Yes** | Building the FPGA design |
| `fft_1024.vo` | "Post-PnR Verilog Simulation Model": the finished core as ~1,100 chip building blocks wired together (342 LUT3, 207 LUT2, 174 LUT4, 184 ALU, 211 flip-flops, 4 DPB, 2 pROM, 2 MULTADDALU18X18) | **No** | Simulation |

The `.vo` only says "a LUT4 here, a dual-port RAM there". How each block *behaves* is described
in Gowin's library `prim_sim.v` (16,770 lines, also unencrypted). Together:

```
 tb_fft.v (our testbench) + fft_1024.vo (the core, gate by gate) + prim_sim.v (how each gate behaves)
        └────────────────────────────── iverilog ──────────────────────────────┘
                                          │
                                     vvp (runs it)  ──▶  1,024 results + phase stamps
```

The testbench drives the core exactly as Gowin's manual describes (while `ipd` is high, supply
sample `idx`), independently of our FPGA design `top.v`, and writes down the same phase stamps
the board measures.

**Three things had to be solved** (worth knowing for anyone repeating this):

1. **Gowin's flip-flops look for a chip-wide "global set/reset" block called `GSR`.** On the chip
   it exists automatically; in simulation the testbench must contain one: `GSR GSR(.GSRI(1'b1));`.
2. **Icarus must be told which module is the top** (`-s tb_fft`). Otherwise it tries to build
   every unused block in the library on its own, and those fail.
3. **A race in the first testbench:** `start` changed on the same clock edge on which it was
   read, so the bookkeeping missed it. Fixed by changing inputs just after the rising edge, as a
   real flip-flop would.

### 10.5 Result: the simulation behaves exactly like the board

| | Board (Tang Nano 20K) | Simulation (Icarus) |
|---|---|---|
| Phase stamps sod / eod / busy↑ / busy↓ / soud / last result | 1 / 1024 / 1025 / 6165 / 6166 / 7189 | **1 / 1024 / 1025 / 6165 / 6166 / 7189** |
| Total cycles | 7,190 | **7,190** |
| RMS error, all 9 signals | e.g. noise 2.1835, tone 2.3299, full scale 1023.778 | **identical on all 9, to 4 decimals** (incl. max error) |
| Full-scale signal | WRONG | **WRONG, in exactly the same way** |
| **Every output, bit for bit** (9 signals × 1,024 bins, real and imaginary) | — | **identical: 9 / 9 signals, 0 bins differ** |
| Time per FFT | 266 µs | ~2.5 s of computer time |

`fft_bench.py sim --board` sends each signal through both the simulation and the real FPGA and
compares the 1,024 results number by number: **all 9 signals came out identical, bit for bit**.
(It ran after the jumper wires, which had been disconnected overnight, were reconnected.) So
the simulation is a faithful copy of the hardware, including its full-scale failure.

**What this means:**
- **For the ease-of-use comparison:** the Gowin core **can** be simulated with free tools, even
  though its main file is encrypted. But Gowin doesn't document this path, and it needed the
  three fixes above.
- **For this project:** changes can be tried in seconds without the board, and the full-scale
  failure can now be traced *inside* the core, to confirm the cause that §5B could only infer.

```bash
python host/fft_bench.py sim            # simulate all test signals, score them
python host/fft_bench.py sim --board    # ... and compare every output bit with the real FPGA
```

---

## 11. Understanding the results: complex bins, bit reversal, and what the error looks like

*Figures are drawn from real device outputs saved in `data/fft/spectra-1024.csv`
(`python host/plot_fft_report.py --fetch` pulls fresh data and redraws everything).*

### 11.1 How one result is stored: two 16-bit numbers make one complex bin

**Each bin is TWO 16-bit numbers, not one number split in half.** One holds the *real* part,
the other the *imaginary* part:

```
 1 bin  = re (16 bits) + im (16 bits) = 32 bits = 4 bytes
 1024 bins = 2048 numbers = 4096 bytes
```

How each device delivers them:

| | ESP32-S3 (ESP-DSP) | Gowin core |
|---|---|---|
| Where | One array in memory, overwriting the input | Two separate 16-bit buses, `xk_re` and `xk_im`, both valid in the same clock |
| Layout | `re0, im0, re1, im1, re2, im2, …` | One bin per clock; `idx` says which bin |
| What our design does | Sends the array as is | Packs each bin as one 32-bit word `{im, re}` into block RAM at address `idx`, then sends it in the ESP32's layout |

So both reach the Mac in the same bytes. Example: bin 100 of the Gowin result, re = −450,
im = 160:

```
 re = −450 → 16-bit two's complement 0xFE3E → sent low byte first:  3E FE
 im =  160 → 0x00A0                         → sent low byte first:  A0 00
 on the wire:  3E FE A0 00
```

*Two's complement* is how a 16-bit number stores negatives: a raw value above 32767 means
"subtract 65536". Raw 0xFE3E = 65,086, so 65,086 − 65,536 = **−450**.

**What re and im mean.** For one frequency, `re` says how much the signal looks like a
**cosine** at that frequency and `im` how much it looks like a **sine**. Drawn as an arrow, the
two numbers give the two things you usually want:

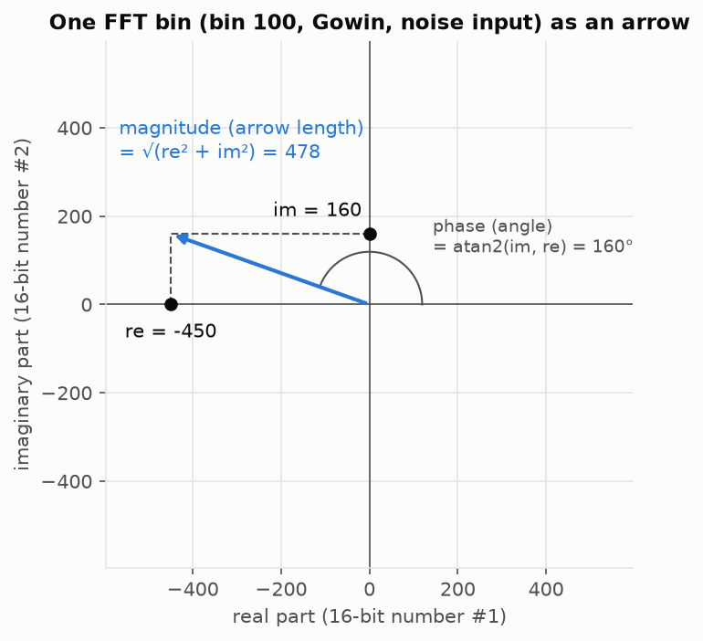
[picture p2: docs/figures/fft/complex_bin.png]
One bin as an arrow: real part, imaginary part, magnitude, phase


**Converting a bin into useful numbers:**

| You want | Formula | Bin 100 above | Tone example (bin 37, input amplitude 16,384) |
|---|---|---|---|
| **Magnitude** (how strong) | √(re² + im²) | √(450² + 160²) = **478** | 8,192 |
| **Phase** (timing, angle) | atan2(im, re) | **160°** | ≈ 0° (a pure cosine) |
| **Level in dBFS** | 20 × log₁₀(magnitude ÷ 32,767) | −36.7 dBFS | −12.0 dBFS |
| **Amplitude of the real sine wave** | 2 × magnitude (real input splits its energy between bin k and its mirror N − k) | — | 2 × 8,192 = **16,384** ✓ |
| **Unscaled FFT value** | magnitude × 1024 (undo the ÷2 per stage) | 489,472 | 8,388,608 |

**Why real input still gives complex output, and why bin 987 appears.** Audio has only a real
part (im input = 0), but the *output* is still complex, because phase is part of the answer.
For a real input, the upper half of the spectrum mirrors the lower half: bin N − k mirrors bin k
(1024 − 37 = **987**). That's why the spectrum plots below only show bins 0–511.

### 11.2 Bit reversal on both devices

**Why the order gets scrambled.** A radix-2 FFT repeatedly splits the samples into even and odd
positions, like dealing cards into two piles, then each pile into two again. After 10 splits
the results sit in a fixed, scrambled order: **position p holds bin reverse_bits(p)**.

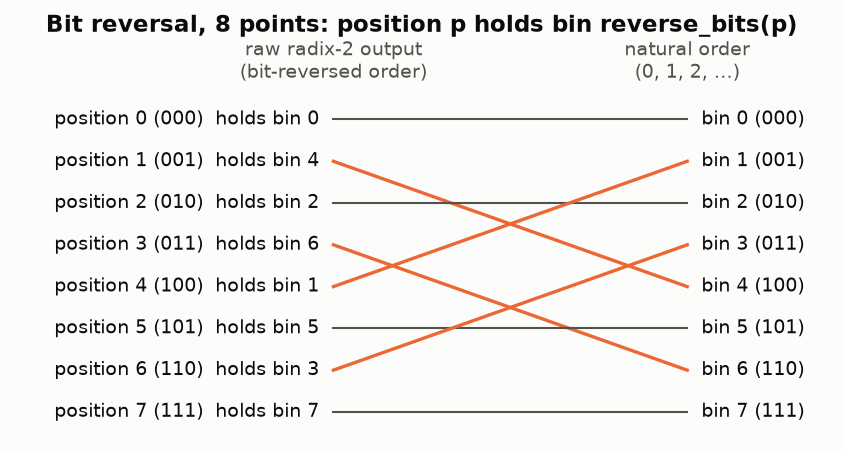
[picture p3: docs/figures/fft/bitrev_8.png]
8-point bit reversal map


**ESP32: a fixed rearrangement after the FFT.** ESP-DSP's FFT leaves the scrambled order in
memory. Here is our tone at bin 37 as the buffer looked *before* the bit-reverse step, and
after it:

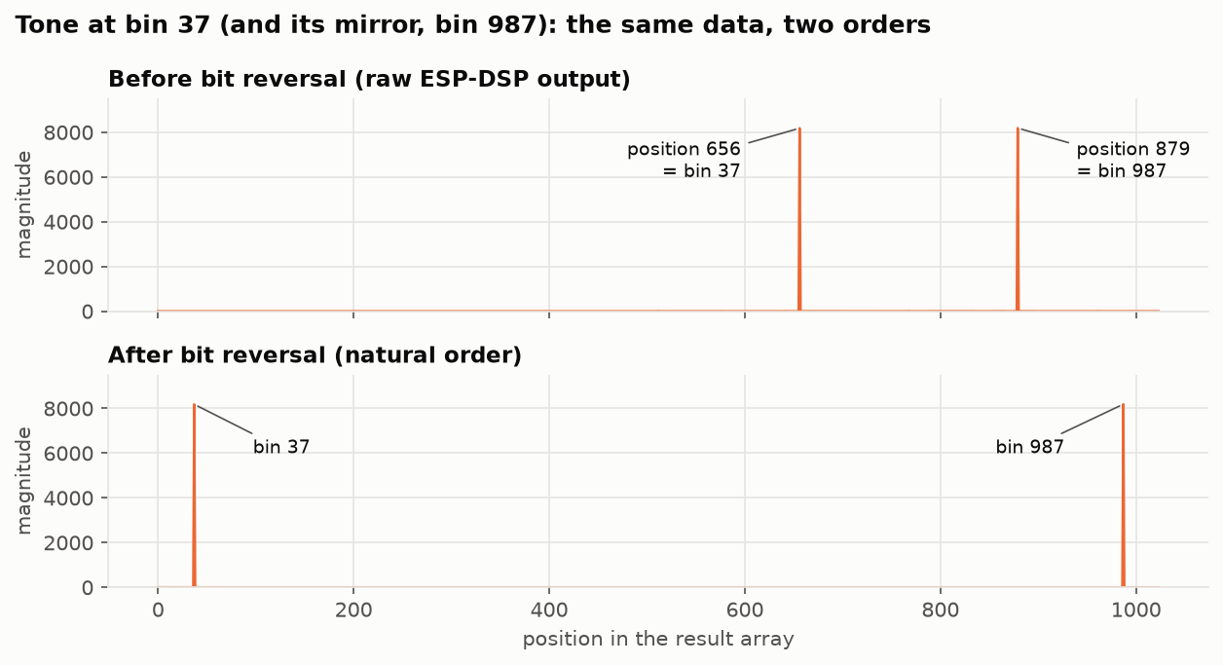
[picture p4: docs/figures/fft/bitrev_1024.png]
The ESP32's raw output vs natural order


*(The "before" panel is reconstructed by applying the same fixed rearrangement to the final
result. Bit reversal only moves values, so this is exact.)*

`dsps_bit_rev_sc16_ansi` is **not sorting**: sorting compares values to decide where they go.
Bit reversal never looks at the values. Every position already has a pre-assigned partner,
like a **fixed seating chart**:

```
 for every position p:  r = reverse_bits(p)
                        if p < r: swap bin p and bin r      (each pair swapped once)
```

For 1,024 points that's **496 swaps**. 32 positions read the same backwards (e.g. 0, 1023)
and stay put. Each swap moves 4 bytes twice in memory, plus computing the reversed index, so
the step costs **25,972 cycles = 108 µs**, more than the FFT itself.

**Gowin: the reordering is wiring, on the way in.** The core's netlist is encrypted, but its
gate-level model (`fft_1024.vo`) shows how the `idx` output is built:

| While the core is… | `idx` comes from | Wiring |
|---|---|---|
| **Loading** samples | the load-address counter `ld_xnm_ad`, bits **reversed** | idx bit 0 = address bit 9, bit 1 = bit 8, … bit 9 = bit 0 |
| **Unloading** results | the unload counter `ud_xk_id`, bits **straight** | idx bit k = counter bit k |

So: a **counter register** counts 0, 1, 2, … while the samples arrive, and its bits are
connected to the memory's address pins **in reverse order**. Sample n is stored at address
reverse_bits(n) the moment it arrives. The scrambling is done *before* the FFT, so the in-place
FFT finishes with the results already in natural order, and unloading just reads addresses 0,
1, 2, … straight.

```
 idx counter:   b9 b8 b7 b6 b5 b4 b3 b2 b1 b0
                 ╲  ╲  ╲  ╲  ╳  ╳  ╱  ╱  ╱  ╱      crossed wires, no logic
 RAM address:   b0 b1 b2 b3 b4 b5 b6 b7 b8 b9
```

Reversing bits in hardware is just **crossing wires**: no logic, no memory moves, no extra
clock cycles. That's why the time split shows loading and unloading at exactly 1,024 cycles
each.

| | ESP32 | Gowin |
|---|---|---|
| When it reorders | **After** the FFT, as a separate step | **Before** the FFT, while loading |
| How | The CPU swaps 496 pairs of values in memory | Address wires connected in reverse order |
| Cost | 108 µs (59 % of the SIMD total) | **0**: loading still takes exactly 1 clock per sample |
| Optional? | Yes: skip the call if natural order isn't needed | Yes: the generator offers natural or bit-reversed output |

### 11.3 What an error of "2 steps" looks like

**Real output values** (tone at bin 37, input amplitude 16,384; real part shown):

| Bin | **Exact** | Gowin | ESP32 SIMD | ESP32 plain C |
|---|---|---|---|---|
| 0 | 0.00 | −2 | −2 | 0 |
| 1 | 0.03 | −10 | −8 | 0 |
| 36 | 0.00 | −3 | 0 | 0 |
| **37** (the tone) | **8,192.03** | **8,196** (+0.05 %) | **8,182** (−0.12 %) | **8,190** |
| 38 | 0.00 | −3 | −1 | 0 |
| 100 | 0.00 | −2 | 0 | 0 |
| 500 | 0.00 | −2 | 0 | 0 |

The same spectrum as a plot. On a **linear** scale all four are identical. Only on a **dB**
scale do the errors appear, as a **floor** under the empty bins: about **−80 dBFS** for
Gowin, −80 to −95 dBFS for ESP32 SIMD (worst at low bins), and nothing for plain C, whose empty
bins are exactly 0, like the exact answer:

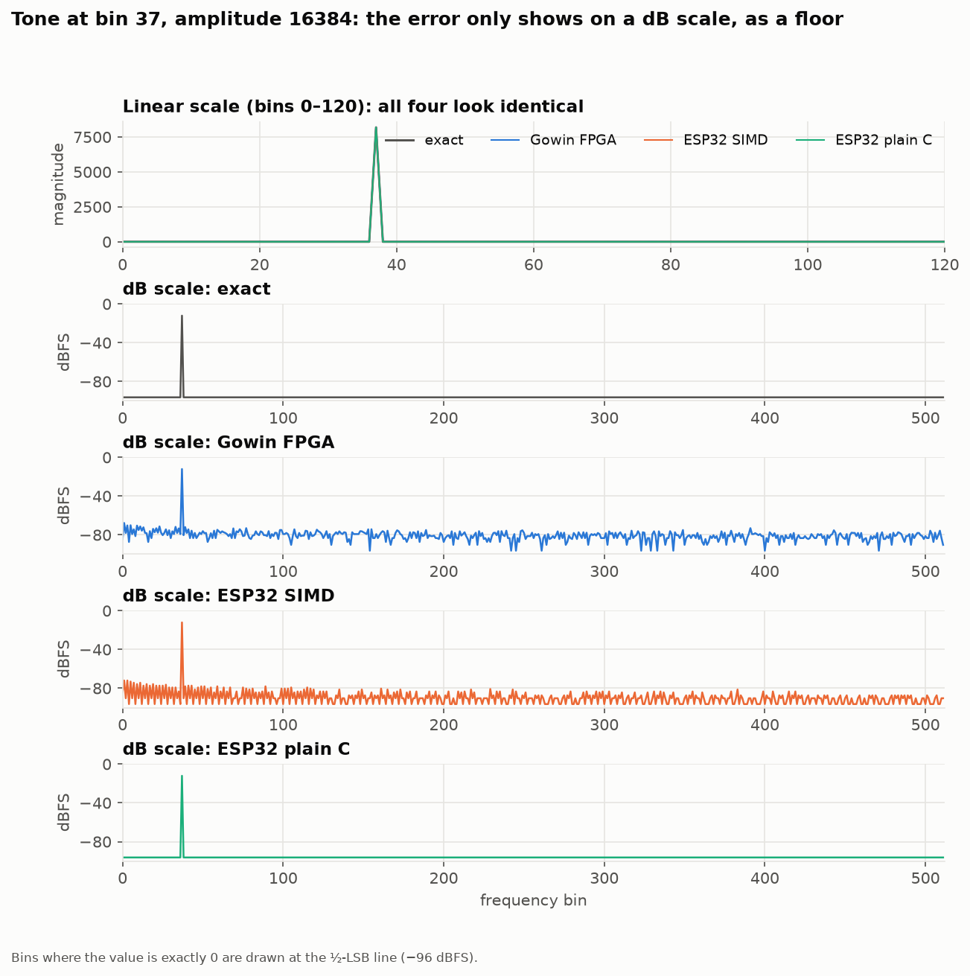
[picture p5: docs/figures/fft/tone_spectrum.png]
Tone spectrum, linear and dB, all devices


**Every bin gets its own error.** With the random test input, here is the error (device − exact)
of each bin:

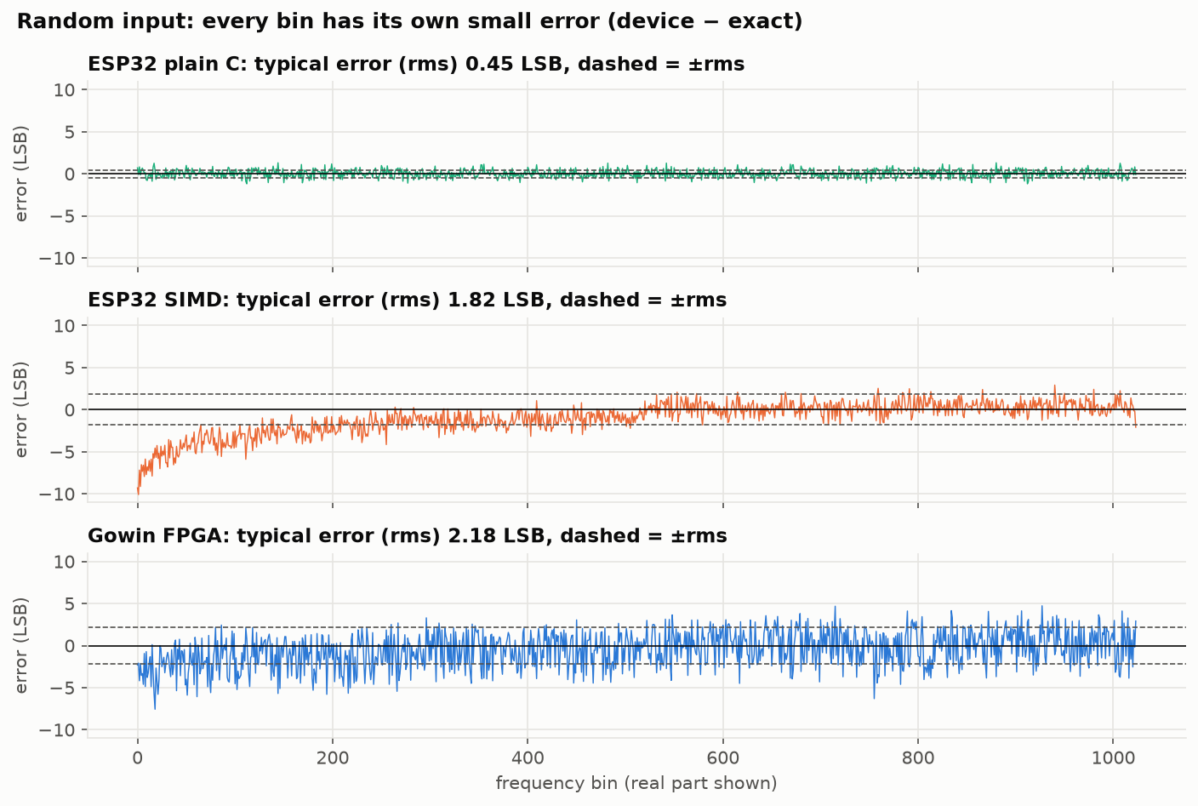
[picture p6: docs/figures/fft/error_per_bin.png]
Error of every bin, random input


- **ESP32 plain C:** a thin band within ±1. Pure rounding, as good as 16 bits allow.
- **ESP32 SIMD:** **not random.** About −10 at the lowest bins, climbing to about 0 at the
  highest. The error depends on frequency, a systematic effect of how its assembly code rounds.
- **Gowin:** mostly **random scatter** of about ±5, leaning slightly negative at low bins.

**How big the errors are.** All 2,048 output numbers (real and imaginary parts) per device:

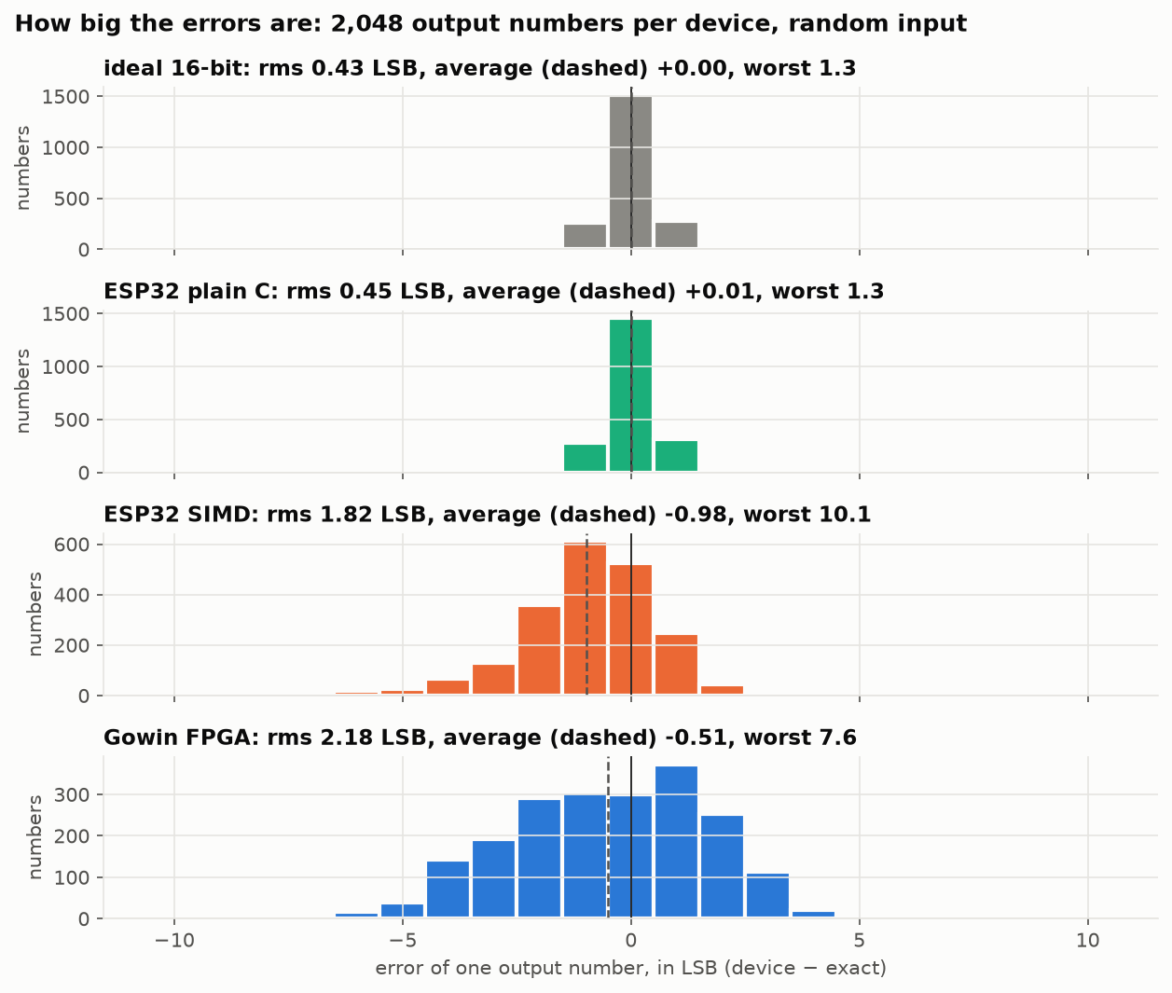
[picture p7: docs/figures/fft/error_histogram.png]
Histogram of errors per device


| Off by → | 0–1 | 1–2 | 2–4 | 4–8 | worst | **typical (rms)** |
|---|---|---|---|---|---|---|
| Best possible 16-bit | 99 % | 1 % | 0 % | 0 % | 1.3 | **0.43** |
| ESP32 plain C | 98 % | 2 % | 0 % | 0 % | 1.3 | **0.45** |
| ESP32 SIMD | 49 % | 30 % | 16 % | 4 % | 10.1 | **1.82** |
| Gowin | 31 % | 30 % | 33 % | 6 % | 7.6 | **2.18** |

**Is it a change in amplitude, or a swing?** Both, but **mostly swing**:

| Part of the error | Gowin | ESP32 SIMD | ESP32 C | Meaning |
|---|---|---|---|---|
| **Random scatter** | most of the 2.18 | part of the 1.82 | all of the 0.45 | each number jitters differently |
| **Amplitude (gain)** | +0.4 % too big | −0.13 % too small | −0.04 % | everything slightly scaled (≈ 0.04 dB) |
| **Offset (average)** | −0.5 | −1.0 | 0.0 | values lean negative (the dashed line in the histogram) |

The typical bin in the random test is about 590, so a 2-step error is **0.4 %** of a typical
value, and **0.05 %** of the 8,192 tone.

**In one picture:**

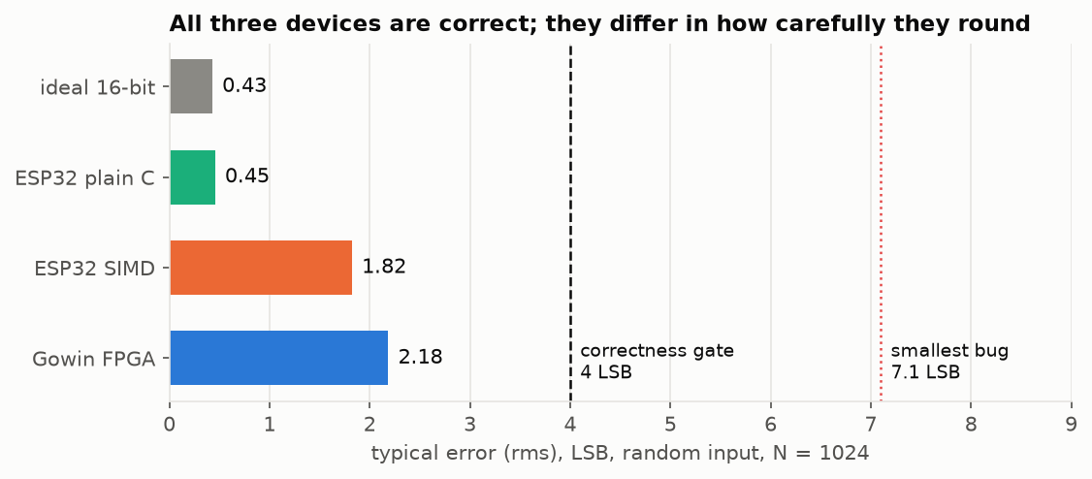
[picture p8: docs/figures/fft/rms_summary.png]
Summary of typical error per device


---

## 12. FPGA clock rate: 27, 54 and 81 MHz

**Question:** the FFT takes a fixed number of clock cycles. If the FPGA's clock is raised, does
the time drop in proportion, and does the core stay correct?

### 12.1 What changes, and what doesn't

Only the clock **inside** the FPGA changes. Every link to the outside runs at the same speed in
all three builds, so nothing else in the system is affected:

| Link | 27 MHz build | 54 MHz build | 81 MHz build |
|---|---|---|---|
| ESP32 ↔ FPGA UART | 1 Mbaud (27 clocks/bit) | 1 Mbaud (54 clocks/bit) | 1 Mbaud (81 clocks/bit) |
| Mac ↔ ESP32 | 2 Mbaud | 2 Mbaud | 2 Mbaud |
| ESP32 → FPGA → ESP32 round trip (measured) | 82.4 ms | 82.6 ms | 82.5 ms |

### 12.2 How the faster clocks are made: the PLL

The board has only a 27 MHz crystal. A **PLL** (phase-locked loop) is a block inside the FPGA
that multiplies a clock; the GW2AR-18C has two. Gowin's IP generator only fills in the
settings of its `rPLL` block, so the block is used directly (`fpga_fft/src/pll_clk.v`):

```
 27 MHz crystal ──▶ rPLL ──▶ 27 × MULT ──▶ the same FFT design (fft_link.v)
 (pin 4, a PLL      inside: a VCO at (27 × MULT) × ODIV, which must stay within 500–1250 MHz
  input pin)        LOCK = 1 once the output is stable; the design waits in reset until then
```

| Build | Top file | MULT | ODIV | VCO | Build command |
|---|---|---|---|---|---|
| 27 MHz | `top.v` | — (no PLL) | — | — | `fpga_fft/build.sh` |
| 54 MHz | `top_54.v` | 2 | 16 | 864 MHz | `MHZ=54 fpga_fft/build.sh` |
| 81 MHz | `top_81.v` | 3 | 8 | 648 MHz (16 would give 1296: too fast) | `MHZ=81 fpga_fft/build.sh` |

The FFT logic (`fft_link.v`) is identical in all three. It reports its own clock in every
reply, so the Mac always converts cycles to µs correctly.

### 12.3 Build results (place & route)

| | 27 MHz | 54 MHz | 81 MHz |
|---|---|---|---|
| Logic | 1,626 (8 %) | 1,619 (8 %) | 1,626 (8 %) |
| Registers | 651 | 654 | 656 |
| BSRAM / DSP | 8 / 2 | 8 / 2 | 8 / 2 |
| PLL | 0 of 2 | 1 of 2 | 1 of 2 |
| **Clock needed → highest it could run** | 27 → 91.5 MHz | 54 → 88.3 MHz | **81 → 93.6 MHz** |
| Timing violations | none | none | none |

**About the "highest it could run" (Fmax).** It's the timing tool's estimate of the fastest
clock *this particular build* would still work at. It isn't one fixed number for the chip: it
changes a little from build to build (88–94 MHz here), because the tool places the design
differently each time and works harder when it's asked for a faster clock. **81 MHz passed
comfortably, so the limit wasn't reached.** The next frequencies the PLL can make from 27 MHz
are 90 MHz (×10 ÷ 3) and 94.5 MHz (×7 ÷ 2). 94.5 MHz is above every build's estimate, so the
practical ceiling of this design on this chip is **about 90 MHz** (not tested).

*(The 27 MHz build is 14 logic cells bigger than in §4B because of the clock byte added to the
reply and a wider timeout counter.)*

### 12.4 Test results at all three clocks

| Test | 27 MHz | 54 MHz | 81 MHz |
|---|---|---|---|
| Echo (data path) | 650 / 650 | 650 / 650 | 650 / 650 |
| Correct signals (4 LSB gate) | 7 / 8 | 7 / 8 | 7 / 8 |
| RMS error on noise | 2.184 | 2.184 | 2.184 |
| Output vs the 27 MHz run | (reference) | **bit-identical** | **bit-identical** |
| Cycles per FFT | 7,190 | 7,190 | 7,190 |

**Time split (N = 1024):**

| Phase | Cycles | 27 MHz | 54 MHz | **81 MHz** |
|---|---|---|---|---|
| 1 Setup | 1 | 0.04 µs | 0.02 µs | 0.01 µs |
| 2 Load | 1,024 | 37.9 µs | 19.0 µs | **12.6 µs** |
| 3 Compute | 5,141 | 190.4 µs | 95.2 µs | **63.5 µs** |
| 4 Unload | 1,024 | 37.9 µs | 19.0 µs | **12.6 µs** |
| **Total** | **7,190** | **266.3 µs** | **133.1 µs** | **88.8 µs** |

Time = cycles ÷ clock: 7,190 ÷ 27 = 266.3 µs, ÷ 54 = 133.1 µs, ÷ 81 = 88.8 µs.
**Twice the clock = half the time, three times = a third**, with bit-identical results.

### 12.5 Speed per MHz: comparing devices fairly

A device's time depends on two things: **how many clock cycles** its FFT needs (set by the
design or the software) and **how fast its clock** ticks. Dividing out the clock gives a fair
comparison of the *designs* themselves:

| | Cycles per FFT | **FFTs per second, per MHz of clock** | Time at its clock |
|---|---|---|---|
| **Gowin FPGA** | **7,190** | **139** | 266.3 µs @ 27 · 133.1 µs @ 54 · **88.8 µs @ 81** |
| ESP32 SIMD | 44,199 | 22.6 | 184.2 µs @ 240 |
| ESP32 plain C | 275,734 | 3.6 | 1,148.9 µs @ 240 |

*(FFTs per second per MHz = 1,000,000 ÷ cycles.)* **Per MHz, the FPGA design does 6.1× more
work than the ESP32's SIMD FFT and 38× more than plain C.**

**The ESP32's clock can't be raised the way the FPGA's can:**

| | FPGA (Gowin GW2AR-18C) | ESP32-S3 |
|---|---|---|
| Who sets the clock | **The designer.** The PLL makes many frequencies from the crystal (27 × N ÷ M) | **The chip maker.** The CPU offers a few fixed steps: 80, 160 or 240 MHz |
| Highest | Whatever the design passes timing at: about 90 MHz for this design | **240 MHz**, fixed by the chip. The tests already run at the top step |
| To go faster | Raise the clock (up to the timing limit), or change the design to use more parallel hardware | Only better software, or a different chip |

So the FPGA's 88.8 µs at 81 MHz can't be matched by this ESP32: its SIMD FFT would need
44,199 cycles ÷ 88.8 µs ≈ **498 MHz**, more than twice its maximum. The other way round, the
FPGA already matches the ESP32 SIMD's 184 µs at just **39 MHz**.

**Updated ranking (1024-point FFT):**

| | Clock | Time | CPU busy? |
|---|---|---|---|
| **Gowin FPGA** | 81 MHz | **88.8 µs** | none |
| **Gowin FPGA** | 54 MHz | **133.1 µs** | none |
| ESP32 SIMD | 240 MHz (its maximum) | 184.2 µs | 100 % |
| Gowin FPGA | 27 MHz | 266.3 µs | none |
| ESP32 plain C | 240 MHz (its maximum) | 1,148.9 µs | 100 % |

**H4 ("the FPGA is faster and needs no CPU") is confirmed from 54 MHz upwards.** At 81 MHz the
FPGA is 2.1× faster than the ESP32's fastest FFT, and it leaves the CPU free.

```bash
MHZ=81 fpga_fft/build.sh program     # or MHZ=54, or no MHZ for 27
python host/fft_bench.py fpga        # -> data/fft/f3-fpga-gowin[-54mhz|-81mhz].csv
```

---

## 13. HDMI demo, step H1: a picture on the monitor

The advisor asked for a live demo: microphone → Tang Nano 20K → Gowin FFT → spectrum on a
monitor over HDMI (plan: `docs/plans/hdmi-demo.md`; details: `docs/12-hdmi-demo.md`). Step H1
proves the video output on its own, with a colour test pattern.

| | Result |
|---|---|
| Format | 1280×720 at 60 Hz (1650 × 750 slots incl. blanking → 74.25 MHz pixel clock) |
| Clocks | PLL 27 × 55 ÷ 4 = 371.25 MHz for the 4 serializers only; ÷5 = 74.25 MHz for everything else |
| IP cores generated | none: Gowin built-in blocks (rPLL, CLKDIV, OSER10, TLVDS_OBUF) used directly |
| Simulation | one frame decoded from the simulated serial bits: 20 / 20 checks, **0 of 921,600 pixels wrong** |
| Hardware | **picture exactly as designed; the monitor reports 1280×720 @ 60 Hz** |
| ESP32 benchmark in the same build | still passes |

**Step H2: a spectrum on the monitor.** A test tone generated inside the FPGA (sweeping 0 →
24 kHz, plus a fixed 1 kHz tone 40 dB quieter) goes through gain/clamp (both adjustable), a
Hann window, a second Gowin FFT core, power → dB → bar height, and onto the screen as 512
bars on a dB scale (0 dB = the largest possible bin value, at the top; −100 dB at the bottom).

| | Result |
|---|---|
| Timing | FFT 0.097 ms per 21.2 ms block (0.5 %); new bars swap in during blanking; no samples lost |
| Simulation | samples, window and bar heights bit-exact with Python models; every pixel of a frame correct |
| Build | 3,199 logic (16 %), 19 / 46 block RAM, 7 / 24 DSP; timing met |
| **Monitor** | **the tone sweeps across the screen as designed**; the FFT's noise floor is visible at about −80 dB |

**Step H3: the live microphone — in progress.** Two ways in were built and verified in
simulation; on the hardware the microphone's connection turned out to be unstable.

| Path | Built | Simulation | Hardware |
|---|---|---|---|
| INMP441 → FPGA directly (pins 25/26/29; 3.09 MHz bit clock, 48.3 kHz; gain picks 16 of the 24 bits, 0…+42 dB, button S2) | ✅ | 8 gains bit-exact incl. saturation; clocks exact | ❌ no data: the mic's data line never changed (diagnostic LEDs) |
| INMP441 → ESP32 → UART 2.97 Mbaud → FPGA (packets with checksum) | ✅ | 192/192 samples bit-exact at the ESP32's real baud; bad packets dropped | ⏳ link runs (1,500 packets/s), but the mic data arriving at the ESP32 is scrambled |

**Finding the cause** (diagnostic firmware `mic_test`, `mic_stream` on the ESP32): real sound
changes smoothly, so neighbouring samples correlate at about +0.9…1; scrambled data does not.

| Test | Result |
|---|---|
| Mic on the ESP32, after re-seating the wires | clean: 220 Hz and 1 kHz shown correctly in `inmp441_viewer.py` |
| Same mic, same firmware, later | scrambled again (correlation +0.36…+0.44), with or without the UART running |

So the microphone and both FPGA paths work; the connection to the microphone module comes and
goes (the INMP441 shuts down whenever its clock or power drops, then restarts). Next: solder
the module's header pins and use short wires, or try a second module, then repeat H3.
