karnza007/esp32_iot_gateway/docs/figures/h4_layout.png

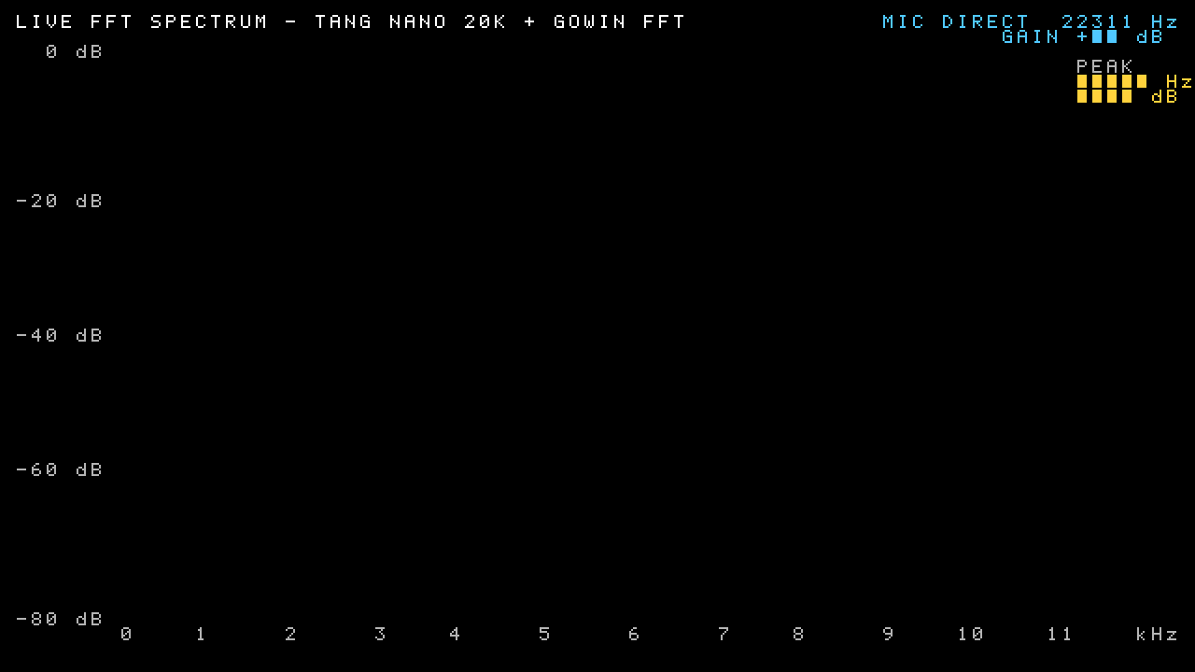
docs/figures/h4_layout.png
