karnza007/esp32_iot_gateway/docs/figures/h4_layout_spectrogram.png

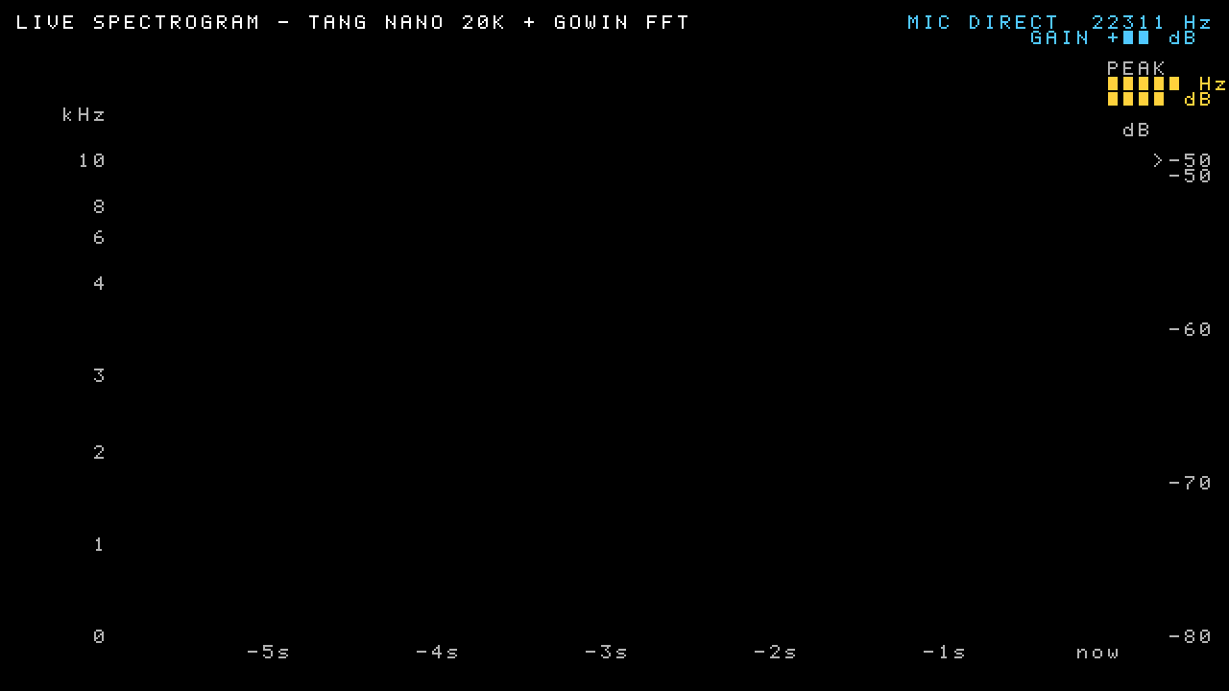
docs/figures/h4_layout_spectrogram.png
