karnza007/esp32_iot_gateway/docs/figures/h5_chain_sweep_sim.png

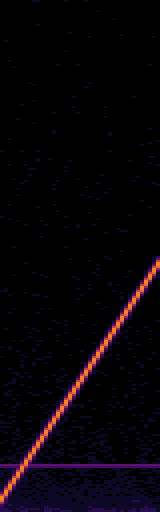
docs/figures/h5_chain_sweep_sim.png
