karnza007/esp32_iot_gateway/docs/figures/h6_colours_board.png

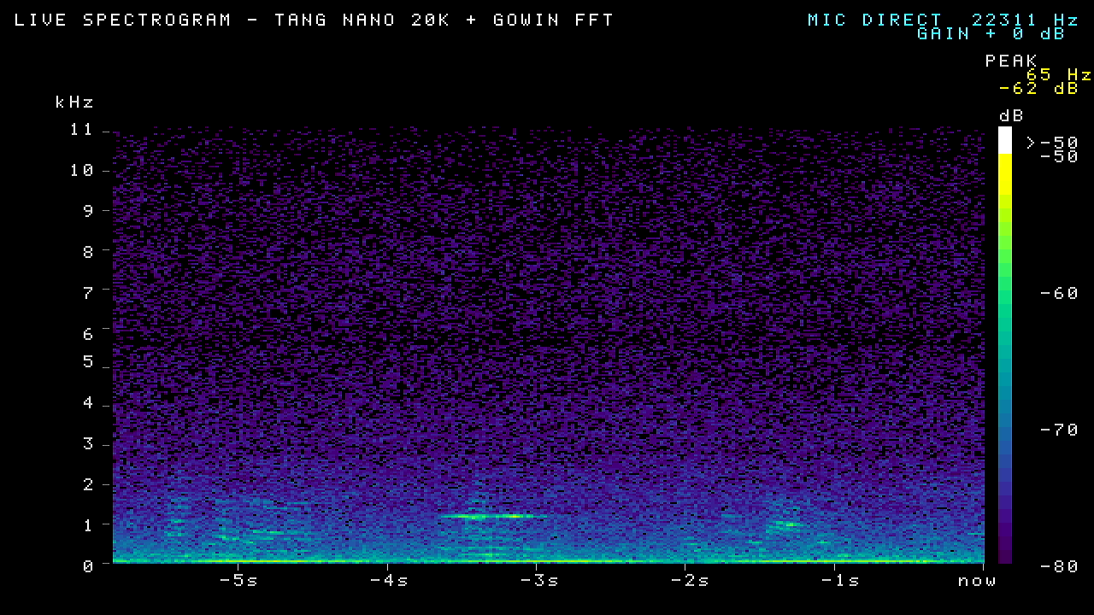
docs/figures/h6_colours_board.png
