karnza007/esp32_iot_gateway/docs/figures/h6_colours_preview.png

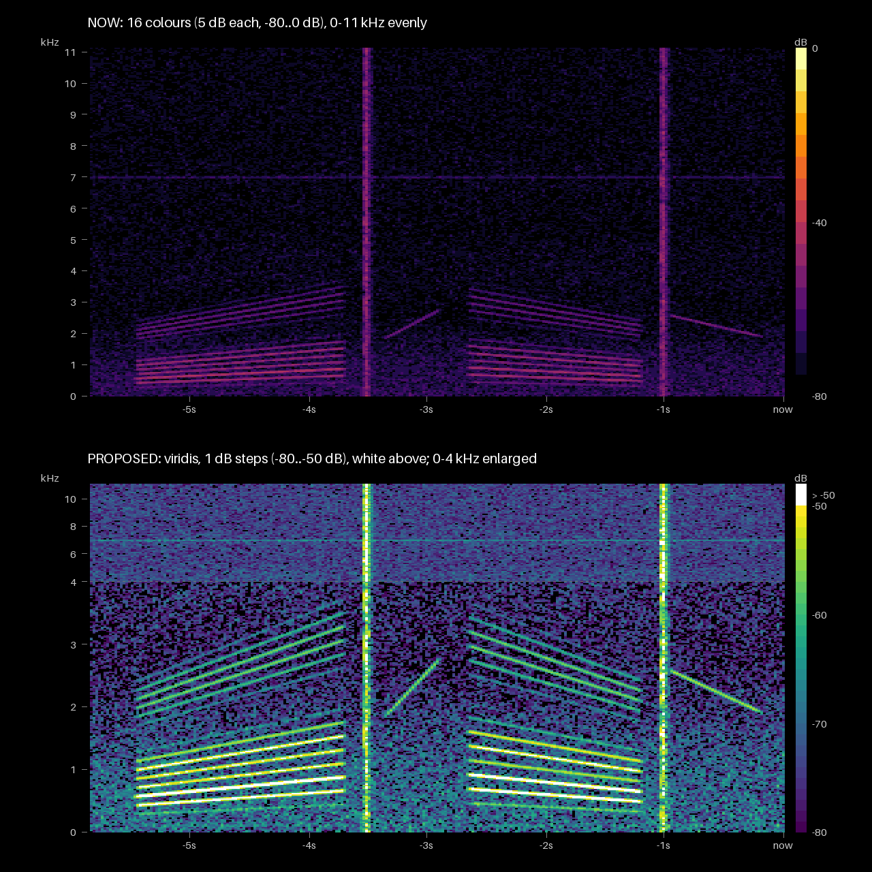
docs/figures/h6_colours_preview.png
