karnza007/esp32_iot_gateway/docs/figures/h6_layout_wave.png

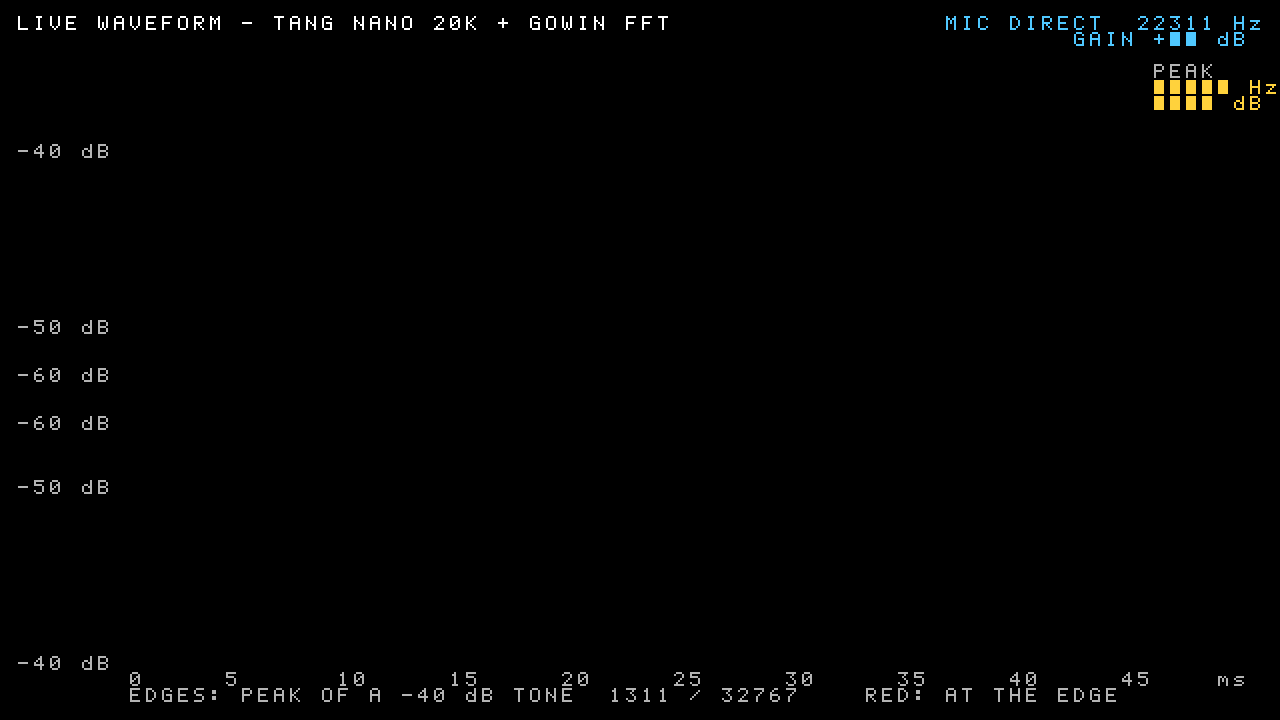
docs/figures/h6_layout_wave.png
