karnza007/esp32_iot_gateway/docs/figures/h6_zones_board.png

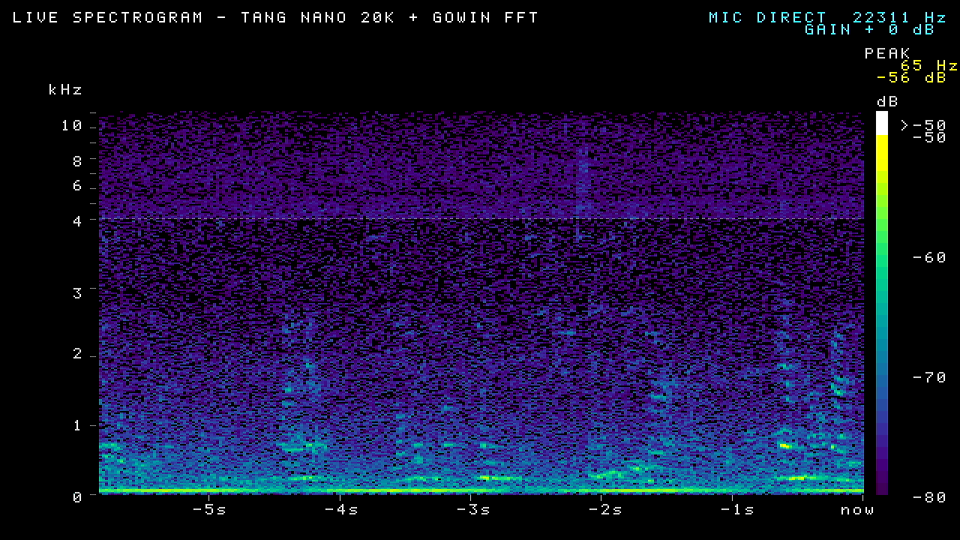
docs/figures/h6_zones_board.png
