karnza007/esp32_iot_gateway/docs/figures/h7_sweep_sim.png

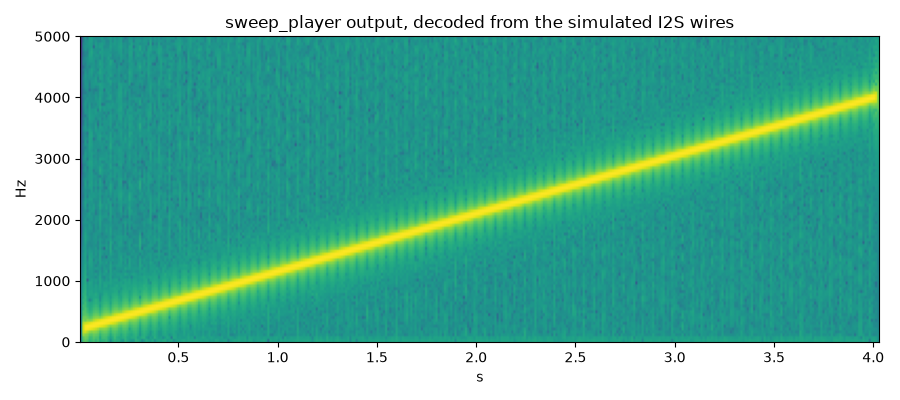
docs/figures/h7_sweep_sim.png
