karnza007/esp32_iot_gateway/fpga_fft/gen_h4_text.py

"""gen_h4_text.py — H4 screen text: writes the font, text layout and kHz tick ROMs.

    python fpga_fft/gen_h4_text.py          (re-run after changing MIC_BCLK_DIV in video_h3.v)

Writes src/hdmi/rom_font.v, rom_text.v, rom_ticks.v, rom_spec.v (the spectrogram's colour
table and tick marks), rom_wave.v (the waveform's grid and ticks) and previews of the fixed text, drawn with the same font:
docs/figures/h4_layout.png (bars) and h4_layout_spectrogram.png.

THE TEXT GRID. The 1280x720 picture is 80 x 45 cells of 16x16 px. Each cell shows one
character: a 5x7 glyph (this file's own font) drawn at 2x inside an 8x8 cell. rom_text holds a
10-bit word per cell:  [9:8] colour  [7] 1 = "live character k" (k = [3:0], set by
peak_readout.v)  [6:0] ASCII code.
PAGES. The ROM holds one page of text per display mode, chosen by text_overlay's page input
(S1): page 0 = bars, page 1 = spectrogram. ROM address = page x 3600 + row x 80 + column.
(Until 2026-11-04 only rows 1 and 42 had variants, one per sound source.)
The ROM is a block RAM (2 x 3600 words of 9 bits, 4 blocks): [8:7] colour, [6:0] ASCII code,
where codes 0-15 mean "live character k" instead. (Until 2026-11-04 it was built from logic,
10 bits per word with a separate live flag; its lookup was the slowest path in the design.)
"""
import os
import re

from PIL import Image

HERE = os.path.dirname(os.path.abspath(__file__))
HDMI = os.path.join(HERE, "src", "hdmi")
PCLK = 74.25e6

src_v = open(os.path.join(HDMI, "video_h3.v")).read()
MIC_DIV = int(re.search(r"parameter integer MIC_BCLK_DIV\s*=\s*(\d+)", src_v).group(1))
FLOOR_DB = int(re.search(r"parameter integer FLOOR_DB\s*=\s*(\d+)", src_v).group(1))
OVERLAP = int(re.search(r"parameter integer OVERLAP\s*=\s*(\d+)", src_v).group(1))
# the only sound source since 2026-11-04 (the test tone and the ESP32 relay were removed)
SOURCE = "MIC DIRECT"
FS = PCLK / (64 * MIC_DIV)                      # mic_source: 64 bit clocks per sample
COLS, ROWS = 80, 45
BARS, SPECTROGRAM, WAVE = 0, 1, 2                # pages = display modes (S1)
WHITE, GREY, YELLOW, CYAN = 0, 1, 2, 3
RGB = {WHITE: (255, 255, 255), GREY: (180, 180, 180), YELLOW: (255, 210, 60), CYAN: (80, 200, 255)}

# ---- font: 5x7 glyphs ----
GLYPHS = {
    "0": ".###.|#...#|#..##|#.#.#|##..#|#...#|.###.", "1": "..#..|.##..|..#..|..#..|..#..|..#..|.###.",
    "2": ".###.|#...#|....#|...#.|..#..|.#...|#####", "3": "#####|...#.|..#..|...#.|....#|#...#|.###.",
    "4": "...#.|..##.|.#.#.|#..#.|#####|...#.|...#.", "5": "#####|#....|####.|....#|....#|#...#|.###.",
    "6": "..##.|.#...|#....|####.|#...#|#...#|.###.", "7": "#####|....#|...#.|..#..|.#...|.#...|.#...",
    "8": ".###.|#...#|#...#|.###.|#...#|#...#|.###.", "9": ".###.|#...#|#...#|.####|....#|...#.|.##..",
    "A": ".###.|#...#|#...#|#####|#...#|#...#|#...#", "B": "####.|#...#|#...#|####.|#...#|#...#|####.",
    "C": ".###.|#...#|#....|#....|#....|#...#|.###.", "D": "###..|#..#.|#...#|#...#|#...#|#..#.|###..",
    "E": "#####|#....|#....|####.|#....|#....|#####", "F": "#####|#....|#....|####.|#....|#....|#....",
    "G": ".###.|#...#|#....|#.###|#...#|#...#|.####", "H": "#...#|#...#|#...#|#####|#...#|#...#|#...#",
    "I": ".###.|..#..|..#..|..#..|..#..|..#..|.###.", "J": "..###|...#.|...#.|...#.|...#.|#..#.|.##..",
    "K": "#...#|#..#.|#.#..|##...|#.#..|#..#.|#...#", "L": "#....|#....|#....|#....|#....|#....|#####",
    "M": "#...#|##.##|#.#.#|#.#.#|#...#|#...#|#...#", "N": "#...#|#...#|##..#|#.#.#|#..##|#...#|#...#",
    "O": ".###.|#...#|#...#|#...#|#...#|#...#|.###.", "P": "####.|#...#|#...#|####.|#....|#....|#....",
    "Q": ".###.|#...#|#...#|#...#|#.#.#|#..#.|.##.#", "R": "####.|#...#|#...#|####.|#.#..|#..#.|#...#",
    "S": ".####|#....|#....|.###.|....#|....#|####.", "T": "#####|..#..|..#..|..#..|..#..|..#..|..#..",
    "U": "#...#|#...#|#...#|#...#|#...#|#...#|.###.", "V": "#...#|#...#|#...#|#...#|#...#|.#.#.|..#..",
    "W": "#...#|#...#|#...#|#.#.#|#.#.#|#.#.#|.#.#.", "X": "#...#|#...#|.#.#.|..#..|.#.#.|#...#|#...#",
    "Y": "#...#|#...#|.#.#.|..#..|..#..|..#..|..#..", "Z": "#####|....#|...#.|..#..|.#...|#....|#####",
    "d": "....#|....#|.##.#|#..##|#...#|#...#|.####", "k": "#....|#....|#..#.|#.#..|##...|#.#..|#..#.",
    "z": ".....|.....|#####|...#.|..#..|.#...|#####",
    "n": ".....|.....|#.##.|##..#|#...#|#...#|#...#", "o": ".....|.....|.###.|#...#|#...#|#...#|.###.",
    "s": ".....|.....|.####|#....|.###.|....#|####.", "w": ".....|.....|#...#|#...#|#.#.#|#.#.#|.#.#.",
    "+": ".....|..#..|..#..|#####|..#..|..#..|.....", "-": ".....|.....|.....|#####|.....|.....|.....",
    ".": ".....|.....|.....|.....|.....|.##..|.##..", ":": ".....|.##..|.##..|.....|.##..|.##..|.....",
    "/": ".....|....#|...#.|..#..|.#...|#....|.....", "m": ".....|.....|##.#.|#.#.#|#.#.#|#...#|#...#", ">": "#....|.#...|..#..|...#.|..#..|.#...|#....",
}


def glyph_rows(ch):
    """8 bytes, MSB = leftmost pixel: the 5x7 glyph at columns 1-5, rows 0-6."""
    if ch not in GLYPHS:
        return [0] * 8
    rows = GLYPHS[ch].split("|")
    assert len(rows) == 7 and all(len(r) == 5 for r in rows), ch
    return [int("0" + r.replace("#", "1").replace(".", "0") + "00", 2) for r in rows] + [0]


# ---- text layout ----
cells = {}          # (page, row, col) -> 10-bit word
page = BARS         # the page put() writes to


def put(row, col, text, colour):
    for i, ch in enumerate(text):
        assert 0 <= col + i < COLS and 0 <= row < ROWS, (row, col, text)
        assert (page, row, col + i) not in cells, f"overlap on page {page} row {row} col {col + i}: {text!r}"
        cells[(page, row, col + i)] = (colour << 8) | ord(ch)


def put_right(row, end_col, text, colour):
    put(row, end_col - len(text) + 1, text, colour)


def put_live(row, col, first, n, colour):
    for i in range(n):
        cells[(page, row, col + i)] = (colour << 8) | 0x80 | (first + i)


def header(title):
    """Title, source, gain and peak readout: the same places on every page."""
    put(1, 1, title, WHITE)
    put_right(1, 78, f"{SOURCE}  {round(FS)} Hz", CYAN)
    put_right(2, 72, "GAIN +", CYAN)              # live 9-10: gain in dB
    put_live(2, 73, 9, 2, CYAN)
    put(2, 75, " dB", CYAN)
    put(4, 72, "PEAK", GREY)
    put_live(5, 72, 0, 5, YELLOW)                 # live 0-4: peak frequency, Hz
    put(5, 77, " Hz", YELLOW)
    put_live(6, 72, 5, 4, YELLOW)                 # live 5-8: peak level, dB
    put(6, 76, " dB", YELLOW)


# ---- page 0: bars ----
page = BARS
header("LIVE FFT SPECTRUM - TANG NANO 20K + GOWIN FFT")
# a label every 2 kHz when the axis is wide (fs 44.6 kHz: 0-22 kHz), every 1 kHz when narrow
STEP_KHZ = 2 if FS > 30000 else 1
ticks = []          # x of the kHz tick lines, bars page only
for k in range(0, 100, STEP_KHZ):
    x = 128 + round(2 * k * 1000 * 1024 / FS)
    if x > 1151:
        break
    ticks.append(x)
    label = str(k)
    put(42, round((x - 8 * len(label)) / 16), label, GREY)
put(42, 76, "kHz", GREY)
for db in range(0, -FLOOR_DB - 1, -20):        # gridlines every 20 dB from y 60 (0 dB) to 660
    put_right((60 + 600 * -db // FLOOR_DB) // 16, 6, f"{db} dB", GREY)

# ---- page 1: spectrogram (spectrogram_display.v: plot x 128-1151, y 148-659) ----
page = SPECTROGRAM
header("LIVE SPECTROGRAM - TANG NANO 20K + GOWIN FFT")
BIN_HZ = FS / 1024                              # one FFT bin
COL_PER_S = FS / (512 if OVERLAP else 1024)    # one column per FFT (every 512 samples with overlap)


def spec_row(f):
    """Row (fractional) of frequency f: one bin per row up to bin 184 (4 kHz), then 225 rows per
    1024 bins (spectrogram_display.v, ROWS). Until 2026-11-06: f / (2 bins), evenly."""
    b = f / BIN_HZ
    return b if b < 184 else 184 + (b - 184) * 225 / 1024


F_LABELS = (0, 1, 2, 3, 4, 6, 8, 10)            # kHz labels; above 4 kHz the rows are squeezed
f_ticks = []        # y of the 1 kHz tick marks left of the plot
f_labels = []       # (text row, kHz) of each label
for k in range(0, 100):
    y = 659 - round(2 * spec_row(k * 1000))
    if y < 148:
        break
    f_ticks.append(y)
    if k in F_LABELS:
        f_labels.append((round((y - 8) / 16), k))
        put_right(round((y - 8) / 16), 6, str(k), GREY)
put_right(7, 6, "kHz", GREY)
STEP_S = 1 if OVERLAP else 2                   # 256 columns = 5.9 s with overlap, 11.7 s without
t_ticks = []        # x of the time tick marks below the plot (newest column at the right edge)
for t in range(0, 100, STEP_S):
    col = 255 - t * COL_PER_S
    if col < 1:
        break
    x = 128 + round(4 * col) + 2
    t_ticks.append(x)
    label = "now" if t == 0 else f"-{t}s"
    put(42, round((x - 8 * len(label)) / 16), label, GREY)
put(8, 73, "dB", GREY)                          # colour scale, x 1168-1183: white y 148-179,
put_right(10, 78, ">-50", GREY)                 # then 30 colours of 16 px, -50 dB (y 180) down to
for db in (-50, -60, -70, -80):                 # -80 dB (y 660); label at the row holding that edge
    put_right((180 + 16 * (-50 - db)) // 16, 78, str(db), GREY)
# the 32 levels, one per dB (spectrogram_display.v): 0 = -80 dB or quieter, black, which also
# hides the FFT's own rounding noise; 1-30 = -80 .. -51 dB, matplotlib's "viridis" map sampled
# at (i-1)/29 (dark purple, blue, teal, green, yellow); 31 = -50 dB or louder, white.
# (Until 2026-11-06: 16 levels of 5 dB from -80 to 0 dB, "inferno".)
SPEC_RGB = [0x000000,
            0x440154, 0x470D60, 0x481A6C, 0x482576, 0x46307E, 0x443B84, 0x404588, 0x3C4F8A,
            0x38598C, 0x33628D, 0x2F6B8E, 0x2C738E, 0x297B8E, 0x25838E, 0x228C8D, 0x1F948C,
            0x1E9D89, 0x21A585, 0x26AD81, 0x31B57B, 0x3FBC73, 0x50C46A, 0x63CB5F, 0x77D153,
            0x8BD646, 0xA2DA37, 0xBADE28, 0xD2E21B, 0xEAE51A, 0xFDE725,
            0xFFFFFF]
assert len(SPEC_RGB) == 32


# ---- page 2: raw waveform (wave_display.v: plot x 128-1151, y 148-659, centre y 403) ----
page = WAVE
header("LIVE WAVEFORM - TANG NANO 20K + GOWIN FFT")
# Height: the edges are the peak of a tone that reads -40 dB on the bars / spectrogram scale.
# There a full-scale sine (32767) reads -12.04 dB (Hann window x FFT / 1024), so a tone reading
# D dB has the peak 4 x 32767 x 10^(D/20): -40 dB -> 1311, -50 dB -> 414, -60 dB -> 131.
# wave_display.v: off = sample x WAVE_MUL / 4096 (rounded down), limited to -256..255; y = 403 - off.
WAVE_MUL = 800                                  # 256 / 1311 x 4096


def tone_peak(db):
    return round(4 * 32767 * 10 ** (db / 20))


def wave_y(sample):
    off = max(-256, min(255, (sample * WAVE_MUL) >> 12))
    return 403 - off


w_grid = sorted({wave_y(v) for db in (-50, -60) for v in (tone_peak(db), -tone_peak(db))} | {403, 148, 659})
# (the centre line has no label: it would touch the -60 dB one on the next text row)
for db, yy in [(-40, 148), (-50, wave_y(tone_peak(-50))), (-60, wave_y(tone_peak(-60))),
               (-60, wave_y(-tone_peak(-60))), (-50, wave_y(-tone_peak(-50))), (-40, 659)]:
    put_right(round((yy - 8) / 16), 6, f"{db} dB", GREY)
W_MS_PX = FS / 1000                             # 1 px per sample
w_ticks = []        # x of the tick marks below the plot, every 5 ms
for ms in range(0, 100, 5):
    xx = 128 + round(ms * W_MS_PX)
    if xx > 1151:
        break
    w_ticks.append(xx)
    put(42, round((xx - 8 * len(str(ms))) / 16), str(ms), GREY)
put(42, 76, "ms", GREY)
put(43, 8, f"EDGES: PEAK OF A -40 dB TONE  {tone_peak(-40)} / 32767    RED: AT THE EDGE", GREY)


# ---- write the ROMs ----
def write(name, body):
    with open(os.path.join(HDMI, name), "w") as f:
        f.write(body)


lines = [f"// rom_font.v — generated by fpga_fft/gen_h4_text.py, do not edit.",
         "// 128 characters x 8 rows, MSB = leftmost pixel. Undefined characters are blank.",
         "module rom_font (", "    input  wire       clk,", "    input  wire [9:0] addr,   // {ASCII code, row}",
         "    output reg  [7:0] q = 0", ");", "    always @(posedge clk)", "        case (addr)"]
for ch in sorted(GLYPHS):
    for r, bits in enumerate(glyph_rows(ch)):
        if bits:
            lines.append(f"            10'd{ord(ch) * 8 + r}: q <= 8'h{bits:02X};   // {ch!r} row {r}")
lines += ["            default: q <= 8'h00;", "        endcase", "endmodule", ""]
write("rom_font.v", "\n".join(lines))

lines = [f"// rom_text.v — generated by fpga_fft/gen_h4_text.py, do not edit.",
         "// One 9-bit word per 16x16 cell: [8:7] colour, [6:0] ASCII; codes 0-15 = live character k.",
         "// Address page x 3600 + row x 80 + column: page 0 = bars, 1 = spectrogram, 2 = waveform.",
         "// Block RAM.",
         "module rom_text (", "    input  wire        clk,", "    input  wire [13:0] addr,",
         "    output reg  [8:0]  q = 9'h020 /* synthesis syn_romstyle = \"block_rom\" */", ");",
         "    always @(posedge clk)", "        case (addr)"]
for (pg, row, col), w in sorted(cells.items()):
    if w & 0xFF != 0x20:
        code = w & 0x0F if w & 0x80 else w & 0x7F
        lines.append(f"            14'd{pg * 3600 + row * 80 + col}: q <= 9'h{(w >> 8) << 7 | code:03X};")
lines += ["            default: q <= 9'h020;", "        endcase", "endmodule", ""]
write("rom_text.v", "\n".join(lines))

cond = " || ".join(f"x == 12'd{x}" for x in ticks)
lines = [f"// rom_ticks.v — generated by fpga_fft/gen_h4_text.py, do not edit.",
         f"// kHz tick lines every {STEP_KHZ} kHz on the bars page (mic: BCLK_DIV {MIC_DIV}, {FS:.1f} Hz).",
         "// q = 1 one clock after x.",
         "module rom_ticks (", "    input  wire        clk,", "    input  wire [1:0]  page,",
         "    input  wire [11:0] x,", "    output reg         q = 1'b0", ");", "    always @(posedge clk)",
         f"        q <= (page == 2'd0) && ({cond});", "endmodule", ""]
write("rom_ticks.v", "\n".join(lines))

lines = ["// rom_spec.v — generated by fpga_fft/gen_h4_text.py, do not edit.",
         "// Tables for spectrogram_display.v (combinational).",
         "// spec_colour: level (1 dB per step: 0 = below -80 dB, 1-30 = -80..-51 dB, 31 = -50 dB",
         "// and louder) -> RGB.",
         "module spec_colour (", "    input  wire [4:0]  i,", "    output reg  [23:0] rgb", ");",
         "    always @(*)", "        case (i)"]
lines += [f"            5'd{i}: rgb = 24'h{c:06X};" for i, c in enumerate(SPEC_RGB[:-1])]
lines += [f"            default: rgb = 24'h{SPEC_RGB[-1]:06X};", "        endcase", "endmodule", "",
          f"// spec_ticks: tick marks left of the plot every 1 kHz (x 120-127; {BIN_HZ:.2f} Hz per row up",
          "// to 4 kHz, then 225 rows per 1024 bins)",
          f"// and below it every {STEP_S} s (y 660-667; {COL_PER_S:.2f} columns per second).",
          "module spec_ticks (", "    input  wire [11:0] x, y,", "    output wire        q", ");",
          "    assign q = (x >= 12'd120 && x < 12'd128 && (" + " || ".join(f"y == 12'd{v}" for v in f_ticks) + "))",
          "            || (y >= 12'd660 && y < 12'd668 && (" + " || ".join(f"x == 12'd{v}" for v in t_ticks) + "));",
          "endmodule", ""]
write("rom_spec.v", "\n".join(lines))

lines = ["// rom_wave.v — generated by fpga_fft/gen_h4_text.py, do not edit.",
         "// Tables for wave_display.v (combinational).",
         f"// wave_grid: the centre line, the peaks of -50 dB and -60 dB tones ({tone_peak(-50)}, {tone_peak(-60)}) and the",
         f"// -40 dB edges ({tone_peak(-40)}): y = 403 - sample x {WAVE_MUL} / 4096.",
         "module wave_grid (", "    input  wire [11:0] x, y,", "    output wire        q", ");",
         "    assign q = " + " || ".join(f"y == 12'd{v}" for v in w_grid) + ";",
         "endmodule", "",
         f"// wave_ticks: tick marks below the plot every 5 ms (y 660-667; {W_MS_PX:.2f} px per ms).",
         "module wave_ticks (", "    input  wire [11:0] x, y,", "    output wire        q", ");",
         "    assign q = y >= 12'd660 && y < 12'd668 && (" + " || ".join(f"x == 12'd{v}" for v in w_ticks) + ");",
         "endmodule", ""]
write("rom_wave.v", "\n".join(lines))

# ---- previews of the fixed text, one per page (live characters shown as '#') ----
os.makedirs(os.path.join(HERE, "..", "docs", "figures"), exist_ok=True)
for pg, name in ((BARS, "h4_layout.png"), (SPECTROGRAM, "h4_layout_spectrogram.png"),
                 (WAVE, "h6_layout_wave.png")):
    img = Image.new("RGB", (1280, 720))
    px = img.load()
    for (p, row, col), w in cells.items():
        if p != pg:
            continue
        ch = "#" if w & 0x80 else chr(w & 0x7F)
        g = glyph_rows(ch) if ch != "#" else [0x7C] * 7 + [0]
        for r in range(8):
            for c in range(8):
                if g[r] >> (7 - c) & 1:
                    for dy in range(2):
                        for dx in range(2):
                            px[col * 16 + c * 2 + dx, row * 16 + r * 2 + dy] = RGB[w >> 8]
    img.save(os.path.join(HERE, "..", "docs", "figures", name))
print(f"floor -{FLOOR_DB} dB; mic BCLK_DIV {MIC_DIV}: fs {FS:.1f} Hz; text cells per page "
      f"{[sum(1 for k in cells if k[0] == pg) for pg in (BARS, SPECTROGRAM, WAVE)]}; {len(ticks)} ticks; "
      f"wave grid y {w_grid}, edges +-{tone_peak(-40)}")
