karnza007/esp32_iot_gateway/fpga_fft/src/hdmi/video_h3.v

// video_h3.v — the H3/H4 chain: the microphone -> spectrum -> bars + text -> HDMI.
// H4 adds text_overlay (title, dB and kHz labels, tick lines) and peak_readout (the loudest
// frequency and its level), on top of the H3 bars.
// mode (S1) picks the screen: 0 = bars, 1 = spectrogram (spectrogram_display: each FFT is
// one column of a scrolling 256 x 256 picture). Both are fed all the time, so switching shows
// the spectrogram's history at once.
// The only source is the INMP441 wired to the FPGA, through mic_source. Earlier sources, now
// out of the build:
//   - the INMP441 on the ESP32, relayed over UART by relay_rx.v (removed 2026-10-22: the
//     direct mic works, so the relay is no longer needed);
//   - the H2 test tone, tone_gen.v (removed 2026-11-04, to make room for the spectrogram; the
//     simulations still use it as a known input, e.g. sim/tb_h4_peak.v).
module video_h3 #(
    parameter integer CLAMP        = 32700,
    parameter integer MIC_BCLK_DIV = 52,     // mic bit clock = 74.25 MHz / this (see mic_source.v)
    parameter integer FLOOR_DB     = 80,     // bottom of the dB scale: 80 or 100 (see spectrum.v)
    parameter integer OVERLAP      = 1       // 1: an FFT every 512 samples, 50 % overlap (spectrum.v)
)(
    input  wire       pclk, fclk, rst,
    input  wire [1:0] mode,              // display: 0 = bars, 1 = spectrogram, 2 = waveform (S1)
    input  wire [2:0] gain,
    output wire       i2s_sck, i2s_ws,
    input  wire       i2s_sd,
    output wire       overrun,
    output wire       clipped,
    output wire       tmds_clk_p, tmds_clk_n,
    output wire [2:0] tmds_d_p, tmds_d_n
);
    wire signed [15:0] s;
    wire               s_valid;
    mic_source #(.BCLK_DIV(MIC_BCLK_DIV)) u_mic (.clk(pclk), .rst(rst), .i2s_sck(i2s_sck), .i2s_ws(i2s_ws), .i2s_sd(i2s_sd),
                       .gain(gain), .valid(s_valid), .sample(s), .clipped(clipped));

    wire       bar_we, bar_done;
    wire [8:0] bar_addr;
    wire [9:0] bar_h;
    spectrum #(.GAIN_SHIFT(0), .CLAMP(CLAMP), .FLOOR_DB(FLOOR_DB), .OVERLAP(OVERLAP)) u_spec (
        .clk(pclk), .rst(rst), .s_valid(s_valid), .s_in(s),
        .bar_we(bar_we), .bar_addr(bar_addr), .bar_h(bar_h), .bar_done(bar_done),
        .overrun(overrun));

    wire [11:0] x, y;
    wire        de, hs, vs, fs;
    video_timing u_tim (.clk(pclk), .rst(rst), .x(x), .y(y), .de(de), .hs(hs), .vs(vs),
                        .frame_start(fs));
    wire [7:0] br, bg, bb;
    bar_display #(.FLOOR_DB(FLOOR_DB)) u_bars (.clk(pclk), .bar_we(bar_we), .bar_addr(bar_addr), .bar_h(bar_h),
                        .bar_done(bar_done), .x(x), .y(y), .de(de), .r(br), .g(bg), .b(bb));

    wire [7:0] sr, sg, sb;
    spectrogram_display u_sgram (.clk(pclk), .bar_we(bar_we), .bar_addr(bar_addr), .bar_h(bar_h),
                        .bar_done(bar_done), .x(x), .y(y), .de(de), .r(sr), .g(sg), .b(sb));

    wire [7:0] wr, wg, wb;
    wave_display u_wave (.clk(pclk), .s_valid(s_valid), .s_in(s), .x(x), .y(y), .de(de),
                         .r(wr), .g(wg), .b(wb));

    wire [76:0] dyn;
    peak_readout #(.MIC_BCLK_DIV(MIC_BCLK_DIV), .FLOOR_DB(FLOOR_DB)) u_peak (
        .clk(pclk), .rst(rst), .bar_we(bar_we), .bar_addr(bar_addr), .bar_h(bar_h),
        .bar_done(bar_done), .gain(gain), .dyn(dyn));
    wire [23:0] rgb;
    text_overlay u_text (.clk(pclk), .x(x), .y(y), .de(de), .page(mode), .dyn(dyn),
                         .bar_rgb(mode == 2'd1 ? {sr, sg, sb} : mode == 2'd2 ? {wr, wg, wb} : {br, bg, bb}),
                         .rgb(rgb));

    // the final colour comes 4 clocks after x/y (text_overlay.v): sync signals are delayed by 4
    reg [2:0] d1 = 0, d2 = 0, d3 = 0, d4 = 0;
    always @(posedge pclk) begin d1 <= {de, hs, vs}; d2 <= d1; d3 <= d2; d4 <= d3; end

    hdmi_out u_out (.pclk(pclk), .fclk(fclk), .rst(rst), .r(rgb[23:16]), .g(rgb[15:8]), .b(rgb[7:0]),
                    .de(d4[2]), .hs(d4[1]), .vs(d4[0]),
                    .tmds_clk_p(tmds_clk_p), .tmds_clk_n(tmds_clk_n),
                    .tmds_d_p(tmds_d_p), .tmds_d_n(tmds_d_n));
endmodule
