karnza007/esp32_iot_gateway/fpga_fft/src/fft/fft_1024_tmp.v

//Copyright (C)2014-2025 Gowin Semiconductor Corporation.
//All rights reserved.
//File Title: Template file for instantiation
//Tool Version: V1.9.11.03 Education
//Part Number: GW2AR-LV18QN88C8/I7
//Device: GW2AR-18
//Device Version: C
//Created Time: Thu Oct  8 17:02:10 2026

//Change the instance name and port connections to the signal names
//--------Copy here to design--------

	fft_1024 your_instance_name(
		.idx(idx), //output [9:0] idx
		.xk_re(xk_re), //output [15:0] xk_re
		.xk_im(xk_im), //output [15:0] xk_im
		.sod(sod), //output sod
		.ipd(ipd), //output ipd
		.eod(eod), //output eod
		.busy(busy), //output busy
		.soud(soud), //output soud
		.opd(opd), //output opd
		.eoud(eoud), //output eoud
		.xn_re(xn_re), //input [15:0] xn_re
		.xn_im(xn_im), //input [15:0] xn_im
		.start(start), //input start
		.clk(clk), //input clk
		.rst(rst) //input rst
	);

//--------Copy end-------------------
