karnza007/esp32_iot_gateway/(commit log)

2026-07-20 Initial commit: consolidate capstone FPGA/ESP32/host work
    Copied verified M1 sources from FPGA_project/PLL_test and I2S_test into a
    structured repo, and added docs: requirements, hardware, protocol, architecture,
    roadmap, troubleshooting, plus the Step 1 instrumentation plan awaiting review.
2026-08-14 M2: instrument the link so data loss is measured, not guessed
    Frame format v2 (1036 B) adds a sequence number, a cumulative FIFO overflow
    byte count, a config word, and a payload checksum. Together these turn 'the
    audio sounds bad' into a drop rate plus an attribution of WHERE the loss
    happened - which is the evidence the SPI milestone needs.
    FPGA:
    - framer.v: FIFO 32->64 B, seq/ovf/cfg header snapshotted at frame start,
    additive checksum trailer, saturating overflow counter
    - i2s_master_rx.v: BCLK_DIV is now a parameter; SCK_HIGH and SAMPLE_PT derive
    from it so every sweep point works unedited
    - uart_tx.v: bit timer sized by clog2(CLK_PER_BIT) so the baud can be slowed
    deliberately f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
2026-08-31 docs: add 07-bringup — programming steps, null test, positive control
2026-08-31 M2 hardware: null test passes; fix metrics and overflow counter semantics
    Null test PASS on hardware: 191 s at BCLK_DIV=25, 0 lost / 0 overflow /
    0 checksum errors throughout.
    Three fixes the real data exposed:
    - resyncs counted once per frame by construction, so it equalled frames_ok and
    measured nothing. _resync() now returns bytes discarded before the sync match;
    stats carry resync_events and bytes_skipped, both 0 in a healthy link.
    - throughput was ambiguous: the viewer reported payload bytes while the docs
    quoted wire bytes (30,000 vs 30,352 B/s at 15 kHz). Both are now reported and
    logged. wire_Bps is what M3 must compare against the 200 kB/s UART capacity.
    - overflow counter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
    [framer.v, inmp441_viewer.py, test_viewer_parser.py]
2026-08-31 Add experiment protocol, results log, and weekly report scaffolding
    Discovered during bring-up that there are TWO serial links, and the second is
    the tighter one: ESP32->host runs at 921600 baud = 92,160 B/s, less than half
    of the 200,000 B/s FPGA->ESP32 link. Earlier docs quoted 200 kB/s as 'the UART
    capacity', which was link 1 only.
    Consequence: a single INMP441 CAN saturate the chain. At BCLK_DIV=8 one channel
    produces 94.8 kB/s against a 92.2 kB/s ceiling (103%), so M3 is not blocked on
    owning a second microphone. The expected failure mode also changes -- the FPGA
    drains fine into link 1, so loss forms inside the ESP32 and should read
    GATEWAY LOSS (ESP32/USB) rather than LINK SATURATED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
    [fpga_uart_bridge.ino, summarize_run.py, top.v]
2026-08-31 viewer: start and report even when no frame is intact
    The positive control could not run. Startup waited for one checksum-valid frame,
    but at an 18% byte-loss rate no frame is ever intact, so the viewer timed out
    and exited having measured nothing -- refusing to run in exactly the condition
    it exists to measure. The plan's own prediction table said frames_ok would be
    near zero; the startup path contradicted it.
    - a corrupt-payload frame can now start the run if its header is plausible
    (plausible_cfg checks BCLK_DIV range, channel count, reserved bits)
    - statistics are reported before and independently of the audio plot, so the
    numbers appear when there is no audio to draw
    - startup fail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
    [inmp441_viewer.py, test_viewer_parser.py]
2026-08-31 framer: reserve FIFO space for framing bytes; host: sync-delimited parser
    The positive control found a real design flaw. With link 1 at 250 kbaud a raw
    port probe showed 24,957 B/s arriving -- exactly link capacity, working flat out
    -- and ZERO sync words in five seconds.
    Cause: a priority inversion. At 250 kbaud a UART byte takes 960 clocks while an
    I2S sample period is 1600, so the FIFO runs permanently full. The header is
    pushed as 10 bytes in 10 consecutive clocks, during which the UART drains 0.01
    bytes, so the whole header -- sync word included -- is discarded every frame.
    Audio survives because it trickles in 2 bytes at a time. The stream degrades in
    exactly the wrong direction: payl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
    [framer.v, inmp441_viewer.py, probe_port.py, summarize_run.py, tb_framer.v, test_viewer_parser.py]
2026-08-31 M2-PC positive control PASSES: overflow counter proven correct on hardware
    211 s at 250 kbaud (25,000 B/s supply vs 30,352 B/s demand):
    ovf rate 5,379 B/s predicted 5,352 0.5% error
    frame rate 29.30 /s predicted 29.30 0.0% error
    bytes missing/frame 184 predicted 183 0.5% error
    verdict LINK SATURATED (FPGA FIFO) in all 206 intervals
    Three things proven:
    1. The counter counts. Lifetime total went from 0 to 1,133,450 bytes at the
    arithmetic shortfall rate.
    2. Two independent measurements agree exactly: ovf (counted inside the FPGA)
    and bytes_missing (measured by the host from sync-delimited frame lengths)
    both total 1,133,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
    [summarize_run.py]
2026-08-31 restore normal operation: link 1 back to 2 Mbaud
    The positive control's temporary values (CLK_PER_BIT=96, FPGA_BAUD=250000) were
    committed by accident during the framer fix, so 'git checkout --' could not undo
    them. Set explicitly back to 12 / 2000000.
    Lesson worth keeping: a deliberately-broken configuration should never be left
    where a routine 'git add -A' can sweep it into a commit. M3's sweep changes
    BCLK_DIV the same way, so each sweep point gets committed on purpose with its
    value named in the message.
    [fpga_uart_bridge.ino, top.v]
2026-08-31 M2 COMPLETE: recovery null test passes, instrument proven in all three states
    49 s after restoring 2 Mbaud: 1439/1439 frames intact, every counter 0,
    30,358 B/s wire (30,352 predicted), verdict OK in all 48 intervals.
    healthy silent all counters 0
    overloaded accurate 5,379 B/s vs 5,352 predicted (0.5%)
    restored silent all counters 0
    A detector that only ever reads zero proves nothing. One that reads zero, then
    the right non-zero number, then zero again, is a working instrument.
    Wire rate across three separate null runs: 30,348 / 30,358 B/s vs 30,352
    predicted -- spread under 0.04%.
2026-08-31 M3 plan; link 2 baud configurable end to end, default now 2 Mbaud
    Link 2 was at 921,600 because it was inherited from M1, not chosen -- a
    conventional 'safely fast' default picked before anyone knew the required data
    rate. It was never justified by measurement, and at 92,160 B/s it was less than
    half of link 1, making it the chain's real ceiling unnoticed until bring-up.
    Raising it to 2 Mbaud is right -- the experiment should measure what UART can
    do, not what a default allowed -- but it changes the experiment: with both links
    at 200,000 B/s, one INMP441 maxes out at 94,849 B/s = 47%, so a single mic can
    no longer saturate anything.
    So M3 runs the sweep from both directions:
    A sweep BCL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
    [fpga_uart_bridge.ino, inmp441_viewer.py]
2026-08-31 M3 phase 0 PASS: CH9102 sustains 2 Mbaud; fix link-2 capacity being a constant
    59 s at link 2 = 2,000,000 baud, BCLK_DIV=25: 1736/1736 frames intact, every
    counter 0. The bridge delivers its nominal rate, so link 2 is no longer the
    chain's ceiling -- both links are now 200,000 B/s.
    Bug found by the user reading the output: summarize_run.py reported '33% of
    link 2' for a run at 2 Mbaud because link 2's capacity was a module constant.
    It is a property of the run, and M3 phase C sweeps it deliberately -- every
    phase C point would have been mislabelled.
    - viewer now records link2_baud, bclk_div and channels IN the CSV, so a data
    file states the conditions it was captured under, as the cfg fi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
    [inmp441_viewer.py, summarize_run.py]
2026-08-31 viewer refuses to blend runs; add tools/split_runs.py to repair one that was
    A sweep point was run twice to the same --csv. The viewer opened in append mode,
    so both runs landed in one file -- and the first was a stale-bitstream run: the
    recorded bclk_div column says 20, not the 16 the filename claims. The summary
    would have averaged a wrong data point into a right one.
    Caught only because the CSV now records bclk_div, added one commit earlier for
    an unrelated reason. Self-describing data paid for itself immediately.
    - viewer refuses an existing non-empty --csv unless --append is given, and now
    truncates rather than appends by default: a sweep point must be exactly one run
    - tools/split_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
    [inmp441_viewer.py, split_runs.py, summarize_run.py, top.v]
2026-08-31 M3 phase A complete: H1 held, zero loss across the full sample-rate range
    BCLK_DIV 25->8 with both links at 2 Mbaud. Six points, ~23,600 frames, zero
    frames lost, zero overflow, zero checksum errors. Worst throughput error 0.05%
    across a 3.1x range of data rates.
    The throughput also confirms the sample rate independently: at DIV=8, 94,816 B/s
    / 1036 = 91.52 frames/s x 512 = 46,859 Hz vs 46,875 nominal, 0.034% agreement.
    Also: FFT peak interpolation. A 440 Hz tone read high at DIV=8, which is
    resolution, not a fault -- a 512-point FFT at 46,875 Hz has 91.6 Hz bins, so
    440 Hz can only land on the 457.8 Hz bin. Fitting a parabola through the peak
    bin and its neighbours on log magnitude recove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
    [inmp441_viewer.py, top.v]
2026-08-31 M3 phase B config: link 2 -> 921600 baud, BCLK_DIV stays 8
    Deliberate sweep-point commit, settings named (M2 ended with a broken config
    swept in by a routine 'git add -A'; each M3 point is committed on purpose).
    link 1 FPGA -> ESP32 2,000,000 baud = 200,000 B/s unchanged
    link 2 ESP32 -> host 921,600 baud = 92,160 B/s CHANGED from 2,000,000
    BCLK_DIV = 8, fs = 46,875 Hz, demand 94,849 B/s
    DIV=8 is run first because it is the hypothesis-critical point: 102.9% of link 2
    but only 47.4% of link 1. H3 predicts loss reported as GATEWAY LOSS (ESP32/USB)
    with ovf = 0. That verdict has never fired, so the instrument's ability to
    discriminate between the two failure modes is still u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
    [fpga_uart_bridge.ino, top.v]
2026-08-31 frame v3: the header gets its own checksum; fix verdict misattribution
    The first phase B run at DIV=8 exposed two faults in the instrument.
    1. VERDICT MISATTRIBUTION. verdict() treated bytes_missing > 0 as proof of FPGA
    overflow. It is not: the ESP32 dropping bytes mid-frame also produces short
    frames at the host. Only ovf, incremented inside the FPGA, attributes loss to
    the FPGA. The run reported LINK SATURATED (FPGA FIFO) in all 59 intervals
    while ovf_delta was 0 in 58 of them -- i.e. it blamed the wrong component in
    the one test built to tell them apart. Now short/missing frames read
    GATEWAY LOSS (ESP32/USB) and only ovf reads LINK SATURATED.
    2. UNPROTECTED HEADER. One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
    [framer.v, inmp441_viewer.py, tb_chain.v, tb_framer.v, test_viewer_parser.py]
2026-08-31 M3-B div8: H3 HELD -- gateway loss correctly attributed, ovf = 0
    59 s at BCLK_DIV=8 with link 2 at 921,600. The FPGA offers 95,032 B/s (103.1% of
    link 2, but only 47.5% of link 1), so loss must occur and it must NOT be the
    FPGA's fault.
    frames lost 319 -> 5.88%
    checksum errors 1335 -> 26.1%
    header errors 0
    FPGA overflow 0 bytes
    verdict GATEWAY LOSS (ESP32/USB) in all 59 intervals
    This completes the instrument. It had only ever been demonstrated one way --
    silent when healthy, and accurate when the FPGA overflowed. GATEWAY LOSS had
    never fired, so its ability to tell the two failure modes apart was unproven in
    one direction. It now is, and everything M4 clai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
2026-08-31 M3 phase B complete: H2 held; add automated build/program/capture sweep
    Same six FPGA configurations run twice, differing only in link 2's baud rate:
    DIV offered A (2 Mbaud) B (921,600)
    25 30,410 15% 0.00% 33% 0.00%
    20 38,013 19% 0.00% 41% 0.00%
    16 47,516 24% 0.00% 52% 0.00%
    12 63,354 32% 0.00% 69% 0.00%
    10 76,025 38% 0.00% 82% 0.00%
    8 95,032 48% 0.00% 103% 5.88% GATEWAY LOSS (ESP32/USB)
    Twelve runs, one loses data, and it is the only point where demand exceeds
    capacity. The div8 bitstream is byte-identical in both columns, so column A
    rules out the FPGA, the microphone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
2026-08-31 M3 phase C: H4 held; the knee is at capacity and it is a cliff
    Demand held at 95,032 B/s (BCLK_DIV=8), link 2 swept 2,000,000 -> 460,800:
    baud demand% drop% cksum% usable audio
    950,000 100.0 0.00 0.0 100%
    921,600 103.1 5.50 26.1 70%
    750,000 126.7 23.45 100 0%
    460,800 206.2 55.70 100 0%
    The link is perfect at exactly 100.0% of its rating and collapses just past it.
    Three percent over capacity costs thirty percent of the payload; twenty-seven
    percent over costs all of it. Loss is nowhere near proportional to overload,
    because a frame missing one byte fails its checksum and is discarded whole.
    Phase C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
    [fpga_uart_bridge.ino, top.v]
2026-08-31 restore bench to baseline: BCLK_DIV=25, link 2 = 2 Mbaud, FPGA in flash
    The sweeps left the boards at their last point (BCLK_DIV=8, HOST_BAUD=460800)
    and the FPGA in SRAM, which is lost on power-cycle. Restored to the documented
    baseline and written to embedded flash so the demo survives unplugging.
    Verified: 30,398 B/s, sync every 1038 bytes, cfg reports BCLK_DIV=25, ovf 0.
2026-08-31 plan M3-D: measure how fast the UART chain can actually go
    M3 established where a UART breaks relative to its own rating (at capacity, as a
    cliff). It did not establish what that rating can be raised to -- every M3 number
    used inherited defaults, not measured limits. Before claiming SPI is necessary,
    measure how far UART goes first.
    D1 sweep CLK_PER_BIT 12->3 (2->8 Mbaud) at light load: link 1's ceiling
    D2 sweep HOST_BAUD 2M->6M at light load: link 2's ceiling
    D3 second INMP441, both links at their measured best: can 190 kB/s break it?
    D1 and D2 run at ~7% load deliberately. A failure there cannot be congestion --
    only the receiver or the wire. That separates signal integrity from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
2026-08-31 propose M3-D method: a gateway diagnostic mode to tell the two links apart
    D1/D2 test each link's top speed at light load, so a failure is signal integrity
    rather than congestion. But both failures look identical at the host: bytes
    arrive and nothing decodes, because the ESP32 faithfully forwards whatever it
    received. The host cannot tell whether the garbage was created before or after
    the gateway.
    The gateway is the only place that knows. Proposed MODE_DIAG: the ESP32 stops
    forwarding, counts the FPGA's sync words itself, and reports in plain text twice
    a second. A readable GWDIAG line IS proof that link 2 works, whatever link 1 is
    doing -- so 'lines readable but sync = 0' isolates link 1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
2026-08-31 M3-D D1 partial: link 1 clean to 6 Mbaud; 8 Mbaud inconclusive
    First pass counted sync words at light load and found 2-6 Mbaud fine, 8 Mbaud
    failed. On re-test 8 Mbaud then passed twice, with the edits verified applied --
    so the boundary is intermittent, not sharp. A marginal link is worse than a
    failed one: it works in a demo and quietly corrupts data in a measurement.
    Method revised accordingly. Sync-counting only asks 'did any frame survive?';
    a link with a rare bit error still shows sync words while damaging payloads.
    D1 now runs MODE_PUMP at the highest data rate (BCLK_DIV=8, 95 kB/s, 3x the
    bits) with link 2 pinned at a known-good 48%-loaded 2 Mbaud, and counts checksum
    and header err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
    [fpga_uart_bridge.ino, inmp441_viewer.py, read_diag.py]
2026-08-31 M3-D D1+D2 complete: no ceiling found on either link; H6 falsified
    link 1 clean at 8,000,000 baud 16,368 frames over two 90 s runs, 0 errors
    link 2 clean at 6,000,000 baud 4,061 frames, 0 errors
    Neither ceiling was reached. H6 (link 1 fails below 8 Mbaud, on the basis that
    the ESP32-S3 UART is specified to ~5 Mbaud) is falsified. H7 held by a wide
    margin: link 2 was assumed all through M3 to be limited to 921,600, a value
    inherited from M1 and never measured; it runs 6.5x faster.
    The earlier 8 Mbaud failure was a transient, not a limit -- it happened on the
    first attempt right after flashing and never recurred in three later runs
    totalling over three minutes. Methodological hazard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
    [fpga_uart_bridge.ino, top.v]
2026-08-31 M3-D complete: link 2 capped at 6 Mbaud by the macOS driver, not the hardware
    link 1 clean at 2, 3, 4, 4.8, 6, 8, 12 Mbaud -- NO ceiling found. 12 Mbaud is
    simply the fastest a 24 MHz clock can produce (CLK_PER_BIT=2).
    link 2 clean to 6,000,000; 6.5 M and above give ZERO bytes, not corrupt bytes.
    Zero bytes is a refusal, not degradation, so a decisive test followed. With the
    ESP32 set to transmit at 6.5 Mbaud, probing the host at mismatched rates returned
    garbage bytes (47,853 B/s at 6 M, 22,386 at 2 M) rather than silence -- proving
    the ESP32 transmits fine. And pyserial cannot even open the port:
    requested 6,000,000 -> port reports 6,000,000 OK
    requested 6,500,000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
2026-08-31 system clock 24 -> 54 MHz; the clock now travels in the frame
    96 MHz was built and REJECTED by the timing gate before any programming:
    constraint 96.000 MHz, actual Fmax 73.894 MHz, 7 logic levels. The critical path
    was inside the FIFO -- wptr -> count subtract chain -> compare -> memory write
    enable, with occupancy computed combinationally.
    An attempt to shorten it (incremental occupancy, registered full flags) broke the
    simulations and the cause was not established, so it was reverted rather than
    shipped. An unverified change to the buffer that decides which bytes get dropped
    is the wrong thing to trust. Left as future work if >74 MHz is ever wanted.
    54 MHz needs no logic changes: 37% ma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
    [gowin_pllvr.v, inmp441_viewer.py, tb_chain.v, test_viewer_parser.py, top.v]
2026-08-31 plan the D1 rerun at 54 MHz; fix a stale 24 MHz comment in the sketch
    Six usable link-1 rates above 6 Mbaud (6.75, 7.71, 9, 10.8, 13.5, 18) where
    24 MHz offered two, so the ceiling can be located rather than bracketed.
    Estimated 12 min 30 s for 7 points at 45 s capture each, from per-point overhead
    measured today: synthesis 32 s + FPGA program 3 s + ESP32 compile/flash 25 s +
    settle 2 s = 62 s. 45 s matches every D1/D2 point so far, keeping results
    directly comparable.
    Bench left in a known-good state and written to embedded flash, so it survives
    unplugging: 54 MHz, BCLK_DIV=56 (15,067 Hz), both links 2 Mbaud, MODE_PUMP.
    Verified alive at 30,533 B/s with sync every 1038 bytes.
    Co-Authored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
    [fpga_uart_bridge.ino]
2026-09-03 fix comments left stale by the 24 -> 54 MHz change
    top.v still described a 24 MHz PLL and listed the 24 MHz divider table; the
    viewer's docstring still derived fs from a hardcoded 24 MHz and called the frame
    1036 bytes (it is 1038); plausible_cfg still said the clock code was in 12 MHz
    units after it moved to 6.
    None of this is executable code, which is exactly why it is worth fixing: this
    project has been caught three times by a value written in one place and assumed in
    another, and a comment asserting 24 MHz beside a 54 MHz build is the shape of the
    next one.
    Claude-Session: https://claude.ai/code/session_01FDyyRsyoxvz6WUd8hJGuQs
    [inmp441_viewer.py, top.v]
2026-09-03 link 1 ceiling FOUND: clean to 13.5 Mbaud, collapses at 18
    Seven rates at 54 MHz, BCLK_DIV=18 (95 kB/s), link 2 pinned at a known-good
    2 Mbaud and 48% loaded so every error belongs to link 1:
    6.00 Mbaud 4044 frames 0.000% corrupt CLEAN
    6.75 Mbaud 4044 frames 0.000% corrupt CLEAN
    7.71 Mbaud 4041 frames 0.000% corrupt CLEAN
    9.00 Mbaud 4045 frames 0.000% corrupt CLEAN
    10.80 Mbaud 4045 frames 0.000% corrupt CLEAN
    13.50 Mbaud 4045 frames 0.000% corrupt CLEAN
    18.00 Mbaud 3 frames 99.920% corrupt FAILING
    Zero errors in over 24,000 frames across six consecutive rates, then near-total
    failure: three intact frames out of 3889.
    The two links fail in completel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
2026-09-03 README refresh; add the link-2 capacity test (sketch + host tool), unflashed
    README was still describing the 24 MHz era: old clock, 1036-byte frames, a
    roadmap listing finished milestones as pending. Refreshed with the real signal
    chain, the 54 MHz clocking, the 1038-byte v3 frame, the actual milestone status,
    and a table of the tools that now exist.
    New, not yet flashed, for review before running:
    firmware/link2_blast/ -- generates its own load instead of using audio. Two
    INMP441s produce 190 kB/s, about 16% of what native USB should manage, so audio
    cannot measure link 2 at all. This writes a counting pattern as fast as the
    chosen link accepts.
    It also answers 'how do you separate the d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
2026-09-03 link 2 measured on three transports: native USB wins at 989 kB/s, lossless
    CH9102 @2 Mbaud 199,797 B/s 99.9% of nominal 256 B lost in 10 s
    CH9102 @6 Mbaud 579,875 B/s 96.6% of nominal 16,896 B lost (0.29%)
    native USB 988,789 B/s no configured rate 0 B lost
    Native USB is 1.71x the fastest CH9102 rate and the only one of the three that
    lost nothing. Chain ceiling rises 600 -> 989 kB/s for no hardware change; the
    connector was already on the board and already enumerating.
    Three findings:
    - A UART does achieve its rated capacity: 99.9% of baud/10 at 2 Mbaud. Confirms
    from a second direction the M3-C correction that there is no hidden UART framing
    overhea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
    [link2_blast.ino]
2026-09-03 link 2 lossless sweep: the CH9102 only works at 12 MHz / integer rates
    Nine UART rates and native USB, 30 s each, pattern counting mod 251 so that
    losses of exactly 256/512/1024 bytes -- the sizes serial buffers come in -- are
    no longer invisible.
    921,600 92,608 B/s 0.0163% 2,500,000 GARBAGE, 94% of bytes wrong
    1,000,000 100,378 0.0187% 3,000,000 296,028 0.0103%
    1,500,000 150,252 0.0108% 4,000,000 390,031 0.0024% <- best
    2,000,000 198,924 0.0099% 5,000,000 NO DATA AT ALL
    6,000,000 577,156 0.5729%
    native USB 969,619 B/s 0 discontinuities in 29,097,984 bytes LOSSLESS
    THE TWO FAILURES ARE NOT SPE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
    [link2_blast.ino, measure_link2.py]
2026-09-03 link 2 moved to native USB; verified carrying audio
    Adopted after measurement. The bridge selects the peripheral by name
    (LINK2 = LINK2_USB), the viewer prefers /dev/cu.usbmodem*, and the sweep scripts
    build with CDCOnBoot=cdc. The CH9102 path stays selectable with a one-line change.
    Null test over native USB: 1302/1302 frames intact, every counter zero, 30,578
    B/s. Same audio, same rate, and link 2 now sits at 3% load instead of 15%.
    CH9102 UART native USB
    best throughput 390,031 B/s 969,619 B/s
    loss there 0.0024% 0
    lossless anywhere? no yes
    rates that work 12 MHz / integer n/a
    constants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
2026-09-04 add the synthetic load generator: fill link 1 and see whether it leaks too
    Every link-1 measurement so far ran at ~7% load -- 95 kB/s down a link carrying
    200 kB/s or more. That proved the bits survive at high baud. It never asked
    whether link 1 loses data when the link is actually FULL, which is how link 2
    turned out to fail: ~130-byte chunks vanishing every few seconds at a rate that
    did not depend on throughput.
    Filling link 1 needs 200 kB/s. One INMP441 makes 95, two make 190, and there is
    no third. So the load has to be generated.
    fpga/src/sample_gen.v -- a 16-bit counter at fs = SYS_CLK / GEN_DIV. Everything
    downstream is untouched: same framer, FIFO, header, both checksums, UART. On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
    [inmp441_viewer.py, sample_gen.v, tb_gen.v, test_viewer_parser.py, top.v]
2026-09-04 CORRECTION: the link-2 loss did not reproduce; two claims withdrawn
    Three bugs in the measuring tools manufactured the original result, each
    producing a plausible number rather than an error:
    counter wrapped at 251 a 256/512-byte loss read as continuous
    16-bit counter unaligned every step looked like a 510-byte loss (99.6%)
    zero bytes scored LOSSLESS a dead link reported perfect
    Compounding them, early runs reflashed the ESP32 between points and ran while the
    machine was compiling bitstreams -- the host was heavily loaded during the very
    measurements used to characterise the link.
    With the tools fixed, nine controlled runs: every transport, every usable rate,
    idle and under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
    [fpga_uart_bridge.ino, link2_blast.ino, measure_link2.py, top.v]
2026-09-04 M3-G: link 1 does not leak; clean to 95% of capacity, total collapse at 107%
    The question every earlier link-1 test could not ask: does link 1 lose data when
    it is actually FULL? Those tests ran at ~7% load. Audio cannot fill it -- one
    INMP441 makes 95 kB/s against a 200 kB/s link -- so the load was generated.
    25% 2139 frames 0 lost ovf 0 delivered 50,259 of 50,311
    50% 4285 0 0 100,634 of 100,622
    78% 6618 0 0 155,457 of 155,506
    86% 7281 0 0 171,004 of 171,057
    95% 8090 0 0 190,067 of 190,063
    107% 0 9100 bad ovf 643,178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
    [top.v]
2026-10-08 FFT benchmark F0: integer FFT yardstick, test signals, proven correctness gate
    The plan's 'within 3 dB of the ideal model' rule failed a correct
    double-rounding design (5-7 dB above ideal). Correct designs measure
    0.4-1.3 LSB rms; realistic bugs 400+ LSB. Correctness is now a 2-LSB gate
    and accuracy a separate number. Tone bins moved to odd bins: even bins
    scored ~92 dB by luck of butterfly layout.
    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
    [f0-model-baseline.csv]
2026-10-08 FFT benchmark E1: ESP32-S3 ESP-DSP 16-bit FFT measured (SIMD and plain C)
    SIMD: 65 us FFT + 108 us bit-reverse at N=1024; 1.82 LSB rms on noise
    (+12.6 dB vs best possible). Plain C: 1030 us, 0.455 LSB (+0.5 dB).
    SIMD fails the 2-LSB gate once by 0.003 LSB; gate revision pending.
    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
    [e1-esp32-ansi.csv, e1-esp32-simd.csv]
2026-10-08 FFT gate raised 2 -> 4 LSB rms after E1 (decision recorded with both verdicts)
    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
    [e1-esp32-simd.csv]
2026-10-08 FFT benchmark F1: Gowin FFT IP cannot be built at 1024 on GW1NSR-4C; max 16 points
    The core's data memory needs true dual-port BSRAM (DPB), which the
    GW1NSR-4C lacks. The generator offers BSRAM for this part and reports
    6 BSRAM with no warning; place & route fails. REG memory: 64 exceeds
    flip-flops, 32 exceeds logic, 16 fits (64% logic, Fmax 44.3 MHz).
    Variants rebuilt without the GUI via try_variant.sh.
    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
    [defile.v, fft_1024.v, fft_1024_tmp.v, gen_twiddles.py, sizing_top.v]
2026-10-08 F1: verify the 4K has no dual-port BSRAM (datasheet, IDE device lists, build test)
    Datasheet DS861 Table 2-5 note: GW1NS-4C/4 do not support dual port mode.
    RAM_DPB generator omits GW1NSR-4C; lists GW1NR-9C and GW2AR-18C.
    True dual-port RAM fails P&R on the 4K, builds on 9K and 20K (control).
    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
    [sdp.v, tdp.v, top.v]
2026-10-08 FFT plan: run at the board's 27 MHz crystal, UART 1 Mbaud; target board 9K or 20K
    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
2026-10-08 Weekly report draft (week ending 2026-10-11): ESP32 FFT done, FPGA part pending
    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
2026-10-08 FFT bench F2: ESP32 <-> Tang Nano 20K echo test passes (650/650 frames)
    - fpga_fft retargeted to GW2AR-18C (core regenerated, settings unchanged)
    - FPGA frame engine: uart_rx -> 1024x32 BSRAM -> uart_tx at 1 Mbaud, 27 MHz, no PLL
    - ESP32 'E' command forwards to the FPGA; reply header gains a has_payload flag
    - fft_bench.py fpga-echo; docs section 10, plan and weekly report updated
    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
    [f2-fpga-echo.csv]
2026-10-08 FFT bench F3: Gowin FFT core runs on the Tang Nano 20K
    - top.v: 'F' command feeds the shared buffer through fft_1024 (IPUG503 handshake),
    cycle counter start..eoud, 39 ms watchdog
    - ESP32 forwards 'F'; fft_bench.py fpga scores it with the same gate
    - First result: 7/8 signals correct; full_scale wrong (inputs at +-32767 wrap
    inside the core); 7190 cycles = 266.3 us at 27 MHz; 1426 logic, 8 BSRAM, 2 DSP
    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
    [f3-fpga-gowin.csv]
2026-10-08 FFT bench: F3 write-up in the weekly report and results doc
    - Part B filled: H1/H4 partly confirmed, full-scale wrap finding, three-way table,
    resources, ease-of-use additions
    - Section 3A explains ESP32 SIMD vs plain C
    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
2026-10-08 FFT bench: time split on the FPGA and the ESP32
    - FPGA stamps the cycle counter at sod/eod/busy/soud: load 1024, compute 5141,
    unload 1024 cycles (one butterfly per clock)
    - ESP32 times copy / FFT / bit-reverse separately (fastest of 20, whole-run cross-check)
    - Reply protocols carry the split; fft_bench.py prints and saves it
    - Weekly report section 8 explains the method; speed tables now include the copy step
    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
    [e1-esp32-ansi.csv, e1-esp32-simd.csv, f3-fpga-gowin.csv]
2026-10-08 FFT report: microphone input levels (section 9) and current FPGA resource usage
    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
2026-10-09 Free simulation of the Gowin FFT core (Icarus + gate-level .vo) matches the board
    - fpga_fft/sim/tb_fft.v drives the core per IPUG503, records phase stamps
    - fft_bench.py sim [--board]: scores the simulation, optionally compares bit for bit
    - Report section 10 (why Gowin tools can't, before/now, how, result) and a note on
    synthesis (1600) vs place & route (1612) resource counts
    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
    [f3-sim-gowin.csv]
2026-10-09 FFT sim: bit-for-bit identical to the board on all 9 signals
    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
    [f3-sim-gowin.csv]
2026-10-09 FFT report section 11: complex bins, bit reversal on both devices, error plots
    - plot_fft_report.py pulls raw spectra from the FPGA and ESP32 and draws 7 figures
    - Gowin's input-side bit reversal confirmed from the gate-level model (idx wiring)
    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
    [spectra-1024.csv]
2026-10-09 FFT bench: 54 MHz PLL build halves the FFT time (133.1 us), results bit-identical
    - fft_link.v: clock-independent core (CLK_MHZ parameter), reports its clock in replies
    - top.v (27 MHz) and top_54.v (rPLL x2); build.sh MHZ=27|54
    - ESP32 forwards the FPGA's clock; report section 12
    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
    [f2-fpga-echo-54mhz.csv, f3-fpga-gowin-54mhz.csv]
2026-10-09 FFT bench: 81 MHz PLL build (88.8 us, bit-identical); report compares 27/54/81 MHz
    - pll_clk.v: reusable rPLL wrapper; top_54.v / top_81.v use it; build.sh MHZ=27|54|81
    - External links unchanged at every clock (UART 1 Mbaud, Mac link 2 Mbaud)
    - Report section 12: three clock rates, speed per MHz, why the ESP32 clock can't follow
    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
    [f2-fpga-echo-81mhz.csv, f3-fpga-gowin-81mhz.csv]
2026-10-09 HDMI demo H1: 720p colour test pattern, simulated bit-exact, builds and runs
    - video_timing (CEA-861 720p), test_pattern, TMDS encoder (DVI 1.0), hdmi_out (OSER10 + TLVDS_OBUF)
    - top_hdmi: rPLL x55/4 = 371.25 MHz, CLKDIV /5 = 74.25 MHz; ESP32 benchmark kept on the crystal
    - tb_hdmi + check_hdmi.py: one full frame decoded from the serial lanes, 20/20 checks pass
    - build: DESIGN=hdmi fpga_fft/build.sh; timing met (pixel clock 74.25 -> 93.3 MHz)
    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
2026-10-09 HDMI demo H2: test-tone spectrum on screen (tone -> window -> FFT -> dB -> bars)
    - tone_gen (sweep + 1 kHz at -40 dB), spectrum (gain/clamp params, Hann window, ping-pong,
    2nd FFT core, power -> log2 -> height), bar_display (double-buffered, gridlines)
    - tb_h2_audio: samples, window, heights bit-exact with Python models; FFT passes the gate
    - tb_h2_video: every pixel of a frame matches the layout
    - build: 3199 logic, 19 BSRAM, 7 DSP; pixel clock met to 81.5 MHz
    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
2026-10-09 HDMI demo H3: live INMP441 spectrum, gain from the 24-bit word, buttons for source/gain
    - i2s_master_rx: extra 24-bit output (audio sims still pass)
    - mic_source (3.09 MHz SCK, 48.34 kHz, gain 0..7 = +0..+42 dB, saturation), buttons debouncer
    - top_hdmi: mic on pins 25/26/29, buttons 88 (source) / 87 (gain), LEDs show gain/source
    - tb_h3_mic: 8 gains bit-exact incl. saturation; SCK 24 clocks, samples every 1536 clocks
    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
2026-10-09 H3 debugging: ESP32 mic tools, FPGA mic diagnostics LEDs, weaker SCK/WS drive
    - firmware/mic_test: INMP441 read by the ESP32's I2S, level/correlation per slot
    - firmware/mic_stream: same, streamed in the FPGA frame format for inmp441_viewer.py
    - top_hdmi: LED_DIAG shows SD high/low/non-zero activity; SCK/WS DRIVE=4
    - finding: the mic works on the ESP32 (220 Hz, 1 kHz correct); the 20K wiring was unstable
    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
    [mic_stream.ino, mic_test.ino, top_hdmi.v]
2026-10-09 H3: ESP32-relayed microphone as a third source (mic -> ESP32 -> UART 2.97 Mbaud -> FPGA)
    - firmware/mic_relay: I2S 48 kHz, 32-sample packets (sync, seq, 24-bit samples, sum16)
    - relay_rx: packet parser, drops bad/abandoned packets; gain24 shared by both mic paths
    - S1 cycles relay -> tone -> direct mic; LEDs show source and input health
    - tb_h3_relay: 192/192 samples bit-exact at the ESP32's real baud; corrupted packet dropped,
    half packet abandoned; tb_h3_mic still bit-exact after the gain refactor
    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
2026-10-21 HDMI demo H3 works on the monitor: direct INMP441 on pins 25/26/29 at 964 kHz
    - H3: mic_source bit clock 74.25 MHz / 77 = 964 kHz (15,067 Hz), SCK/WS 8 mA,
    starts on the direct mic with 0 dB gain
    - Mic check build for the 20K (top_mic_uart.v, DESIGN=mic): mic -> UART -> ESP32
    -> viewer, built-in 1 kHz test tone (S1), raw-bits mode (S2, host/sd_raw.py)
    - i2s_master_rx: SCK/WS from flip-flops; WS changes on the falling SCK edge;
    CAP_START default 1. Mic models in the testbenches now timed like the INMP441
    - Tang Nano 4K top.v back on the real mic (GEN_MODE 0); used as the swap test
    - Viewer understands the 27 MHz clock code; bridge at 1 Mbaud for the 20K
    - Docs: 12-hdmi-demo.md section 5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
2026-10-22 HDMI demo H4: labels, kHz axis, peak readout; mic at 44,621 Hz
    - Mic sample rate raised 15,067 -> 29,748 -> 44,621 Hz (MIC_BCLK_DIV 26 in video_h3.v,
    bit clock 2.856 MHz), each step confirmed on the monitor
    - H4: 80x45 text grid with a project-made 5x7 font (gen_h4_text.py writes rom_font,
    rom_text, rom_ticks); title, source and rate, gain, dB labels, kHz axis and ticks
    per source; text_overlay.v adds 4 clocks (address stage for timing)
    - peak_readout.v: tallest bin of the latest FFT, shown ~4x/s as Hz and dB
    - Test tone now runs at the mic's sample rate; readout follows the sweep (it used
    to keep the first tallest bar of each 0.23 s window and trailed the tone)
    - Sims: tb_h4_frame +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
2026-10-22 HDMI demo: drop the ESP32 relay source; S1 toggles direct mic <-> test tone
    The direct INMP441 works, so the relay path (relay_rx + gain24) is out of the
    HDMI build. One sample rate (44,621 Hz) for both sources: one kHz axis, one
    peak formula. LEDs 1 and 3 now unused. Text ROMs regenerated; tb_h4_frame and
    tb_h4_peak (fixed + sweep) pass; timing met at 74.8 MHz. Sweep readout and the
    two-way S1 checked on the monitor.
    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
2026-10-29 HDMI demo: take the ESP32 UART benchmark out of the HDMI build
    fft_link (the finished FFT benchmark, with its own 1024-point FFT on pins
    27/28) was still built into top_hdmi but unused by the demo. Removed; it
    keeps its own build (top.v). Demo alone: 2,531 logic (12 %), 920 registers,
    12/46 BSRAM, 7.5/24 DSP; 74.25 MHz clock reaches 83.3 MHz (was 74.8).
    Checked on the monitor. New weekly report 2026-11-01 with the per-block
    resource table and a background section on timing (STA).
    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
2026-10-29 HDMI demo: mic at 22,311 Hz (MIC_BCLK_DIV 26 -> 52)
    Half the sample rate: 0-11.2 kHz on screen, 21.8 Hz per bar. The test tone
    follows (TONE_DIV = 64 x 52, sweep step doubled to keep ~10 s), kHz labels
    every 1 kHz when the span is under 15 kHz. tb_h3_mic, tb_h4_peak (fixed +
    sweep), tb_h4_frame pass; 80.5 MHz achieved. Works on the monitor.
    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
2026-10-29 HDMI demo: spectrum floor at -80 dB (rescaled 7.5 px/dB)
    - spectrum/bar_display/peak_readout take FLOOR_DB (default 100 keeps H2
    bit-identical); H4 uses 80: bars 25% taller, gridlines + labels at
    0/-20/-40/-60/-80 dB, PEAK level = h/7.5 - 80
    - timing: PEAK level maths split over two clocks, bar-height maths in its
    own pipeline stage (20-bit unsigned) -> 85.0 MHz vs 74.25 needed
    - build.sh: also compare each clock's achieved vs required frequency
    (Gowin's TNS summary skips the CLKDIV clock, so a 66.8 MHz build passed)
    - sims: check_h4 reads new gridlines and dB labels; tb_h4_peak at FLOOR 80
    - docs: report section 9, timing background moved to Appendix A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
2026-11-04 HDMI demo: remove the test tone; mic is the only source
    - video_h3: tone_gen and the mic/tone selector out; mic straight to the FFT
    - top_hdmi: S1 unused until the bars/spectrogram switch; LED 0 off
    - gen_h4_text: one header ("MIC DIRECT 22311 Hz") and one tick set
    - tone_gen.v kept (H2, mic-UART build, tb_h4_peak)
    - build: 2,207 logic (-322), 771 regs, 11/46 BSRAM, 6.5 DSP;
    74.27 MHz vs 74.25 needed (dB conversion in spectrum.v, to be split)
    - docs: report 2026-11-08 (spectrogram plan, RAM notes), 12-hdmi-demo 6.5
    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
2026-11-04 HDMI demo: split the dB conversion over two clocks (74.27 -> 89.0 MHz)
    spectrum.v stage 4 (top bit -> shift -> log table -> add) was 19 cells in
    one clock, 13.24 ns of a 13.47 ns period after the tone removal moved the
    placement. Now 4a registers e + the 5 bits below the top bit, 4b does the
    table and add. Bar heights bit-identical in simulation (2,048/2,048), one
    clock later; tb_h4_peak PASS both modes. 2,278 logic, 11 BSRAM, 6.5 DSP;
    slowest path back inside the Gowin FFT core. Not yet seen on a monitor.
    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
2026-11-04 HDMI demo: S1 switches bars <-> spectrogram screen (step 2)
    - top_hdmi: mode register toggled by S1 (start: bars); LED 0 = spectrogram
    - text ROM holds a whole page per mode, address {page, row, col};
    page 1: "LIVE SPECTROGRAM" title, same source/gain/PEAK, plot empty
    - text_overlay: page input; page 1 draws text only
    - sims: tb_h4_frame/check_h4 take the page; page 0 pixel-identical
    - build: 2,289 logic, 11 BSRAM, 6.5 DSP, 81.6 MHz; checked on the monitor
    - docs: report 2026-11-08 section 9 (layout A chosen for step 3)
    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
2026-11-04 HDMI demo: 50% overlap, an FFT every 512 samples (step 4)
    - spectrum.v: ring of 2048 raw samples, Hann window applied as the FFT
    reads; OVERLAP parameter (1 = every 512 samples, 0 = old blocks,
    bit-identical on the same clock); video_h3 uses 1
    - 43.6 FFTs/s: spectrogram shows 5.9 s, time labels -5s..now every 1 s
    - sims: OVERLAP=1 even FFTs identical to the old ones; tb_h4_peak sweep
    range for overlap; tb_h5_chain slope 1.50 rows/column; pages pass
    - build: 2,645 logic, 27/46 BSRAM, 7 DSP, 75.5 MHz (slowest: rom_text
    lookup); checked on the monitor
    - docs: report 2026-11-08 section 11, figure
    Claude-Session: https://claude.ai/c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
2026-11-04 docs: design report for the HDMI spectrum/spectrogram demo
    docs/reports/2026-11-08-design.md explains the whole design as of 0211e95,
    one section per part: clocks, I2S sampling, gain/clamp, the ring buffer and
    overlap, window + Gowin FFT, the height pipeline, bars (double buffer),
    spectrogram (picture RAM, scrolling), peak readout, text/font pipeline
    clock by clock, video timing and HDMI, buttons/LEDs, a RAM map of all 32
    block RAMs by type, resources per module, timing, verification, glossary.
    Linked from the weekly report.
    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
2026-11-06 HDMI demo: spectrogram in 1 dB steps, viridis colours, white above -50 dB
    Each point is a 5-bit level: 0 = below -80 dB (black), 1-30 = -80..-51 dB
    (viridis), 31 = -50 dB and louder (white). The picture memory is split
    into 4-bit + 1-bit arrays (16 + 4 block RAMs). New colour scale and
    labels, '>' glyph. Frame test now covers all 32 levels. Build 36/46
    BSRAM, 83.9 MHz; checked on the monitor.
    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
2026-11-06 HDMI demo: spectrogram rows, 0-4 kHz at one bin per row
    Bins 0-183 (0-4 kHz) get one row each (72 % of the height, 21.8 Hz per
    row); bins 184-511 share rows 184-255, the loudest of 4-5 bins kept.
    Write side now 4 clocks; dashed line at 4 kHz; kHz labels 0-4, 6, 8, 10.
    Tests updated (frame test derives each row from its own bins; chain
    sweep now 3 rows per column). Design report §8/§13/§14 and weekly
    report §14 updated. Build 36/46 BSRAM, 83.9 MHz; checked on the monitor.
    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
2026-11-06 HDMI demo: demo sweep through the MAX98357A speaker; start on spectrogram
    sweep_player.v (separate from the mic -> FFT -> screen chain) plays a
    200 Hz -> 4 kHz linear sweep in 4 s, -20 dBFS with 512-sample fades, over
    I2S at 48,339.8 Hz to the board's MAX98357A (pins 56/55/54, PA_EN 51).
    External button on pin 27 (to 3.3 V, pull-down) starts it; LED 1 shows
    it playing. build.tcl frees the SSPI pins. Display starts on the
    spectrogram. tb_sweep + check_sweep.py decode the I2S wires and compare
    every sample with a model. Build 37/46 BSRAM, 86.5 MHz; checked on the
    board.
    Claude-Session: https://claude.ai/code/session_01FDyyRsyoxvz6WUd8hJG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
2026-11-06 HDMI demo: demo sweep toggles on/off and sweeps up and down
    The pin-27 button now toggles the sound. While on, sweep_player sweeps
    200 Hz -> 4 kHz -> 200 Hz, 4 s each way, repeating; the step holds one
    sample at each turn so the phase stays continuous (no click). Off fades
    out from wherever it is; a press during the start-up quiet cancels, a
    press during the fade-out turns it back on. tb_sweep/check_sweep.py now
    model the whole player with presses (short 8-press schedule, +long full
    cycle): every sample matches. Build 37/46 BSRAM, 79.4 MHz; checked on
    the board.
    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
2026-11-06 HDMI demo: demo sweep with three tones (main, 1.5x and 2x at -12 dB)
    sweep_player.v adds two tones that follow the main sweep: 1.5x (300 Hz
    <-> 6 kHz) and 2x (400 Hz <-> 8 kHz), each AMP/4 (-12.04 dB), turning and
    fading with it. One sine table, read three times per sample; peak of
    the sum 4915 (-16.5 dBFS). check_sweep.py models all three: every sample
    matches (short and full-length runs); independent measurement gives
    ratios 1.500/2.000 and -12.04 dB each. Build 37/46 BSRAM, 79.2 MHz;
    checked on the board.
    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
2026-11-06 HDMI demo: third screen, the raw waveform; S1 cycles three modes
    wave_display.v shows the FFT's input samples like an oscilloscope:
    1,024 samples (45.9 ms), edges at the peak of a -40 dB tone (+-1311),
    red at the edges, grid at the -50/-60 dB peaks, triggered on a rising
    zero crossing, double-buffered (1 BSRAM). S1 cycles spectrogram -> bars
    -> waveform (LED 3 = waveform); text ROM gets a third page (14-bit
    address, 9 BSRAM). New tb_h6_wave + check_h6.py checks every plot pixel
    against the fed samples; bars and spectrogram page tests rerun. Weekly
    report status/summary/checklist brought up to date, section 18; design
    report section 8A and RAM map. Build 42/46 BSRAM, 77.5 MHz; checked on
    the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
2026-11-06 HDMI demo: music from the Mac over the board's USB cable; auto-rotate
    audio_rx.v receives 24,170 Hz mono packets (B5 6A | seq | 32 samples |
    sum16) at 2.97 Mbaud on pin 70 from the BL616 USB serial port, buffers
    2,048 samples, plays them via i2s_tx.v (the sweep player's I2S output)
    at 48,340 Hz with a fill-in sample, and sends credits/status back on pin
    69. host/play_song.py (ffmpeg -> packets, credit flow control) and
    make_test_song.py (piano "Happy Birthday"). The pin-27 button now
    freezes/resumes a 10 s rotation of the three screens. The demo sweep is
    archived (fpga_fft/archive/, tag demo-sweep). USB-serial speed tests
    (echo/count designs, uart_speed_test.py): Mac -> FPGA lossless at
    170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
